kamelele/Velluneo-2.0/README.md

# Velluneo-2.0

[Projekt E27 z wymiennym wkładem LED](hardware/E27/README.md)
