kamelele/Velluneo-2.0/hardware/E27/outputs/Zasilacz_8S_D4/README.md

# Velluneo E27 8S-D4

Open [Zasilacz_8S_D4.kicad_pro](Zasilacz_8S_D4.kicad_pro) in KiCad 10.0.8. This draft adds a hardware inhibit to the 8-LED supply while its 3.3 V logic rail is low. The [70 × 34 mm board](Zasilacz_8S_D4.kicad_pcb) is an unrouted placement study.

- [Schematic](Zasilacz_8S_D4.kicad_sch)
- [3D top](8S-D4-top.png) · [3D bottom](8S-D4-bottom.png)
- [Design decision and evidence](../../workflow/8s/driver-8s-d4-inhibit.md)

Retained fault state after full rail loss, independent insulation checks and routing remain open. The earlier [D3 study](../Zasilacz_8S_Draft/README.md) is available as a baseline.
