kamelele/Velluneo-2.0/hardware/E27/outputs/Raport_E27_RevB.md

# Żarówka E27 z wymiennym wkładem LED

**Rewizja B zasilacza · prototyp laboratoryjny · 9 listopada 2026**

Płytka zasilacza ma **66 × 34 mm**, o 25,2% mniejszą powierzchnię niż Rev A. C2 (maks. 18 mm), PCB (1,6 mm) i F1 (5,35 mm) dają razem około 25 mm. Po weryfikacji rysunku RV1 dla prostych wyprowadzeń przyjęto konserwatywnie do 22 mm od góry. Daje to **około 29 mm budżetu wysokości** przed doliczeniem montażu i obudowy. Rzeczywistą wysokość RV1 ustali próbka z określonym formowaniem wyprowadzeń. Cel **38 × 17 × 15 mm** pozostaje otwarty. Płytka służy do walidacji elektrycznej poza korpusem A60. [Rysunek wymiarowy Littelfuse TMOV](https://www.littelfuse.com/assetdocs/varistors-tmov-datasheet?assetguid=bd475732-1071-4352-b8aa-f78b0007eb05)

Wkład Ø30 mm nadal ma 16 diod Cree JE2835B i dwa szeregi po osiem LED, każdy z własnym regulatorem 127 mA. Interfejs wkładu pozostaje trzystykowy (A+, K1, K2). S1 i czujnik TH1 trafiają do J2. Przewody J2/J3 lutuje się do PCB z osobnym odciążeniem mechanicznym. Dobór blokowanego złącza poza płytką, bariery korpusu i systemu prowadzenia przewodów wymaga sprawdzenia z mechaniką. Katalogowy model optyczny Rev A daje 764, 844 i 833 lm odpowiednio dla 2700, 4000 i 6500 K. Wynik zależy od binu, temperatury i dyfuzora.

W pakiecie należy otworzyć `Zasilacz_RevB/Zasilacz_RevB.kicad_pro` oraz `Wklad_LED/Wklad_LED.kicad_pro`. Dla zasilacza obowiązuje BOM Rev B. Raport Rev A zawiera dane wkładu, mechaniki i specyfikację zamówienia transformatora.

**Aktualizacja przed próbami.** W obwodzie S1 trzeba skorygować napięcie sterujące SHDN. Szczegóły są w [planie prób](Plan_prob_RevB.md).

## Ochrona wejścia i kondensatory

- **F1** to ceramiczny Schurter 3403.0271.23, T500 mA / 277 VAC. Karta podaje 1,5 kA dla 277 VAC w warunkach UL albo 250 VAC w warunkach IEC. Producent podaje typową całkę przedłukową 0,62 A²s przy 10 × In. Koordynacja wejścia w gotowym zespole oraz spodziewany prąd zwarciowy wymagają oddzielnej próby. [Schurter UMT-H](https://www.schurter.com/en/datasheet/UMT-H)
- **R1** to bezpiecznikowy Vishay AC01000902209JBMCS (22 Ω ±5%, 1 W przy 70°C). F1 i R1 są kolejno w linii L, a termicznie chroniony RV1 znajduje się za R1, równolegle do wejścia mostka. Zweryfikować energię impulsu i awarie R1/RV1, także przy rozgrzanym zespole. [Vishay AC-CS](https://www.vishay.com/docs/28909/acxxcs.pdf)
- **BR1** to onsemi MB10S, 1 kV / 0,5 A, o udarze katalogowym 35 A dla pojedynczej półfali 8,3 ms. Piny 1/2 to +/−, a 3/4 to AC. Przed obsadzeniem porównać oznaczenia części z rysunkiem onsemi i wykonać test diod. **L1** to Würth 768772102, 1 mH / 0,5 A. Typowy prąd 10% spadku indukcyjności wynosi 0,55 A, więc model rozruchu przyjmuje granicę bez wpływu L1. [onsemi MB10S](https://www.onsemi.com/download/data-sheet/pdf/mb10s-d.pdf) · [Würth 768772102](https://www.we-online.com/components/products/datasheet/768772102.pdf)
- **C2** zmniejszono z 15 do 10 µF / 450 V. Rubycon 450BXW10MEFR10X16 ma katalogową trwałość 10 000 h przy 105°C w warunkach serii. **C6** to Nichicon UCM1H471MNJ1MS 470 µF / 50 V w obudowie SMD nominalnie 12,5 × 13,5 mm, katalogowo 5000 h przy 105°C. Zmierzyć tętnienia i temperaturę obudów po stabilizacji termicznej, przy niskim i wysokim napięciu wejścia. [Rubycon, karta pozycji](https://www.digikey.com/es/products/detail/rubycon/450BXW10MEFR10X16/6049847) · [Nichicon UCM](https://www.nichicon.co.jp/english/products/pdf_x/Chip_Type_Aluminum_Electrolytic_Capacitors_E.pdf)

**Obliczenia rozruchu.** Model idealnego skoku w szczycie 253 VAC (357,8 V) dla pustego C2 przy 12 µF i R1 = 20,9 Ω daje 17,1 A na początku, 0,77 J energii zgromadzonej w C2 i 0,0368 A²s prądu ładowania. Obliczenie pomija L1, spadek mostka i impedancję sieci. Ocenę F1, mostka i R1 oprzeć na zarejestrowanych przebiegach zimnego i gorącego rozruchu oraz na danych o impulsach powtarzalnych. Przy 207 VAC, 8 µF i przyjętym poborze 8,4 W z szyny, po 10 ms bez doładowania model daje około 252 V na C2. Dla 12 µF i sumy R2 + R3 około 1,03 MΩ model daje ok. 22 s od 358 V do 60 V. Czas ten dotyczy szyny wewnętrznej. Zmierzyć go oraz czas rozładowania styków dostępnych użytkownikowi.

## Zapas napięcia i odcięcie wyjścia

Dzielnik R14/R15 to 226 kΩ i 10,0 kΩ, oba ±0,1% i ±25 ppm/K. TPS26600 nominalnie odcina przy 28,08 V. Dla progu komparatora 1,170–1,225 V i prądu wejściowego ±100 nA obliczony próg wynosi **27,54–28,99 V** przy początkowej tolerancji rezystorów. Przy osobnym skrajnym dryfcie każdego rezystora o 0,2% dla zmiany temperatury o 80 K przedział poszerza się do **27,43–29,10 V**. Analogicznie policzona górna granica Rev A wynosiła 30,24 V przy początkowej tolerancji. Te przedziały dotyczą powolnej zmiany napięcia. Zmierzyć także maksymalne chwilowe napięcie na A+ przy uszkodzeniu regulacji, rozłączeniu wkładu, krótkich impulsach i ponownych załączeniach. Celem projektu jest **≤30 V na dostępnym wyjściu** w zdefiniowanych próbach. [TI TPS26600](https://www.ti.com/lit/ds/symlink/tps2660.pdf)

Dzielnik CV R10/R11 to 110 kΩ i 5,62 kΩ, oba ±0,1%. Z zakresem odniesienia LYT6073C 1,25–1,28 V przy 25°C daje **25,67–26,38 V** przed doliczeniem przesunięcia masy czujnika prądu, tętnień i dynamiki. Górną granicę tego przedziału od obliczonego minimum OVP po dryfcie rezystorów dzieli około 1 V. W próbach sprawdzić zarówno samoczynne wyłączenia na gorąco, jak i zapas dla LED o najwyższym zimnym Vf. [Power Integrations LYTSwitch-6](https://www.power.com/sites/default/files/documents/lytswitch-6_family_datasheet.pdf?language=en)

Limit sumarycznego prądu flybacka z R9 = 0,11 Ω wynosi **326 mA typ.** przy tabelarycznym 35,90 mV. Skraje 35,17–36,62 mV i R9 ±1% dają **317–336 mA** przy 25°C. Wartość 318 mA w starszej dokumentacji korzystała z przybliżenia 35 mV. W próbie uwzględnić temperaturę i zmierzyć spadek bezpośrednio przy padach R9. [Power Integrations LYTSwitch-6, tabela parametrów wtórnych](https://www.power.com/sites/default/files/documents/lytswitch-6_family_datasheet.pdf?language=en)

## Wykonanie i kolejność prób

- Rozpocząć od prób części wtórnej z odłączoną stroną pierwotną i izolowanym zasilaczem laboratoryjnym z ograniczeniem prądu. Zmierzyć oba prądy, reakcję S1/S2 i TH1 oraz próg i dynamikę OVP. Przydatny jest sztuczny wkład z kontrolowanym Vf oraz wszystkie trzy rzeczywiste warianty LED.
- Przed próbą sieciową potwierdzić rysunek i wykonanie transformatora T1, izolację elementów przekraczających barierę, odległości całego zespołu oraz wytrzymałość przyrządu i warunki stanowiska. Puste pasmo miedzi z raportu KiCad dotyczy pliku PCB. Obudowy elementów, przewody, połączenia lutowane i montaż zmieniają geometrię zmontowanego zespołu. T1 nadal wymaga kwalifikacji dostawcy według specyfikacji Rev A.
- Zweryfikować własne pola lutownicze F1, R1 i C6 z rysunkami producentów oraz fizyczną próbką. Modele 3D części własnych przybliżają obrysy, a BR1 ma widoczne pola lutownicze bez modelu korpusu. Uzgodnić montaż dwustronny, termicznie ciężkie elementy i montaż przewodów. Gerbery oraz pliki położeń mają status do przeglądu przed zamówieniem.
- Po sprawdzeniu wejścia i zabezpieczeń zmierzyć sprawność, PF, tętnienia prądu LED, temperatury elementów, emisję i odporność EMC. Dla każdej barwy zmierzyć strumień po ustaleniu temperatury. Próby sieciowe i pojedynczych uszkodzeń prowadzić na osłoniętym stanowisku przez osobę uprawnioną do pracy z napięciem sieciowym.

Wycena części w BOM jest orientacyjna i podana na progi dystrybutorów. W obserwowanych ofertach F1 kosztował 1,9518 USD/szt., a R1 0,6691 USD/szt. przy 100 szt. Brakuje pełnej wyceny transformatora, montażu dwustronnego i wiązek. W katalogu JLCPCB dla L1 widniał zerowy stan przy sprawdzeniu. [DigiKey F1](https://www.digikey.com/en/products/detail/schurter-inc/3403-0271-23/9094779) · [DigiKey R1](https://www.digikey.com/en/products/detail/vishay-beyschlag-draloric-bc-components/AC01000902209JBMCS/28721869) · [JLCPCB L1](https://jlcpcb.com/partdetail/WurthElektronik-768772102/C7194056)
