kamelele/Velluneo-2.0/hardware/E27/workflow/8s/driver-pin-review.md

# 8S driver pin intent and protection review

Task E27-8S-PINS covers the driver only. Codex owns this document and the workflow index entry. Inputs are Velluneo commit `f24547256b1a895d7f68d739b982ea7abf709427`, approved requirements digest `3cdd9d3acd8b98e729ecd689bb8b76b2e1260cf768094b1bc6902acbba21121f`, the [circuit proposal](driver-circuit-proposal.md) and the manufacturer documents cited below. This document records the candidate physical pin assignments and the design decisions that still affect net membership. It is evidence for REQ-8S, REQ-CC and OPEN-CC. The whole-board connectivity contract and schematic-stage approval are pending.

## Pin assignments for the changed circuit

- **U1 LYT6073C-TL, InSOP-24D.** Pin 1 IS → LED_RTN; 2 GND and 5 SR → SEC_GND; 3 FB → FB divider and C8; 4 BPS → C9 and existing BPS fault-injection branch; 6 VOUT → separate VO supply; 7 FWD → R8/C7; 13 V → primary line-sense divider; 14 BPP → primary bias and bypass; 16–19 S → P_0; 24 D → T1 drain end and RCD clamp. Leave pins 8–12 open as specified, and choose to leave optional pin 15 open. Positions 20–23 have no lead in the package drawing. Grounding SR is the documented diode-rectification option. Keep SEC_GND and LED_RTN joined through the sense path only, including the intentional clamp across R9. The InSOP footprint description says 17 leads, while the manufacturer drawing shows 20 physical leads. Verify the actual geometry and pads against the drawing before using that footprint. [Power Integrations, Figure 5 and pin functions](https://www.power.com/sites/default/files/documents/lytswitch-6_family_datasheet.pdf#page=3)
- **U2 TPS26600PWPR, PWP0016A.** Pins 1/2 IN → RAW; 3 UVLO and 8 RTN → EF_RTN; 5 OVP → midpoint of the 226 kΩ/10 kΩ divider, both ±0.1%; 6 MODE → 402 kΩ to EF_RTN; 7 SHDN → S1/TH1 enable circuit; 9 GND → LED_RTN; 11 ILIM → 30.1 kΩ to EF_RTN; 12 dVdT → 47 nF to EF_RTN; 15/16 OUT → FUSED, upstream of S2. The exposed pad, library number 17, joins EF_RTN alongside pin 8. Pins 4 and 13 are NC. IMON 10 and FLT 14 are unused in the functional candidate. For a verification fixture, provide access to FLT with its own pull-up to observe OVP timing. Any production test point must be included in the final pin graph. Connect at least 0.1 µF effective local bypass on both IN and OUT to system GND (LED_RTN), with OUT bypass upstream of S2. EF_RTN remains separate from LED_RTN in the preferred candidate. TI also documents a local RTN/GND tie for applications that omit reverse-input protection. Decide whether internal RAW reversal is credible before simplifying to that option. Assess output backfeed separately. [TI TPS2660x, pin functions, §9.3.5.5, Fig. 70 and §12.1](https://www.ti.com/lit/ds/symlink/tps2660.pdf)
- **U101 TPS7A1633DGNR, DGN.** Pins 5 EN and 8 IN → RAW; 1 OUT → 3V3_PERMIT; 4 GND and pad 9 → LED_RTN in the preferred candidate. This changes the previous proposal to avoid placing the regulator and capacitor return currents on the eFuse internal RTN reference. Pin 2 is DNC on the fixed-voltage device. Leave 3 PG, 6 NC and 7 DELAY open because this candidate uses the eFuse ramp and no regulator power-good reset. Return both local regulator capacitors to LED_RTN and size the output capacitor for at least 2.2 µF effective. The 1 kΩ series resistor and 10 kΩ pull-down set a nominal ~3.0 V SHDN high when the loop is closed. Return the SHDN pull-down to LED_RTN. Closed-loop DC load is about 0.30 mA before SHDN pin current. As a part-count alternative, screen a RAW-fed 91 kΩ/10 kΩ permit divider. Ideal SHDN is 1.41 V at 14.25 V RAW and 3.37 V at 34 V RAW. A passive implementation still needs leakage, transient, contact and short-latch checks. Check SHDN at both references through start-up and input transients, including regulator pass short. Use an output capacitor rated for the credible fault voltage after derating, or bound that voltage independently. Keep eFuse mode, ramp, OVP and ILIM networks on EF_RTN. Confirm dry-contact operation of S1 and TH1 at that current and the lowest voltage. [TI TPS7A16, section 5](https://www.ti.com/lit/ds/symlink/tps7a16.pdf#page=4) · [TI reference with DGN exposed pad 9](https://www.ti.com/lit/ug/tiduep8/tiduep8.pdf)
- **External ports.** J_LED-1 → LED+ after S2. J_LED-2 → LED_RTN. Put the discharge resistor across those two driver terminals. J2-1 → 3V3_PERMIT side of the S1/TH1 loop; J2-2 → return to the SHDN bias network; J2-3 → FUSED; J2-4 → LED+. The proposed functional order is contacts mate, S2 closes, then S1 permits output. Confirm physical contact numbering, keying, minimum contact load and contact sequence before approving the whole-board pin graph.
- **Power stage interface.** T1 winding-end assignments are provisional: primary dot 2 at P_BULK, pin 1 to drain; auxiliary dot 4 at P_0, pin 3 to P_AUX; secondary dot 6 at S_SW, pin 5 to RAW. Winding polarity and the end-to-pad mapping need a controlled drawing from the transformer supplier. Use the Rev G RFQ as the starting drawing with the new operating point. The independent high-voltage and high-current corners give 27.07 V × 285 mA ≈ 7.7 W as an upper sizing screen, versus 6.60 W in the Rev G quote basis. Recheck hot saturation, leakage, diode and FWD ringing, AUX bias and RCD stress. [Rev G transformer RFQ](../../outputs/Zasilacz_RevG_Moc/RFQ_T1_EE16.md)

## Voltage window and protection behavior

The following are calculated screening conditions. They use the 25°C flyback CV limits 26.33–27.07 V and the previously calculated eFuse limits. Use `delta = V(EF_RTN) − V(LED_RTN)` as a signed input. Characterize it with the actual control network connected.

- **Nuisance trip:** ignoring the small sense drop for conservative no-load screening, the lowest estimated eFuse rising threshold minus maximum CV is 27.54 − 27.07 = **0.47 V**, before reference offset and ripple. The design condition is `V(RAW relative to LED_RTN, normal peak) < 27.54 V + delta_min`, with margin for tolerances.
- **Contact voltage:** high static trip is 28.99 V relative to EF_RTN. Reserve **1.01 V minus delta_max** for dynamic effects, uncertainty and any required margin to 30 V, before crediting series drops. The TI +0.3 V RTN-to-GND absolute-maximum limit is a stress rating. An open top resistor or shorted bottom resistor can select the factory 31–34 V OVP, so these divider faults require the independent flyback bound to hold. As a sensitivity point only, +0.30 V leaves about **0.71 V**. The datasheet’s typical OVP timing is to FLT. Verify actual peak and FET turn-off independently on RAW, FUSED and both contacts.
- **Recovery:** the falling threshold can be 25.53–26.62 V relative to EF_RTN. At delta = 0, a 27.07 V no-load bus can remain above the highest rearm threshold by 0.45 V and above the lowest by 1.54 V. Cycling SHDN clears an overload latch, while recovery from OVP still requires RAW to fall below the falling threshold. Treat mains removal and restoration after a genuine trip as a candidate recovery method. Verify that normal insertion and all input ramps avoid nuisance trips. If automatic recovery is required, the present CV/OVP pairing needs a controlled reset of RAW or another protection topology.
- **Discharge:** with 4.7 kΩ +1%, 10 µF and no leakage, the 30-to-5 V decay takes **85.1 ms** after isolation, leaving **14.9 ms** for switch and circuit delays. At 30 V the resistor dissipates up to **0.194 W** at −1%. A 10 kΩ ±1% alternative with ≤4.7 µF gives **85.1 ms** and ≤0.091 W. Prefer the lower-loss option only after total accessible-side capacitance, leakage and measured timing justify it. In a stuck-S2 test include the eFuse OUT bypass, and capture whether opening S1 still removes energy. The reservoir upstream stores about **0.168 J** at 470 µF and 26.70 V. Test the pulse under normal hot insertion and separately assess the shorted-eFuse case with S2 operating. [TI TPS2660x, electrical and timing characteristics](https://www.ti.com/lit/ds/symlink/tps2660.pdf) · [Prior protection study](output-protection-study.md)

## Corrections from the baseline review

- **D8 polarity.** The previous proposal reversed the archived Rev K clamp. For the positive short transient, the candidate preserves Rev K polarity: D8 anode to LED_RTN and cathode to SEC_GND. The Power Integrations diode example uses the same positive-transient clamp function. The forward drop of a diode alone cannot establish compliance with all IS limits. Capture both polarities, including the energy from C6. The 27 V absolute maximum at VO also requires checking the pass regulator, including its shorted condition. The internal VO bleed acts through that regulator and cannot be credited as a guaranteed RAW bleed. [Power Integrations, Fig. 10 and absolute maximum ratings](https://www.power.com/sites/default/files/documents/lytswitch-6_family_datasheet.pdf#page=10)
- **Short-circuit latch.** The 402 kΩ mode selects active current limiting with latch-off on eFuse thermal shutdown. The 30.1 kΩ ILIM sets roughly 0.40 A nominal, above the flyback's ~0.285 A high corner. A sustained current-limited fault may never thermally latch U2, so eFuse alone does not carry forward the old comparator/latch behavior. Keep an explicit short-circuit detection and reset function in the design budget. Evaluate a single output voltage monitor with start-up blanking and a latch driving SHDN. It must cover a hard short present at enable, avoid a false trip during the ramp, and retain safe state during a RAW collapse. Set the monitor threshold only after separating the short-fault and minimum healthy output envelopes. Verify partial shorts and open string separately. Healthy 8S and faulted 7S string voltage distributions can overlap, so a partial-short voltage threshold needs evidence before it can be credited. [TI TPS2660x operating modes](https://www.ti.com/lit/ds/symlink/tps2660.pdf) · [Rev H controller baseline](../../outputs/Zasilacz_RevH_Sterowanie/README.md)

## JLCPCB candidate parts and sample acceptance

- R10, 113 kΩ ±0.1%, 0603: Yageo RT0603BRD07113KL, JLCPCB C705718. The listed 25 ppm/°C TCR enters the CV temperature budget together with the lower divider resistor. [JLCPCB part](https://jlcpcb.com/partdetail/YAGEO-RT0603BRD07113KL/C705718)
- R9, 130 mΩ ±1%: first review the TA-I RLH12FTCR130, 1206, 100 ppm/°C, JLCPCB C2683382. At a 75°C rise its TCR contribution is at most 0.75%, versus 4.5% for the compact Yageo RL0805FR-070R13L, 0805, 600 ppm/°C, C728482. Nominal R9 power at 285 mA is only 10.6 mW. Choose the larger candidate for tighter current drift and compare its pulse rating and Kelvin placement. The IC comparator’s 25°C current limits remain separate from resistor drift. [JLCPCB 1206 part](https://jlcpcb.com/partdetail/TA_ITech-RLH12FTCR130/C2683382) · [JLCPCB 0805 part](https://jlcpcb.com/partdetail/YAGEO-RL0805FR070R13L/C728482)
- MODE resistor: Yageo RC0603FR-07402KL, 402 kΩ ±1%, 0603, JLCPCB C874662. Bleeder: ROHM ESR18EZPF4701, 4.7 kΩ ±1%, 0.5 W, 1206, JLCPCB C3994590. Confirm the parts, thermal derating and supply at quote time. [JLCPCB MODE resistor](https://jlcpcb.com/partdetail/YAGEO-RC0603FR07402KL/C874662) · [JLCPCB bleeder](https://jlcpcb.com/partdetail/ROHMSemicon-ESR18EZPF4701/C3994590)
- Before releasing a KiCad capture packet, complete the physical connector and transformer definitions, resolve the OVP reset/offset and current-clamp and short-latch issues, and perform independent review of the complete pin graph. The cold string screen is still 25.6 V plus the path and ripple budget. Obtain forward-voltage evidence at the selected lowest operating temperature and upper current corner before freezing the regulator values.

## Independent reviews of the starting proposal

All four reviewers were read-only and reviewed commit `f24547256b1a895d7f68d739b982ea7abf709427`. Their findings informed this follow-up. The revised whole-board pin graph remains due for independent review.

- Reality Checker `/root/reality`: TPS26600 pin groups, local bypass return, external loading of RTN, OVP reset and contact-voltage budget.
- Completeness Reviewer `/root/completeness`: LYTSwitch-6 physical leads, archived D8 polarity, VO supply limits, transformer and primary-side dependencies.
- Change Reviewer `/root/change`: removed Rev H channel fault handling, eFuse behavior at the new current, positive sense pulses and regulator pass-short effects.
- Overengineering Reviewer `/root/scope`: minimal fail-off S1/TH1 path, independent S2, single monitor for output fault detection and conditional RTN/GND simplification.

The standalone toolkit schematic requirements check was rerun. It reports OPEN-CC, REQ-8S and REQ-CC as open. Its fresh JSON content matches the tracked [schematic requirements check](schematic-prep-check.json). The active design remains at pin-intent preparation.
