kamelele/Velluneo-2.0/hardware/E27/workflow/8s/task-contract.md

# Task contract — E27-8S-SPEC

- Stage is specification. Parent is the project owner's 2026-11-11 decision to change to eight LEDs in one series string.
- Codex owns the specification work and integration. The project owner is the authorized stage reviewer.
- Base is Velluneo commit `a8b2ee8fc110c338037cb6391b1e41e378b3445e`. Historical CAD baseline is `239eeee4522100944dae18d29fecb506b6db07f1`. Toolkit is 0.7.1 at `86614c3b9b43713031e0ea481edbe26b71cd1b8f`.
- Scope is the 8S feasibility calculation, product and interface requirements, fabrication and assembly proposals, bench evidence plan, and review packet. Codex holds the write assignment for the files under `workflow/8s` and `workflow/project-index.md`. The next stage requires its own CAD and library assignment.
- Acceptance for this task requires traceable inputs, independently checkable calculations, explicit owners and gates for unknowns, and an actual requirements-check result. The stage decision must identify the frozen packet revision.
- Handoff is the [specification](specification.md), [requirements](requirements.json) and [stage packet](stage-packet.md).
