kamelele/Velluneo-2.0/hardware/E27/outputs/Zasilacz_RevH_Moc/Studium_valley_fill.md

# Studium korekcji prądu wejściowego · valley-fill

Pasywny układ valley-fill ładuje dwa kondensatory szeregowo i dołącza je równolegle do szyny w okolicy zera sieci. Dłuższy pobór prądu w półokresie zmniejsza harmoniczne. Wariant badawczy zachowuje izolowany stopień flyback i wymaga przeprojektowania jego wejścia. [Opis topologii TI](https://www.ti.com/lit/ds/symlink/lm3444.pdf)

## Wynik modelu

- Dwa kondensatory **3,3 µF ±20%** i rezystor ładowania **180 Ω ±5%** zbadano przy 207, 230 i 253 VAC. Model uwzględnia osobne napięcia kondensatorów, nierówną pojemność oraz założone rezystancje szeregowe 8, 30 i 75 Ω na kondensator. W 144 kombinacjach przy obciążeniu 7,8–8,4 W najniższy PF wynosi ok. **0,885**, a najwyższe THDi ok. **51%**. Przy 230 VAC największe modelowe I3/I1, I5/I1 i I7/I1 wynoszą odpowiednio ok. **24%, 23% i 27%**. Przy 253 VAC I7/I1 dochodzi do **30%**. To wyniki uproszczenia z symetryczną siecią. Pomiar harmonicznych obejmuje kompletne urządzenie i wszystkie mające zastosowanie warunki normy. [Przypadki tolerancji](Model_valley_fill_tolerancje.csv) · [IEC 61000-3-2](https://webstore.iec.ch/en/publication/92799)
- Przykład z dwiema pojemnościami 10 µF i 68 Ω daje przy 230 VAC PF **0,87** i minimum szyny **150 V**. Zwiększenie pojemności zwiększa jednak siódmą harmoniczną do ok. **38%** składowej podstawowej w tym przykładzie. Sam PF nie wystarcza do oceny emisji. [Przemiatanie pojemności i rezystancji](Model_valley_fill.csv)
- Przy 207 VAC minimum szyny dla wariantu 3,3 µF wynosi **103 V** w najbardziej wymagającej kombinacji z modelu. Przy 253 VAC maksymalne napięcie każdego kondensatora w stanie ustalonym wynosi ok. **181 V**. Model nie obejmuje załączeń, zwarcia lub przerwy elementu, niezależnego ESR każdego kondensatora, składowej przełączania ani udarów. Stan ustalony dla dwóch równych pojemności z małym ESR porównano z prostszym modelem.
- Dla Lp = 1,104 mH, Ipk = 0,511 A i 8,4 W idealny DCM wymaga ok. **58 kHz**. Przy szynie 103 V i napięciu odbitym 97 V oszacowane czasy magnesowania i rozmagnesowania to **5,5 i 5,8 µs**, w porównaniu z okresem **17,2 µs**. Zapas maleje przez opóźnienia i zależność limitu od częstotliwości oraz nachylenia prądu. R6/R7 w okolicy 2 × 1,8 MΩ obniża katalogowe oszacowanie brown-in do około 103 V. Trzeba zmierzyć start, częstotliwość, Ipk i tętnienia 26 V przy najniższej sieci. [Karta LYTSwitch-6](https://www.power.com/sites/default/files/documents/lytswitch-6_family_datasheet.pdf)

## Wpływ kondensatora HF

Drugi model obejmuje L1 1,2 mH oraz pojemność HF od 0,12 do 1,0 µF bezpośrednio przy przetwornicy. Kondensator zmienia prąd także przy częstotliwości sieci, więc wyniki modelu bez niego pokazują górny potencjał układu. Przy 230 VAC, 0,12 µF efektywnie i rozrzucie kondensatorów valley-fill dolny PF wyniósł **0,861**, maksymalne THDi **51%**, a I3/I1 ok. **32%**. Z 0,30 µF dolny PF spadł do **0,800**, a I3/I1 wzrosło do **43%**. Przy 253 VAC i 0,12 µF I9/I1 dochodzi do ok. **20%**, więc zapas w tej kombinacji jest mały. [Model z kondensatorem HF](Model_valley_fill_HF.csv)

Dla 0,12 µF efektywnie i poboru 8,4 W przy 65 kHz i 103 V uproszczone tętnienie na impuls wynosi ok. **10 V**, gdy kondensator dostarcza cały ładunek cyklu. Pierwszy punkt do strojenia to nominalne 150 nF / 630 V X7T oraz pole pod dodatkową pojemność. Oba warunki trzeba mierzyć razem. Mniejsza pojemność pomaga ograniczyć harmoniczne, większa zmniejsza zapad szyny przy przełączeniu. [Przykładowy C18 TDK](https://product.tdk.com/en/search/capacitor/ceramic/mlcc/info?part_no=C3225X7T2J154K200AC)

## Części i gabaryt

- Pierwszy kandydat na kondensatory to dwa Rubycon 400LEX3R3MEFC8X11.5, **400 V, Ø8 × 11,5 mm**. Każdy ma znamionowo 47 mA przy 120 Hz i 94 mA przy 100 kHz w warunkach serii. Modelowa składowa sieciowa dochodzi do ok. 30 mA. Napięcie 400 V daje rezerwę przy nierównym podziale i wymaga weryfikacji przy awarii oraz udarze. [Karta Rubycon LEX](https://www.rubycon.co.jp/wp-content/uploads/catalog-aluminum/LEX.pdf) · [Kod C1594629](https://www.lcsc.com/product-detail/C1594629.html)
- Krótsza średnica jest osiągalna z AISHI EGW2GM3R3E12OTG 400 V, Ø6,3 × 12 mm. Tę obudowę wybrano do studium położenia. [AISHI w LCSC](https://www.lcsc.com/product-detail/C2990968.html)
- W pierwotnym miejscu C2 jest miejsce na jeden element Ø8 mm. Przeszukanie obrysu Rev H w kroku 0,2 mm znalazło parę położeń dla dwóch korpusów Ø8,5 mm po odsunięciu L1. Do sprawdzenia pozostają pady, dodatkowe diody, rezystory rozładowujące, szeregowy ogranicznik ładowania i miedź. Kandydat na niższy L1 to Würth 768775312, 1,2 mH, 0,28 A, 400 V DC i wysokość do 5,4 mm. Po zmianie trzeba powtórzyć ocenę udaru i EMI. [Karta Würth](https://www.we-online.com/components/products/datasheet/768775312.pdf)
- Przy bezpośrednim zasilaniu szyny z prostownika lokalny kondensator HF musi przejmować impulsy flyback. Przy 8,4 W, 65 kHz i 103 V oszacowana porcja ładunku wynosi ok. 1,25 µC na cykl. Z efektywnych 0,30 µF daje to ok. 4,2 V tętnień od samego ładunku. Ustalić zapas pojemności przy polaryzacji DC, pracę przy niskiej szynie, napięcie znamionowe oraz małą pętlę T1/U1/kondensator.

Rev H pozostaje wersją z udokumentowanym PCB do wyceny. Rozmieszczenie zapisano w [studium Rev J](../Studium_RevJ_ValleyFill/README.md). Wariant valley-fill po trasowaniu wymaga prób 26 V, rozruchu, PF i harmonicznych oraz ponownego pomiaru RCD.
