kamelele/Velluneo-2.0/hardware/E27/outputs/Zasilacz_RevH_Moc/Tlumienie_D7.md

# D7 i wejście FWD · próba tłumienia

D7 to prostownik SK3200B-LTP o napięciu wstecznym 200 V. Wejście FWD LYT6073C połączone z węzłem S_SW przez 47 Ω ma limit −1,5 do +150 V. W okresie włączenia klucza S_SW jest w przybliżeniu równe S_RAW + Vszyny × Ns/Np. Przy 253 VAC, 26 V i 23:84 daje to ok. **124 V** przed dzwonieniem. Do celu rozwojowego **135 V** na FWD pozostaje ok. **11 V**. Przełączenia oraz indukcyjności transformatora, ścieżek i sondy mogą zmienić amplitudę oraz czas trwania. [MCC SK3200B-L](https://www.mccsemi.com/pdf/Products/SK3200B-L%28SMB%29.pdf) · [Power Integrations LYTSwitch-6](https://www.power.com/sites/default/files/documents/lytswitch-6_family_datasheet.pdf)

C16 łączy S_SW z S_DAMP. R23 łączy S_DAMP z S_GND. Gałąź szeregowa leży równolegle do D7, a istniejący R8/C7 pozostaje w torze FWD. R23 ma obudowę 0805. C16 ma obudowę 1206, aby zapewnić wybór kondensatorów C0G o odpowiednim napięciu. Pierwsze uruchomienie przewidziano z obiema pozycjami pustymi.

1. Na zabezpieczonym stanowisku zmierzyć równolegle S_SW względem S_GND i FWD przy pinie układu. Ograniczyć indukcyjność połączenia sondy. Porównać 207, 230 i 253 VAC, 0–254 mA, rozruch, odłączanie obciążenia, zapad i pracę w stanie nagrzanym. Sondy i stanowisko muszą uwzględniać izolację obu stron.
2. Gdy występuje nadmierne dzwonienie, wyznaczyć częstotliwość f0 i powtórzyć pomiar z kondensatorem próbnym równolegle do D7. Z częstotliwości f1 obliczyć Cpar = Ctest/((f0/f1)² − 1) i Lpar = 1/((2π f0)² Cpar). Pierwszą wartość R można oszacować z √(Lpar/Cpar). Następnie stroić oba elementy w układzie z możliwie krótkim połączeniem. [Metoda pomiarowa TI](https://www.ti.com/lit/ta/ssztbc7/ssztbc7.pdf)
3. Dla orientacji pełny cykl ładowania i rozładowania daje P ≈ C × ΔV² × f. Przy 124 V i 80 kHz to **0,123 W dla 100 pF**, **0,185 W dla 150 pF** i **0,271 W dla 220 pF**. To pokazuje koszt cieplny, który rośnie przy większej amplitudzie i częstotliwości. R23 wymaga rezystora impulsowego z potwierdzoną mocą w temperaturze PCB. Jeżeli strojenie wymaga większej pojemności i obciążenia, zweryfikować obudowę, pętlę i rozpraszanie przed obsadzeniem seryjnym.
4. Zestawić przebiegi przed i po zmianie. Do przyjęcia wymagana jest amplituda FWD mieszcząca się w założonych limitach, prawidłowy start i regulacja przy niskim obciążeniu oraz akceptowalna temperatura R23, D7 i C6. Zmiana dzwonienia może wpłynąć na wykrywanie doliny przez sterownik, więc potwierdzić pobór mocy, tętnienia i zachowanie EMC.

Przy tym samym układzie R9 0,11 Ω ±1% i katalogowym progu 35,17–36,62 mV w 25°C statyczny zakres wynosi ok. 317–336 mA po pominięciu rezystancji wspólnej, dryftu i zakłóceń. Na próbie porównać napięcie bezpośrednio na R9 z napięciem IS–GND przy U1. D7, D8, R9 oraz kondensator C6 wymagają sprawdzenia także przy ograniczonym energetycznie zwarciu próbki. [Power Integrations, parametry i prowadzenie IS](https://www.power.com/sites/default/files/documents/lytswitch-6_family_datasheet.pdf)
