kamelele/Velluneo-2.0/hardware/E27/outputs/Studium_RevE/Kontrola_RevE.md

# Kontrola rozmieszczenia Rev E

- E_Jedna, 74 × 32 mm i 93 obrysów obudów. Pas między padami stron P/S w osi X wynosi 8.20 mm. KiCad zgłasza 0 naruszeń reguł oraz 192 niepołączonych padów.
- E_Moc, 57 × 32 mm i 40 obrysów obudów. Pas między padami stron P/S w osi X wynosi 8.20 mm. KiCad zgłasza 0 naruszeń reguł oraz 73 niepołączonych padów.
- E_Sterowanie, 30 × 26 mm i 55 obrysów obudów. Wyłącznie sieci wtórne. KiCad zgłasza 0 naruszeń reguł oraz 121 niepołączonych padów.

Porównano wszystkie oryginalne przypisania pinów, położenia obrysów na obu stronach i kolizje z padami otworów po stronie przeciwnej. Dwa nowe punkty wiązki mają identyczną polaryzację. Zapisane płytki nie zawierają ścieżek ani wypełnień. Wymagane są ponowne trasowanie, kontrola pętli mocy, pełny DRC oraz projekt pól cieplnych.
