kamelele/Velluneo-2.0/hardware/E27/outputs/Raport_E27_RevA.md

# Żarówka E27 z wymiennym modułem LED

**Rewizja A · Projekt laboratoryjny · 9 listopada 2026**

## Decyzje konstrukcyjne

Wkład ma 16 diod Cree JE2835B 3 V N Class na jednostronnej aluminiowej MCPCB nominalnie Ø30 mm, ze ścięciem pozycjonującym. Dwa szeregi po osiem LED dzielą anodę. Każdy ma własny powrót do niezależnego regulatora prądu w korpusie. Trzy wersje mają ten sam układ, styki i mocowanie. Zmienia się MPN i zamówiony bin strumienia diod.

Zasilacz laboratoryjny to izolowany flyback **LYT6073C-TL** z nominalną szyną **26,0 V**, ograniczeniem sumarycznym około 318 mA, dwiema pętlami **AL5812MP-13 po 127 mA** i niezależnym wyłącznikiem nadnapięciowym **TPS26600PWPR**. Użytkownik zdejmuje klosz, ale od strony wkładu nadal oddziela go stała przegroda od całej sekcji sieciowej. Wyjście jest projektowane jako pływający obwód SELV. Klasyfikację i skuteczność ochrony potwierdza badanie kompletnej konstrukcji.

Płytka zasilacza ma **75 × 40 mm**, a najwyższy dobrany kondensator ma do 22 mm. Jest to wersja do testów na stanowisku. Nie mieści się w pierwotnym obrysie 38 × 17 × 15 mm ani w docelowym korpusie A60. Wymiary radiatora i mechanizmu niżej dotyczą geometrii produktu po miniaturyzacji. Elementy mechanizmu, transformator oraz wzmacniana izolacja gotowego zespołu wymagają kwalifikacji przed wykonaniem prototypu sieciowego.

## 1. Diody, prąd i strumień

Dane dla Cree JE2835BWT-N-H27EA0000-N0000001, JE2835BWT-N-H40EA0000-N0000001 i JE2835BWT-N-H65EA0000-N0000001 przy 150 mA. Minimum CRI wynosi 80. Typowy Vf wynosi 2,86 V przy 25°C, maks. 3,00 V w warunkach tego testu. Prąd katalogowy do 240 mA podlega ograniczeniom termicznym, a maks. Tj wynosi 125°C. Typowa rezystancja termiczna złącze–punkt lutowniczy wynosi 11 K/W. [Cree CLJ-DS40, s. 14–18 i 57](https://downloads.cree-led.com/files/ds/j/JSeries-2835-3V-Consolidated.pdf)

| CCT | Min. / typ. przy 25°C [lm/LED] | Typ. przy 85°C [lm/LED] | Typ. skuteczność przy 25°C, 150 mA [lm/W] | Model przy 127 mA, 85°C i transmisji 0,87 [lm po kloszu] |
|---|---:|---:|---:|---:|
| 2700 K | 69 / 70,7 | 63,8 | 165 | 764 |
| 4000 K | 75 / 78,1 | 70,5 | 182 | 844 |
| 6500 K | 75 / 77,1 | 69,6 | 180 | 833 |

Model ma postać Φ = 16 × Φ₁₅₀,₈₅ × f(I) × τ. Przy 127 mA przyjęto f ≈ 0,86 z wykresu i τ = 0,87 dla całego toru optycznego. To przybliżenie typowe. Przy 130 mA, f ≈ 0,88, prognoza wynosi **782 / 864 / 852 lm**. Przy 120 mA, f ≈ 0,82, wynosi **728 / 805 / 794 lm**. Ustawienie 127 mA przez 5,90 kΩ (750 / RSET) daje najlepszy punkt startowy spośród tych trzech. Temperatura i dyfuzor mają wpływ porównywalny z regulacją prądu o kilka miliamperów. Przy transmisji 0,83 i Tj = 100°C ciepły wariant typowy może zejść do około 709 lm. [Charakterystyki Cree](https://downloads.cree-led.com/files/ds/j/JSeries-2835-3V-Consolidated.pdf) · [RSET AL5812](https://www.diodes.com/datasheet/download/AL5812.pdf)

**Dobór produkcyjny.** Zamówić próbki w przedziałach 72–75 lm dla 2700 K i 75–78 lm dla 4000/6500 K, o ile producent udostępni odpowiednie biny razem z wymaganym binem Vf. Przedziały są wymaganiem RFQ, a MPN sam w sobie definiuje dolną granicę, zatem dostawca może wysłać wyższy bin. Przy nominalnych warunkach modelu daje to około 778–810 i 810–842 lm. Potwierdzić Vf kompletnych szeregów przy zimnym starcie, tolerancję obu AL5812, transmisję gotowego klosza i gorący strumień co najmniej na trzech wkładach każdej barwy. Do rozpoczęcia serii potrzebne są próbki z kilku partii. Jeśli jedna wartość prądu i kontrola binów okażą się niewystarczające, każda barwa potrzebuje odrębnej kwalifikacji optycznej, a decyzję o zmianie interfejsu należy podjąć po pomiarach. [Biny Cree](https://downloads.cree-led.com/files/ds/j/JSeries-2835-3V-Consolidated.pdf)

Dla przyjętego minimum chwilowego 25,3 V przed eFuse i rezerwy 0,9 V na regulator, eFuse i tor styków celem kwalifikacji jest maks. **24,4 V na całym zimnym szeregu** przy nastawionym prądzie. Wartości są założeniem do pomiaru w pełnym zakresie temperatury, tętnień i tolerancji. Przy zaniku zapasu regulator wyjdzie z zakresu CC, co może obniżyć strumień i pogorszyć migotanie.

**Alternatywy.** LUXEON 2835 Architectural 3 V L128-2780CA3500001, L128-4080CA3500001 i L128-6580CA35000T1 mają typowo 58,2 / 63,8 / 62,5 lm przy 120 mA i ok. 162–177 lm/W w warunkach producenta. To dobry drugi dostawca do prób po sprawdzeniu padów, polaryzacji, Vf, dostępności i termiki. Lumileds Commercial 3 V jest binowana przy 65 mA, więc do porównania na 127 mA potrzeba wykresu oraz badania obciążenia. Nichia NFSW757GT-V3 to kandydat na projekt o większej liczbie diod i mniejszym prądzie jednostkowym. Wymaga dopasowania land pattern i pomiaru strumienia dla wszystkich CCT. Pozostawiono Cree ze względu na dane przy 85°C i potwierdzone oferty katalogowe. Żadnej alternatywy nie zakwalifikowano jako zamiennika 1:1. [Lumileds Architectural](https://lumileds.com/products/mid-power-leds/luxeon-2835-architectural/) · [Lumileds Commercial](https://lumileds.com/products/mid-power-leds/luxeon-2835-commercial/) · [Nichia](https://led-ld.nichia.co.jp/api/data/spec/led/NFSW757GT-V3%285281B%29R70%20R8000%20R9050.pdf)

## 2. Architektura i konstrukcje referencyjne

- **A, wybrany** — 2 × 8 LED, 3 styki, około 22–24 V na szeregu i 26,0 V przed regulatorami. Dwa niezależne prądy nie rozjeżdżają się przy różnym Vf. Otwarty szereg pozostawia drugi zasilony własnym prądem. Stratę na obu liniowych regulatorach szacuję na 0,6–1,0 W, zależnie od Vf.
- **B** — 16S, 2 styki i pojedyncza pętla CC. Przy typowych 2,80 V to 44,8 V, a przy 3,00 V to 48 V przed poprawką na temperaturę. Wyjście bez wkładu wymaga OVP z zapasem do zimnego Vf, osobnego limitu w awarii oraz kontroli energii i czasu rozładowania. Otwarta LED gasi całość. Wariant może odzyskać około 0,7–0,9 W strat regulatorów, ale wymaga innego transformatora i większej ochrony dostępnych styków. Napięcie określone dla SELV zależy od normy, warunków dostępu i charakteru przebiegu.
- **C** — wyjście CV i dwa przetwornikowe kanały CC. Można zejść poniżej typowych strat liniowych, zwłaszcza gdy szyna ma wyższe napięcie, lecz dochodzą dwa dławiki i węzły przełączające. Wariant 4 × 4 przy 13 V zwiększa prąd sumaryczny do około 0,51 A i wymaga większej liczby styków lub regulatorów na wkładzie. Połączenie dwóch szeregów równolegle do jednego źródła CC może przeciążyć sprawny szereg po przerwie w drugim i zostało odrzucone.
- **Moduł gotowy** — IRM-10-24 (45,7 × 25,4 × 21,5 mm) daje dostępny punkt odniesienia dla zasilacza izolowanego i do testów niskonapięciowych z kwalifikowanymi binami. Jego 24 V z tolerancją ±2,5% i tętnieniami nie zapewnia dostatecznego zapasu AL5812 dla dowolnego zimnego szeregu 8S. Bezpośrednie próby optyczne prowadzić z laboratoryjnego izolowanego źródła o nastawianym prądzie. [Mean Well IRM-10](https://www.meanwell.com/Upload/PDF/IRM-10/IRM-10-SPEC.PDF)

| Referencja | Dane i porównanie | Wniosek dla E27 |
|---|---|---|
| TI SNAA290 | Nieizolowany buck-boost DCM UCC28722 + BJT, element magnetyczny EE13 ok. 735 µH. Przy 230 V i nastawie ok. 8 W TI podaje sprawność 85,95% i PF 0,493. | Użyteczny punkt kosztowy i odniesienie dla rozruchu oraz EMI. Brak odpowiedniej izolacji wyklucza użycie jako zasilacza wkładu. |
| PI RDR-251 | LNK457DG, nieizolowany, ok. 5 W, 350 mA przy 12–18 V, PF >0,9, raport deklaruje >73% ze ściemniaczem i >78% bez niego. Dodatkowy damper i bleeder dla TRIAC. | Układ pokazuje kompaktowe filtry i ochronę open/short. Ściemnianie nie jest częścią Rev A. |
| TI PMP30281 | Izolowany PSR z UCC28722 i BJT FJP2160D. 24 V/300 mA i 5 V/400 mA, rodzina dokumentów 85–480 VAC. BOM Rev B obejmuje T1 Würth 750317104, 1,5 mH, obudowę 25 × 22,2 mm, dwa elektrolity 33 µF/400 V oraz duży element X2. | Rzeczywisty przykład izolowanego PSR, lecz przewymiarowany dla obudowy E27. Przejście na jedno wyjście wymaga nowych uzwojeń, sprawdzenia PSR i ograniczenia napięcia bez obciążenia. Pełny PDF schematu TI nie był dostępny do odczytu w tym środowisku. |
| PI DER-617 | LYT6063C, izolowany CV/CC 24 V/350 mA, 8,4 W, sprawność >84% i PF >0,9 w referencji. EE1621 1,55 mH, uzwojenia 67:18:10. Osobny dławik EE10 1,2 mH i dwie szybkie diody w gałęzi boost-PFC, ok. 38 obsadzonych pozycji BOM przed punktami testowymi. OVP, auto-restart, regulacja termiczna. | Najbliższy punkt wyjścia do projektu. Układ Rev A używa wersji 725 V i pomija gałąź boost-PFC, więc wyniki PF, EMI i sprawności DER nie przenoszą się na Rev A. |
| PI DER-646 | Izolowany 9 W, 30 V/300 mA, LYT6063C, przełączany valley-fill i bardziej rozbudowana regulacja. | Dowód możliwości pracy rodziny z wyższym napięciem wyjścia przy osobnym zasileniu pinu VO. Złożony PFC nie jest pierwszym wyborem do miniaturyzacji. |
| ST EVLHVLED815W8CV | Izolowany PSR, EP13, 200–265 V AC, 25 V ±5%, do 310 mA, sprawność >87% i PF >0,90 w danych referencji. | Najbliższa alternatywa kosztowo-gabarytowa. Wymaga dostosowania transformatora, sprawdzenia OVP i osobnych kanałów CC. |
| onsemi NCL30085FLYGEVB | Izolowany flyback PSR z zewnętrznym MOSFET-em i płytką referencyjną. | Alternatywa o większym nakładzie na strojenie uzwojenia pomocniczego i osobną ochronę wyjścia. |
| Infineon ICL8810 | Rodzina sterowników flyback z zewnętrznym MOSFET-em, referencja 42 W PSR. | Większa elastyczność i inne zastosowanie mocy. Referencja 42 W nie jest porównywalna gabarytowo z E27 8 W. |

Gabaryty fizyczne, koszty i bieżące stany referencyjnych płytek ewaluacyjnych są nieporównywalne bez kompletnego rysunku mechanicznego i ofert. UCC28722 i HVLED815PF pozostają opcjami kosztowymi. LYT6073C-TL wybrano ze względu na zintegrowany klucz 725 V, regulację po wtórnej, rozwiązania zabezpieczeń i dostępność katalogową lepszą od LYT6063C-TL w sprawdzonych ofertach. [TI SNAA290](https://www.ti.com/lit/an/snaa290/snaa290.pdf) · [PI RDR-251](https://www.mouser.com/datasheet/2/328/rdr251-13861.pdf) · [TI PMP30281](https://www.ti.com/tool/PMP30281) · [TI BOM](https://www.ti.com/lit/pdf/tidry18) · [PI DER-617](https://www.power.com/design-support/design-examples/der-617-8pt4-w-high-power-factor-isolated-flyback-led-driver) · [PI DER-646](https://www.power.com/sites/default/files/documents/der-646_9w_wide-range_isolated_flyback_with_switched_valley-fill_bluetooth_track_light_using_lytswitch-6.pdf) · [ST](https://www.st.com/resource/en/data_brief/evlhvled815w8cv.pdf) · [onsemi](https://www.onsemi.com/pub/Collateral/EVBUM2287-D.PDF) · [Infineon](https://www.infineon.com/evaluation-board/REF-ICL8810-LED-42W-PSR) · [DigiKey LYT6073C](https://www.digikey.ca/en/products/detail/power-integrations/LYT6073C-TL/8346132)

## 3. Schemat zasilacza i zadanie dla dostawcy transformatora

Zakres projektowy wejścia to 207–253 V AC, 50 Hz. Bezpiecznik, termicznie odłączany MOV, rezystor impulsowy, mostek 1 kV, filtr różnicowy i zbiornik 450 V tworzą wejście. Kształt prądu wejściowego będzie impulsowy. Zmierzyć oddzielnie PF, DF, poszczególne harmoniczne oraz emisję przewodzoną. W razie negatywnego wyniku przejść na stopień z kształtowaniem prądu wejściowego, korzystając z DER-617 albo ST. Zwiększenie pojemności zbiornika dla poprawy tętnień wyjścia może pogorszyć harmoniczne i rozruch.

W modelu nominalnym U1 ustawia 1,265 × (1 + 110/5,62) ≈ **26,02 V**. R9 = 0,11 Ω daje limit ok. **318 mA** z nominalnego progu 35 mV. D7 prostuje po stronie powrotu. Q1 ze stabilizacją ZD1 obniża zasilanie VO do około 17 V, ponieważ absolutne maksimum pinu to 27 V. ZD2/D9 wstrzykują prąd do BPS przy awarii regulacji. Oddzielny TPS26600PWPR odcina zasilanie wkładu przy ok. **28,8 V** z tolerancją progów i rezystorów. Nominalny próg wyłącznika nadprądowego to ok. **0,369 A**. Przy otwartym MODE eFuse sam ponawia próbę po przeciążeniu. Podczas zwarcia należy sprawdzić współdziałanie z niższym limitem flybacka i zachowanie w trakcie powtórzeń. C12 = 47 nF daje rampę około 11 ms. R19 = 10 kΩ i pojemność przy stykach około 0,2 µF dają τ ≈ 2 ms bez uwzględnienia kabli i tolerancji. Zweryfikować napięcie po otwarciu oraz szczyt w stanach zakłóconych. [LYTSwitch-6](https://www.power.com/sites/default/files/documents/lytswitch-6_family_datasheet.pdf?language=en) · [TPS2660x](https://www.ti.com/lit/ds/symlink/tps2660.pdf)

Bezpiecznik F1 z rysunku ma znamionową zdolność wyłączania 50 A i nadaje się do oceny na stanowisku z ograniczeniem prądu zwarciowego. Wariant do instalacji domowej wymaga sprawdzenia spodziewanego prądu zwarciowego, dopasowania wyłączalności, impedancji przed gałęzią MOV i koordynacji I²t. R1 pozostaje pozycją RFQ. Przykładowa seria Vishay AC01-CS jest większa od aktualnego obrysu R1 i wymaga aktualizacji rozmieszczenia przed zastosowaniem. [F1](https://www.digikey.com/en/products/detail/littelfuse-inc/36911000000/1986930) · [Vishay AC01-CS](https://www.vishay.com/docs/28909/acxxcs.pdf)

**Karta RFQ T1.** EE16/EE1621, docelowe Ae ≥33,8 mm². Początkowo Lp = 1,2 mH ±8%, uzwojenia 84:23:13 z pierwotnym 42 + 42 z wewnętrznym połączeniem. To przeliczenie dla 26 V, bez dodatkowego dławika PFC. Uzwojenie wtórne TIW odpowiednie do zatwierdzonego systemu izolacji, marginesy i taśmy wg systemu dostawcy. Uzwojenie pierwotne i pomocnicze kończą się wyłącznie na stronie pierwotnej. Wzór obrysu PCB przewiduje rzędy 13 mm, współrzędne y −4,8/−1,6/+1,6/+4,8 mm, sześć pinów i brak metalowych końcówek 7/8. Pin 2 to początek pierwotnego, pin 1 koniec. Pin 4 to początek pomocniczego, pin 3 koniec. Pin 6 to początek wtórnego, pin 5 koniec. Kropki 2/4/6 są w fazie. Rysunek karkasu, wymagania wyprowadzeń TIW, zapas do rdzenia i potwierdzenie zgodności mechanicznej są warunkiem złożenia zamówienia. [Specyfikacja T1 w DER-617, rozdz. 7](https://www.power.com/sites/default/files/documents/der-617_8point4watt_high-pf_isolated_flyback_led_driver_using_lytswitch-6.pdf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)

Przy 253 V AC, maks. szczyt sinusoidy wynosi 358 V. Napięcie odbite ≈ (84/23) × (26,0 + 0,6) = 97 V. Szczyt drenu bez impulsu rozproszenia to około 455 V, a D7 widzi ok. 124 V przed dzwonieniem. Cele laboratoryjne to VDS <580 V, FWD <135 V i zachowanie zapasu D7 200 V. Dla 7,9 W przenoszonych w idealizowanym DCM przy 40 kHz, Ipk ≈ √(2P/Lpf) = 0,57 A, a Bpk ≈ LpIpk/(NₚAe) = 0,24 T. Przy 30 kHz rośnie do ok. 0,28 T. Przy fizycznym ograniczeniu prądu sterownika i najwyższej temperaturze możliwe są większe wartości. Dostawca musi potwierdzić Bsat, straty, Llk, Isat i zapas przy rzeczywistym przebiegu, a projektant ponownie policzyć szynę i zacisk RCD dla uzgodnionego transformatora. Zmierzyć krzywą L(I), odchyłkę biegunowości, przebicia i odległości przez materiał oraz w powietrzu.

Na PCB występują wyraźne strefy pierwotna i wtórna oraz reguły odległości między ich sieciami. **8,0 mm** to cel reguły projektowej dla miedzi między stronami, a 1,5 mm i 1,1 mm są wewnętrznymi założeniami dla wybranych sieci pierwotnych. Należy niezależnie zweryfikować odstępy przy padach i na powierzchni obudów, przy rdzeniu T1, przewodach, lutowiu i elementach mocujących. Topologia fizyczna wymaga przeglądu pętli D–T1–C2, D7–T1–C6, prowadzenia Kelvin IS/GND oraz rozdziału masy sygnału FB i powrotu dużych impulsów. Zmiany obudowy i ciasne rozmieszczenie po miniaturyzacji wymagają powtórzenia badań. [Zalecenia układowe Power Integrations](https://www.power.com/sites/default/files/documents/lytswitch-6_family_datasheet.pdf?language=en)

## 4. Wkład, styki i korpus

1. **MCPCB.** Rdzeń Al nominalnie 1,6 mm, pojedyncza warstwa Cu 35 µm od strony LED, biała maska, brak otworów i miedzi z tyłu. Zlecić dielektryk o deklarowanym przewodzeniu i wytrzymałości zgodnej z pomiarem, bez odsłoniętych zadziorów na krawędzi. Korpus opiera moduł na płaskiej powierzchni. Wymiar od środka do płaskiej krawędzi klucza to 13,4 mm. Otwory pozostają w uchwycie. Pady Cree mają asymetrię i nominalne okna pasty 80% w obu osiach, zgodnie z rysunkiem producenta.
2. **Styki.** Środki padów J1, J2, J3 względem środka płytki w układzie KiCad x w prawo i y w dół to (−11,70, 0), (−7,25, 0), (−7,25, +10,55) mm. Wszystkie mają 2,4 × 1,6 mm i brak pasty. Sprężynujące styki w stałej izolacyjnej głowicy, skok roboczy dobrany do tolerancji, końcówka około 0,8 mm i siła 0,5–0,9 N na styk jako założenie do prób. Przy 50 mΩ styku wspólnego strata ≈ 3,2 mW. Wymaga pomiaru rezystancji i cykli termicznych.
3. **Montaż.** Wkład z izolacyjnym obrzeżem i dwoma uchwytami do chwytania. Jedna płaska krawędź i niesymetryczny prowadnik uniemożliwiają odwrócenie wkładu. Docisk bagnetem w trzech punktach na obwodzie, niezależny od trzech styków. Krótki obrót jest blokowany przed pełnym dociśnięciem. Tolerancje początkowe do walidacji to 0,15–0,25 mm luzu promieniowego, max 0,2 mm błędu środka pola względem głowicy oraz równoległość powierzchni docisku do radiatora ≤0,10 mm. Nie dopuścić do przyłożenia nacisku na obudowy LED.
4. **Interlock.** Dwa osobne mikroprzełączniki NO z osobnymi krzywkami. S1 zamyka pętlę SHDN przez termostat NC dopiero przy końcu ruchu klosza. S2 fizycznie otwiera tor dodatni do styku. Klosz w ruchu otwierającym wyłącza najpierw S1, potem S2, a osłona styków znika na końcu. Przy zamykaniu kolejność odwrotna. Styki dociskają się przed włączeniem S1. S1 powinien mieć rating sygnałowy przy małym prądzie i pozłacane styki. S2 powinien mieć znamionowe ≥30 V DC przy prądzie i udarze zweryfikowanym w układzie. Czujniki nie pełnią funkcji izolacji od sieci.
5. **Przegroda i dotyk.** Osłona pierwotnej strony zamocowana niezależnie od klosza. Głowica ze sprężynami zagłębionymi i osłoniętymi przesłoną uruchamianą kluczem. Ścieżka palca lub narzędzia od wkładu do części pierwotnej powinna być przerwana w normalnej pracy i przy pojedynczym błędzie mechanicznym. Część metalowa gorąca pozostaje za osłoną, a uchwyty wkładu są z izolacyjnego tworzywa. Zweryfikować temperaturę uchwytu i ryzyko dotknięcia odsłoniętej MCPCB przy wymianie na gorąco. Jeżeli wynik nie pozwoli na wymianę w tej temperaturze, przewidzieć zwłokę mechaniczną blokady lub trwałą osłonę obrzeża i spodu wkładu.
6. **JLCPCB.** Jednostronna aluminiowa PCB jest oferowana, a producent podaje HASL dla aluminium. HASL jest odpowiedni do prób niskiej liczby cykli po weryfikacji wysokości i równości. Do sprzedaży uzyskać powtarzalne powierzchnie kontaktowe od zakładu oferującego selektywne twarde złoto na IMS lub przenieść powierzchnie ścierne na oddzielny element z kwalifikowaną powłoką. Dopytać JLC o panelizację okręgu, białą maskę i montaż jednego czoła na MCPCB. LED z taśm można zamówić zewnętrznie i przekazać w usłudze consignment po zatwierdzeniu. Transformator, wiązki, radiator i cały mechanizm wymagają osobnego montażu albo kwalifikacji u montażysty. [JLCPCB MCPCB](https://jlcpcb.com/pcb-fabrication/metal-core-pcb) · [Możliwości PCBA](https://jlcpcb.com/capabilities/pcb-assembly-capabilities) · [Warunki consignment](https://jlcpcb.com/help/article/consignment-part-terms-conditions)

## 5. Bilans cieplny i trwałość

Przy 127 mA i gorącym Vf ≈2,80 V moc LED wynosi **5,69 W**. Na szynie 26,0 V potrzeba 6,61 W plus odbiorniki pomocnicze, a przy założonej sprawności flyback 80–85% wejście to około **7,8–8,4 W**. Typowe straty w dwóch źródłach prądu to 2 × 0,127 × (26 − 8 × 2,8) ≈ 0,91 W. Przy Vf=2,65 V to ok. 0,61 W na kanał. Zmierzyć temperaturę obudów AL5812 w tym przypadku oraz przy zwarciu pojedynczej LED i całego szeregu. Kondensatory i flyback są po stronie przegrody, której temperatura i wentylacja różnią się od temperatury radiatora. Zewnętrzna osłona ma utrudnić dostęp do gorącego metalu przy zachowaniu przepływu powietrza.

Przyjmuję ok. 900 lm przed kloszem i 300 lm/W promieniowania białego światła jako model. Oznacza to ok. 3 W mocy optycznej i **2,7 W ciepła w module**. Po uwzględnieniu absorpcji klosza i strat zasilania około **5,0–5,7 W** ciepła pozostaje w lampie. W uproszczonym, konserwatywnym węźle wspólnym RθSA = 7 K/W i Ta = 40°C dają T radiatora ≈ 75–80°C. Dodając 1,2 K/W × 2,7 W dla ścieżki wspólnej od MCPCB do radiatora oraz około 4–8°C na lokalną ścieżkę złącza i dielektryka, przewidywane Tj to około **82–91°C**. W oprawie o RθSA = 11 K/W górny scenariusz daje około 114°C przy Ta 40°C. W takim zastosowaniu musi zadziałać ograniczenie termiczne lub trzeba zawęzić dopuszczone warunki pracy po badaniu. Model rozdziela wynik typowy od bezpieczeństwa.

Punkt wyjścia radiatora to odlew lub tłoczone aluminium z powierzchnią odbioru Ø32–34 mm, zewnętrzna średnica 48–54 mm, wysokość strefy żeber ok. 30 mm, orientacyjnie 24 żebra o głębokości do 8 mm oraz odsłonięta powierzchnia między nimi. Przy efektywnych 0,015–0,017 m² i heff ≈9 W/(m²K) daje 6,5–7,4 K/W przed korektą na shroud, ustawienie i sprawność żeber. Płaszczyznę styku wykończyć, a w uchwycie zastosować fabrycznie zamocowany, suchy, miękki pad 0,20–0,30 mm o k ≥3 W/(mK), np. kwalifikowany silikon z warstwą wzmacniającą. Dla 500 mm², 0,25 mm i k=3 samo tworzywo ma Rθ ≈0,17 K/W. Do limitu 1,2 K/W dla całości trzeba doliczyć granice kontaktu i rozpraszanie. Ustalić docisk do krzywej producenta padu, z ogranicznikiem mechanicznym i bez pasty nakładanej przez użytkownika.

Cel Tj ≤95°C w warunkach znamionowych oraz temperatura obudowy elektrolitów ≤85°C przy 40°C otoczenia. Wstępny termostat NC na radiatorze dobrać w przedziale ok. 85–90°C po pomiarze temperatury uchwytu i marginesów. Założenie temperatury termostatu nie oznacza dopuszczalnej temperatury dotyku. Dla kondensatora 105°C, 5 000 h przy 105°C, uproszczone 2× na każde 10°C daje 20 000 h przy 85°C i 40 000 h przy 75°C. Użyć danych faktycznej serii, prądu tętnień i temperatury rdzenia kondensatora. Trwałość LED oprzeć na danych producenta LM-80, odtworzonych warunkach w oprawie i badaniu utrzymania strumienia.

## 6. UE i bezpieczeństwo elektryczne

**Klasyfikacja robocza.** Wkład jest wymiennym przez użytkownika modułem LED bez zintegrowanego sterownika. Całość jest zasilanym z sieci urządzeniem o interfejsie E27. Definicja klasycznej lampy samostatecznikowej użyta w IEC 62560 zakłada jednostkę nierozbieralną bez trwałego uszkodzenia, dlatego możliwość wyjęcia wkładu wymaga formalnej oceny zakresu. Przyjąć do oceny IEC/EN 62560 dla styku E27, kompatybilności i zagrożeń lampy. Rozważyć IEC/EN 60598-1 i odpowiednie wymagania wyrobu z wymiennym modułem po uzgodnieniu klasyfikacji z laboratorium. IEC 62031:2026 jest aktualnym wydaniem IEC dla modułów, a decyzja LVD wymienia EN IEC 62031:2020 z A11:2021. IEC 61347-1 i IEC 61347-2-13:2024 to punkt odniesienia dla oddzielnej oceny zasilacza LED, z rozróżnieniem edycji IEC i edycji EN przywołanej w wykazie. Sprawdzić aktualny wykaz zharmonizowany i daty wycofania przed deklaracją. [IEC 62560](https://webstore.iec.ch/en/publication/22155) · [IEC 62031:2026](https://webstore.iec.ch/en/publication/92035) · [IEC 60598-1](https://webstore.iec.ch/en/publication/66620) · [IEC 61347-2-13](https://webstore.iec.ch/en/publication/64713) · [Wykaz LVD UE](https://eur-lex.europa.eu/eli/dec_impl/2023/2723/oj/eng)

**Ekoprojekt i etykieta.** Dla (UE) 2019/2020 i 2019/2015 rozważyć klasyfikację korpusu jako produktu zawierającego źródło, jeżeli moduł i osprzęt można oddzielnie zweryfikować zgodnie z procedurą. Zasilacz pozostaje stały dla konsumenta, a dostęp do niego dla serwisu lub weryfikacji powinien być możliwy przy użyciu narzędzi. Udokumentować wyjęcie bez trwałego uszkodzenia elementów podlegających weryfikacji i określić, kto je wymienia. Jeśli wyrób nie spełni warunku rozdzielnej weryfikacji, sklasyfikować i badać całość jako źródło. Przyporządkować każdej wprowadzanej wersji model i obowiązki EPREL oraz etykiety, po ustaleniu granic wyrobu. Dla kwalifikowanego sieciowego źródła LED przy 5–10 W obowiązuje DF ≥0,5, a pełne wymagania obejmują m.in. CRI ≥80, PstLM ≤1,0, SVM ≤0,4, spójność barwy, utrzymanie strumienia i przeżywalność. Klasę energetyczną określić z pomiarów i współczynników kategorii. [Ekoprojekt 2019/2020](https://eur-lex.europa.eu/eli/reg/2019/2020) · [Etykiety 2019/2015](https://eur-lex.europa.eu/eli/reg/2019/2015) · [Zmiana 2021/341](https://eur-lex.europa.eu/eli/reg/2021/341/oj/eng)

**Plan oceny CE.** Dyrektywa LVD 2014/35/UE dla wyrobu sieciowego, EMC 2014/30/UE, RoHS 2011/65/UE i obowiązki ekoprojektu. Zweryfikować EMC z EN IEC 55015, EN IEC 61547, EN IEC 61000-3-2 i EN 61000-3-3 według aktualnych powołań. Ocenić zagrożenie fotobiologiczne wg EN/IEC 62471 i odpowiedniego podejścia z IEC 62471-7 dla źródeł widzialnych, z kloszem i w przewidywalnych stanach otwarcia. IEC 62493 rozważyć dla oceny pól elektromagnetycznych. Geometria E27 wg właściwych arkuszy IEC/EN 60061. Dokumentacja techniczna, instrukcja po polsku, ocena ryzyka, deklaracja zgodności, oznaczenia i identyfikowalność partii oraz obowiązki WEEE. [Dyrektywa LVD](https://eur-lex.europa.eu/eli/dir/2014/35/oj/eng) · [Dyrektywa EMC](https://eur-lex.europa.eu/eli/dir/2014/30/oj/eng) · [RoHS](https://eur-lex.europa.eu/eli/dir/2011/65/oj/eng) · [IEC 62471](https://webstore.iec.ch/en/publication/7076)

**Warunki projektu.** Wzmocniona bariera P/S i do każdej dostępnej części, także rdzenia Al oraz mocowania. Początkowe założenia do wyliczenia odstępów to kategoria przepięciowa II, stopień zanieczyszczenia 2 w chronionej komorze, wysokość ≤2 000 m oraz CTI FR-4 według dokumentu laminatu. Pomiarowe minimum 8 mm jest celem układu PCB. Wymagania normatywne wyliczyć z rzeczywistego napięcia roboczego, impulsowego, materiału, powłok i środowiska, z uwzględnieniem tolerancji. Docelowy limit projektowy napięcia styków w pojedynczej awarii to **≤30 V DC z uwzględnieniem tętnień i szczytów** oraz **<5 V w 100 ms od otwarcia w normalnym stanie**. Każdy limit musi przejść pomiar w gotowym zespole. Hipot np. 4 kV AC jako cel inżynierski do uzgodnienia, dokładną wartość, czas i wstępne kondycjonowanie ustala się po klasyfikacji i dobraniu systemu izolacji. Przegroda i obudowa z kwalifikowanym tworzywem z dokumentacją cieplną, palności i odkształcenia, plus odciążenie wszystkich przewodów.

| Stan lub usterka | Reakcja przewidziana w Rev A | Próba |
|---|---|---|
| Otwarcie pod zasilaniem, drganie styków | S1 rozłącza SHDN, S2 rozłącza anodę, R19 rozładowuje pojemność. | Pomiar wszystkich par styków i względem radiatora, szybkie i wolne otwieranie, zużyte prowadnice, łuk i błysk. |
| Sklejony S1 albo S2 | Drugi tor i pasywna osłona pozostają czynne. | Osobno zewrzeć każdy przełącznik, zablokować przesłonę i sprawdzić sondą w kontrolowanych kombinacjach. |
| Zanik sprzężenia flyback | U1 ma własne funkcje OVP/auto-restart i zewnętrzną gałąź BPS. U2 odcina przy OV niezależnie od FB. | Przerwy i zwarcia w dzielniku, zwarcie ZD2/D9, oszacowanie przepięcia i energii. |
| Zwarty eFuse | Działa mechaniczny S2. Regulację nadal prowadzi U1. | Wymusić zwarcie tranzystorów wejście–wyjście i zmierzyć napięcie otwartego wkładu. |
| Zwarty regulator kanału lub zwarty łańcuch LED | Limit U1, eFuse, termika kanału i termostat. | Zmierzyć prąd drugiego kanału, maksymalne temperatury, czas wyłączenia, zachowanie po ostygnięciu. |
| Brak wkładu lub przerwany jeden szereg | Sterownik pozostaje w CV. Drugi szereg nie przejmuje prądu przerwanego. | Pomiar bez obciążenia i przebiegów ponownego podłączania przy jednym/dwóch szeregach. |
| Wada T1, CY1, wilgoć lub upadek | Ochrona zależy od udokumentowanego systemu izolacji i obudowy. | Badania elektryczne, mechaniczne, wilgotność, prąd dotykowy, temperatura i palność po kondycjonowaniu. |

## 7. Prototyp i zwolnienie do produkcji

1. **Wkład na stanowisku niskonapięciowym.** Oba szeregi zasilić niezależnymi źródłami CC. Wykonać pomiary 120, 127, 130 i 135 mA z kloszem i bez klosza. Zmierzyć Vf na zimno i w stanie ustalonym, CCT/CRI oraz strumień w kuli. Cel 750–850 lm przy CRI ≥80 dla wszystkich trzech CCT. Powtórzyć po zakładanej liczbie przełączeń.
2. **Osobne uruchomienie wtórnej strony.** Zasilić szynę VRAW z ograniczeniem prądowym i kontrolą napięcia bez obecności sieci. Zbadać 24–27 V, dropout, zwarcie, przerwę, miękki start, OV, blokady i rezystancje styków. Ustalić impulsy w stanach pośrednich, opóźnienia mechaniczne i poprawność polaryzacji.
3. **Zasilacz sieciowy dopiero po przeglądzie.** Przegląd schematu i PCB przez projektanta zasilaczy sieciowych, zatwierdzony T1, rzeczywiste footprinty i uzgodnione badania izolacji. W kontrolowanej osłonie, z ograniczeniem energii, izolowanym stanowiskiem i odpowiednimi sondami zmierzyć VDS, Ipk, napięcie zbiornika, FWD, IS i temperatury. Najpierw użyć obciążenia zastępczego. Charakterystyki mierzyć przy 207/230/253 V, bez obciążenia, pełnym obciążeniu, zwarciu, włączeniu i zapadzie. Pomiary oscyloskopem z sondą różnicową odpowiedniej kategorii są konieczne po stronie pierwotnej.
4. **Termika i mechanika.** Badania w pionie w obu kierunkach i poziomo, przy 25/40°C i w najgorszej przewidzianej oprawie. Termopary na punkcie lutowniczym LED, obu regulatorach, T1, U1, kondensatorach, rdzeniu MCPCB, uchwytach i radiatorze. Co najmniej 200 cykli wymiany jako próba rozwojowa, potem ponowny pomiar rezystancji styku, docisku, ΔT, pyłu i uszkodzenia TIM.
5. **Przedseria.** Emisja przewodzona i promieniowana, ESD przy kloszu i stykach, EFT, surge, zapady, harmoniczne/DF, PstLM i SVM. Próby izolacji i prądu dotykowego, dostępności palcem probierczym, odporności na błędny montaż, nieprawidłową pracę, uszkodzenia pojedyncze, rozgrzanie i fotobiologia. Rozpocząć od małej partii z uzgodnionymi badaniami końcowymi izolacji i funkcji. Pliki produkcyjne w pakiecie mają status do przeglądu. 

## 8. Koszt i montaż

Kwoty w CSV są budżetem w USD netto za sztukę, bez oprzyrządowania, badań zgodności, logistyki, VAT i marży. Widełki dla transformatora, części mechanicznych i montażu są szacunkiem do RFQ. Rzeczywiste ceny z ofert dystrybutorów są wyszczególnione oddzielnie w BOM i dotyczą podanego progu liczby części. Przy 100 kompletnych lampach potrzeba 1600 LED na daną barwę tylko przy serii jednobarwnej. Podział na barwy i wymagane biny mogą podnieść cenę jednostkową. Projekt ma 2× AL5812 i układ eFuse o istotnym udziale kosztowym. Dalsze obniżanie kosztu wymaga zachowania niezależnego limitu napięcia i przeanalizowania skutków zamiany ochrony.

| Wielkość serii | Kompletna lampa [USD/szt.] | Pojedynczy wkład [USD/szt.] |
|---:|---:|---:|
| 100 | 27,71–59,33 | 3,61–9,03 |
| 1 000 | 14,79–29,64 | 2,00–3,99 |
| 10 000 | 9,72–19,59 | 1,32–2,74 |

## 9. Pliki i metodologia KiCad

Artykuł JLCPCB opisuje połączenie przez MCP z KiCad 10, ocenę serwera i nadawanie mu dostępu tylko do obszaru projektu. Zwraca szczególną uwagę na tworzenie schematu z wcześniej spisanych połączeń, porównanie listy sieci pin po pinie, odrębną kontrolę ERC/DRC, prowadzenie węzłów pomiarowych z dala od przełączania i sprawdzenie numerów części bezpośrednio w katalogu. W tej pracy zastosowano zainstalowany KiCad 10.0.8, jego bibliotekę PCB i polecenia sprawdzania oraz eksportu. Schemat i PCB są edytowalne, a symbole i niestandardowe footprinty lokalne dla każdego projektu. [Artykuł JLCPCB o KiCad MCP](https://jlcpcb.com/blog/kicad-mcp-how-to-design-a-pcb-with-claude-code)

KiCad pokazuje standardowy stos z dwiema warstwami miedzi także w pliku LED. Projekt wkładu wykorzystuje wyłącznie F.Cu, bez przelotek i otworów. Dla MCPCB przekazać tylko przednią miedź, przednią maskę/pastę/opis i kontur oraz osobno specyfikację stosu IMS. Pliki pozycji z KiCad wymagają mapowania orientacji elementów i podglądu PCBA. W szczególności sprawdzić oba zwroty Cree oraz stronę B i orientację U1. Raporty ERC/DRC zawierają kontrolę zgodności schematu z PCB. Odczyt miedzi z obu warstw potwierdził pas 8,2 mm między stronami P i S. Rendering przedstawia ogólny układ, z przybliżonymi bryłami niestandardowych części i bez bryły L1. Przed zwolnieniem do produkcji trzeba sprawdzić wymiary, pinouty i polaryzacje także z dokumentacją dostawców, z naciskiem na T1, U1, CY1, F1 i elementy bezpieczeństwa.
