kamelele/Velluneo-2.0/hardware/E27/outputs/Zasilacz_RevG_Moc/Weryfikacja_RevG.md

# Kontrola płytki mocy Rev G

- KiCad wykazał 0 naruszeń ERC i DRC, 0 brakujących połączeń oraz 0 rozbieżności PCB ze schematem. Niezależny odczyt porównał 101 przypisań pin–sieć.
- Względem Rev F usunięto 17 segmentów, dodano 8. Zmiany tras obejmują wyłącznie tylną stronę przy RCD. Prowadzenie strony wtórnej i J101 są identyczne z Rev F.
- PCB ma 55,5 × 34 mm i dwie warstwy. Pas w osi X między skrajną miedzią pierwotną i wtórną wraz z wypełnieniami wynosi 8.200 mm. Wypełnienia P_0 mają 84.6 mm² na F.Cu i 50.2 mm² na B.Cu.
- Tę rewizję zweryfikowano cyfrowo. Kryteria pomiarowe określa [analiza RCD](Analiza_RCD.md).
