kamelele/Velluneo-2.0/hardware/E27/outputs/Zasilacz_RevF_Moc/Weryfikacja_RevF.md

# Kontrola płytki mocy Rev F

- ERC, DRC i porównanie ze schematem przeszły bez naruszeń. Odczyt porównał 99 przypisań pin–sieć ze schematem.
- Zachowano wszystkie 452 segmenty i przelotki sieci pierwotnych Rev D oraz pozycje, wielkości i sieci odziedziczonych padów. Nowe wyprowadzenie J101 ma S_RAW na 1 i S_RTN na 2.
- Laminat 55,5 × 34 mm, dwie warstwy. Najwęższy pas w osi X między skrajną miedzią pierwotną i wtórną, razem z wypełnieniami, wynosi 8.200 mm. Wypełnienia P_0 odprowadzające ciepło mają 84.6 mm² na F.Cu i 41.6 mm² na B.Cu.
- Wartości wynikają z geometrii PCB. Izolacja transformatora i gotowego zespołu oraz temperatura wymagają pomiarów.
