kamelele/Velluneo-2.0/hardware/E27/outputs/Studium_RevC/RFQ_T1_EFD20.md

# T1 EFD20 · specyfikacja do wykonania próbek

**Zastosowanie.** Flyback 207–253 VAC, szyna wyjściowa ok. 26 V, 254 mA nominalnie, 6,60 W przed stopniem prądowym LED. Sterownik LYT6073C z 470 nF na BPP. Zachować odseparowanie obwodu wkładu od sieci. Rezerwa mechaniczna transformatora wynosi **24,3 × 22 × 10,5 mm**, z odrębnym miejscem na wyprowadzenia od spodu PCB.

## Dane magnetyczne do zweryfikowania z dostawcą

- Rdzeń **TDK EFD20/10/7 N87**, połówka ze szczeliną **B66417U0100K187** i połówka bez szczeliny **B66417G0000X187**, karkas kandydacki **B66418W1008D001**. Wartość Aₗ pary 100 nH ±10%, katalogowa szczelina ok. 0,49 mm i Aₑ = Aₘᵢₙ = 31 mm². Dostawca ma potwierdzić obrys karkasu, dobór mocowania rdzenia oraz brak dostępnych przewodzących części w pasie izolacji. [TDK EFD20](https://www.tdk-electronics.tdk.com/inf/80/db/fer/efd_20_10_7.pdf)
- Początkowa przekładnia **110:30:17** (pierwotne:wtórne:pomocnicze). Rozważyć dzielone pierwotne 55+55 oraz wtórne TIW. Ostateczne średnice, warstwy, przejścia, marginesy i położenie początku uzwojeń ustala dostawca na podstawie wymagań izolacyjnych. Przed zamówieniem potwierdzić ułożenie TIW i pojemność między uzwojeniami. Na PCB potrzebne są cztery zaciski po stronie pierwotnej i dwa po wtórnej. Wymagany jest uzgodniony rysunek z numerami, fazą i informacją o usunięciu nieużytych metalowych pinów.
- Docelowe Lp **1,21 mH ±10%** z 110 zwojów. Przekładnia daje ok. 97 V napięcia odbitego przy 26 V i 0,55 V na diodzie. Przy 253 VAC idealny poziom drenu wynosi ok. **455 V przed przepięciem**. Aux wynosi ok. 14,4 V w uproszczonym modelu. Sprawdzić tę wartość od rozruchu do odłączenia wkładu.
- Przy górnym Lp i prądzie 0,589 A obliczone B = Lp × Ipk / (Np × Aₑ) wynosi **0,230 T**. Przypadek 0,650 A daje **0,254 T**. 0,589 A to katalogowy maksymalny standardowy limit przy nachyleniu 163 mA/µs i 25°C. 0,650 A jest przypadkiem porównawczym dla szybszego narastania, z zapasem do weryfikacji oscyloskopowej. W tym samym porównaniu rdzeń EP13 przy Aₑ = 19,5 mm² daje 0,403 T dla 110 zwojów, a EFD15 przy Aₘᵢₙ = 12,2 mm² daje 0,645 T. Mniejsze rdzenie wymagałyby osobnego projektu uzwojenia i innego punktu pracy. [Parametry prądowe LYTSwitch-6](https://www.power.com/sites/default/files/documents/lytswitch-6_family_datasheet.pdf?language=en) · [EP13 TDK](https://www.tdk-electronics.tdk.com/inf/80/db/fer/ep_13.pdf) · [EFD15 Ferroxcube](https://www.ferroxcube.com/en-global/download/download/11)
- Model DCM z Lp = 1,21 mH i sprawnością 84% daje ok. 0,510 A przy 50 kHz i 0,431 A przy 70 kHz dla 6,604 W. Przy dolnym Lp i dolnym katalogowym limicie 0,511 A w tym uproszczeniu potrzeba co najmniej 55 kHz. Sterownik zmienia limit wraz z częstotliwością i obciążeniem. Moc, pracę przy dolnej sieci i nasycenie w krótkich stanach rozruchu trzeba zmierzyć w układzie.

## Dane i pomiary wymagane dla próbek

1. Rysunek z tolerancjami, położeniem wszystkich końcówek, sposobem mocowania rdzenia, maksymalną wysokością i kartą użytego systemu izolacji. Podawać izolację między uzwojeniami oraz względem rdzenia i obejmy. Kryteria badań izolacji ustalić z laboratorium dla klasyfikacji kompletnej lampy.
2. Pomiary Lp, przekładni, fazy, rezystancji uzwojeń, pojemności między stronami oraz indukcyjności rozproszenia z podanym sposobem zwierania. Cel rozwojowy dla rozproszenia to ≤18 µH przy zwarciu wtórnego i otwartym pomocniczym. Dla 18 µH, 0,65 A i 70 kHz energia rozproszenia odpowiada ok. 0,27 W przed uwzględnieniem tego, gdzie jest tracona.
3. Przebieg Lp w funkcji prądu i temperatury do co najmniej 0,65 A przy 100°C albo do wcześniej wykrytego nasycenia. Podać pomiar indukcyjności przy małym sygnale i metodę pomiaru impulsowego.
4. Raport pomiarów trzech próbek, zwrotna ocena wykonalności i oddzielne ceny dla 100, 1000 i 10 000 szt. Nie rozpoczynać serii na podstawie tej specyfikacji rozwojowej.
