kamelele/Velluneo-2.0/hardware/E27/outputs/Zasilacz_RevG_Moc/RFQ_T1_EE16.md

# T1 EE16 · dane do wyceny próbek Rev G

Transformator do izolowanego flyback 207–253 VAC, nominalnie 26 V / 254 mA. Wersja próbkowa zachowuje układ wyprowadzeń z rysunku PCB. Dostawca potwierdza wykonanie i odsyła dane z pomiarów przed dopuszczeniem do serii.

- **Punkt wyjścia** · EE16/EE1621, Ae ≥33,8 mm², Lp = 1,20 mH ±8%, uzwojenia 84:23:13. Początki uzwojeń na pinach 2, 6 i 4. Potwierdzić przekrój minimalny rdzenia, materiał i szczelinę. [Parametry bazowe i biegunowość](../Raport_E27_RevA.md#3-schemat-zasilacza-i-zadanie-dla-dostawcy-transformatora) · [Rysunek padów](E27.pretty/EE16_6pins_RFQ.kicad_mod)
- **Rozproszenie** · cel maks. **10 µH** mierzone po stronie pierwotnej, wtórne zwarte, pomocnicze otwarte. Zaproponowany punkt porównawczy to 100 kHz, 100 mVrms i 23°C po kompensacji przewodów. Jeżeli producent używa innego ustawienia, podać oba wyniki i opis połączeń. Oczekiwany raport z min. 3 sztuk, każda z odczytem Lp, Llk, rezystancji uzwojeń i pojemności między stronami. [Model Rev G](Analiza_RCD.md)
- **Nasycenie i straty** · przekazać krzywą L(I) do 0,65 A przy 25°C i 100°C lub do wcześniej wykrytego nasycenia. 0,65 A to punkt prób porównawczy. Ocenić straty oraz wykonalność przy wymaganym rozproszeniu i izolacji. Uzgodnić przekładnię przed zmianą liczby zwojów.
- **Izolacja i gabaryt** · przekazać tolerowany obrys karkasu, sposób zabezpieczenia rdzenia i wyprowadzeń, pozycje pinów, konstrukcję i dokumentację systemu izolacji oraz procedurę kontroli próbek. Parametry badań izolacji ustala laboratorium dla kompletnego zasilacza. Dążyć do niskiego Llk z zachowaniem bariery i kontrolą pojemności między stronami.
- **Niższy rdzeń** · TDK EFD15 z Amin 12,2 mm² dałby około 0,745 T przy 84 zwojach, Lp 1,296 mH i 0,589 A. W tej samej obwiedni cel 0,25 T wymaga co najmniej 251 zwojów pierwotnych oraz ok. 19 nH Aₗ przy nominalnym Lp. To poza zakresem 30–280 nH użytym przez TDK do zależności Aₗ i szczeliny, a karkas THT ma 15,5 mm² okna. Oznacza odrębny projekt magnetyczny. EFD20 pozostaje opcją mniejszej wysokości z wcześniejszego studium. Zmiana karkasu wymaga innego obrysu i ponownego pomiaru rozproszenia. [TDK EFD15](https://www.tdk-electronics.tdk.com/inf/80/db/fer/efd_15_8_5.pdf) · [Studium EFD20](../Studium_RevC/RFQ_T1_EFD20.md)
