kamelele/Velluneo-2.0/hardware/E27/outputs/Studium_RevE/Podglady/RevD_nowe_modele_dol.png

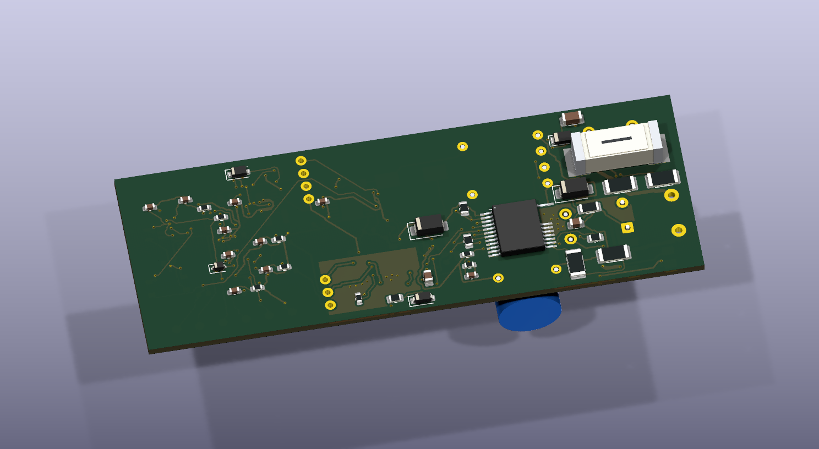
hardware/E27/outputs/Studium_RevE/Podglady/RevD_nowe_modele_dol.png
