kamelele/Velluneo-2.0/hardware/E27/outputs/Studium_RevE/Podglady/RevE_JLC_widok_PCB.png

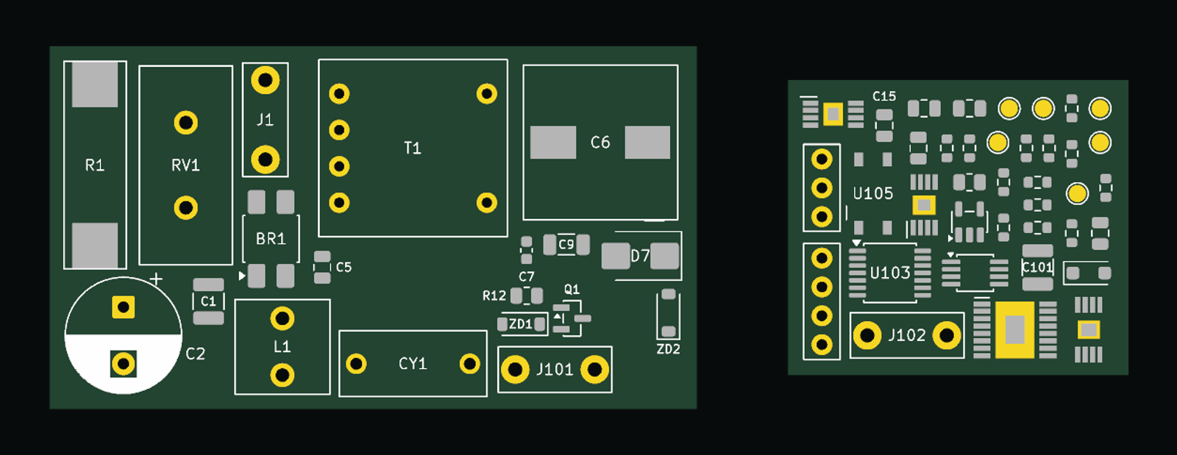
hardware/E27/outputs/Studium_RevE/Podglady/RevE_JLC_widok_PCB.png
