kamelele/Velluneo-2.0/hardware/E27/outputs/Studium_RevE/Podglady/RevE_plytka_mocy.png

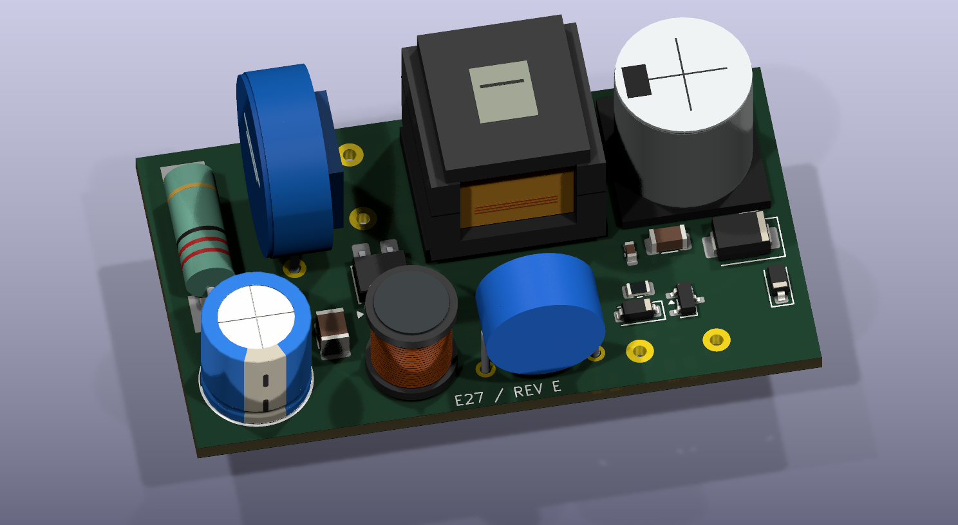
hardware/E27/outputs/Studium_RevE/Podglady/RevE_plytka_mocy.png
