kamelele/Velluneo-2.0/hardware/E27/outputs/Studium_RevJ_ValleyFill/Podglady/RevJ_rozmieszczenie.png

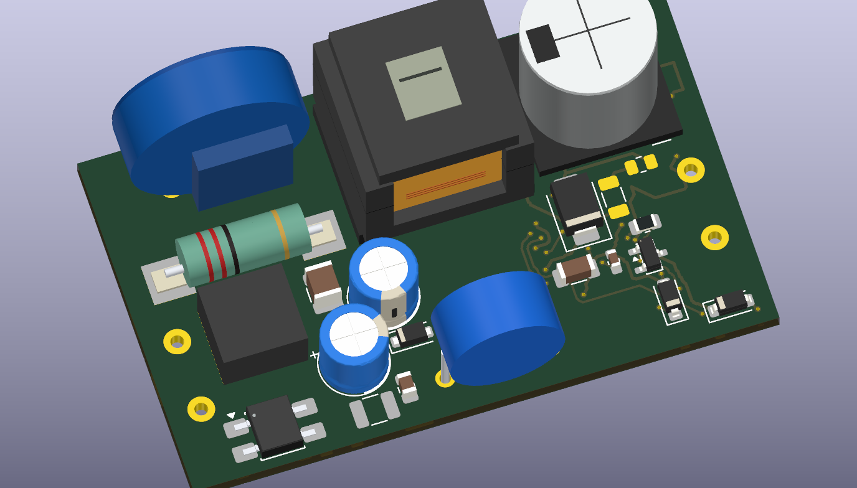
hardware/E27/outputs/Studium_RevJ_ValleyFill/Podglady/RevJ_rozmieszczenie.png
