kamelele/Velluneo-2.0/hardware/E27/outputs/Wklad_LED/Wklad_LED_3D.png

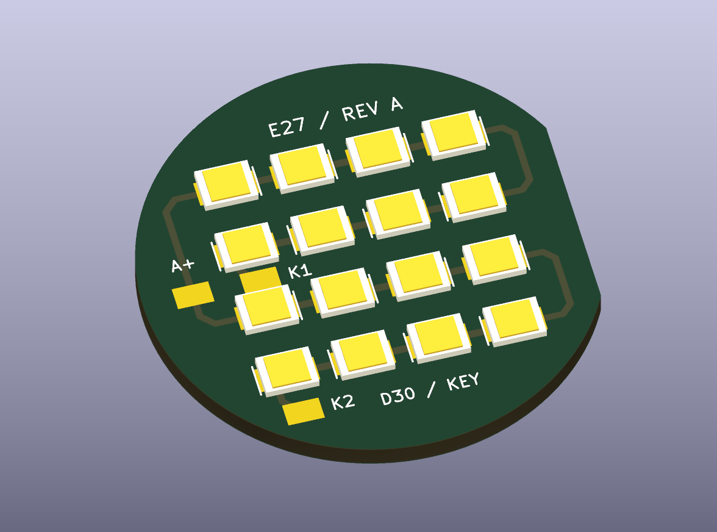
hardware/E27/outputs/Wklad_LED/Wklad_LED_3D.png
