kamelele/Velluneo-2.0/hardware/E27/outputs/Zasilacz_8S_Draft/8S-D3-Kompakt-top.png

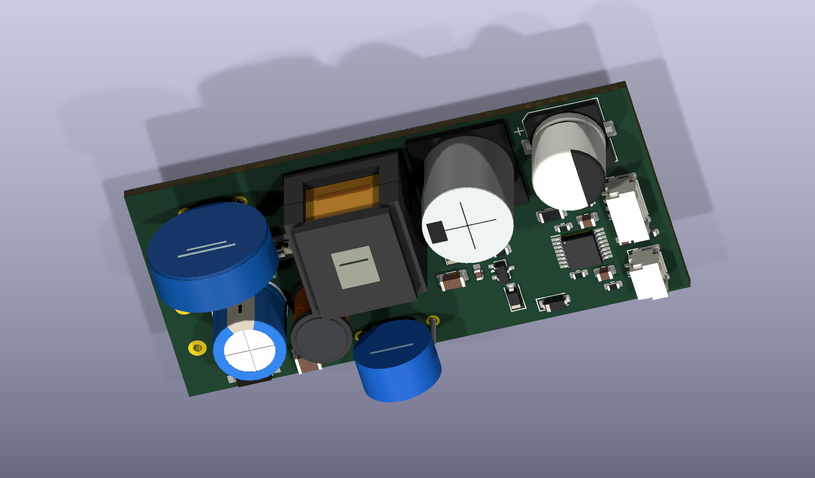
hardware/E27/outputs/Zasilacz_8S_Draft/8S-D3-Kompakt-top.png
