kamelele/Velluneo-2.0/hardware/E27/outputs/Zasilacz_8S_Draft/Sterowanie_8S.png

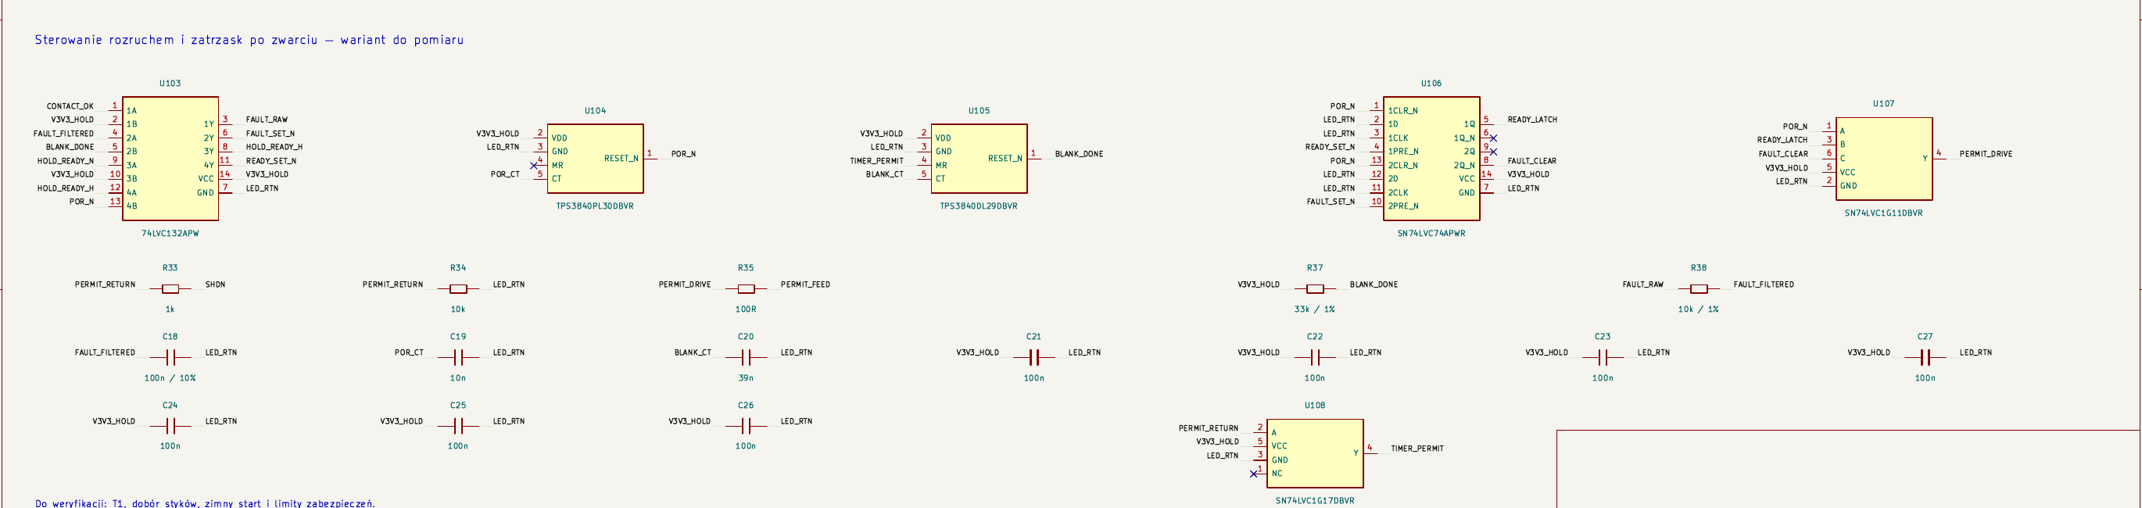
hardware/E27/outputs/Zasilacz_8S_Draft/Sterowanie_8S.png
