kamelele/Velluneo-2.0/hardware/E27/outputs/Zasilacz_RevB1/Podglady/Zasilacz_RevB1_gora_3D.png

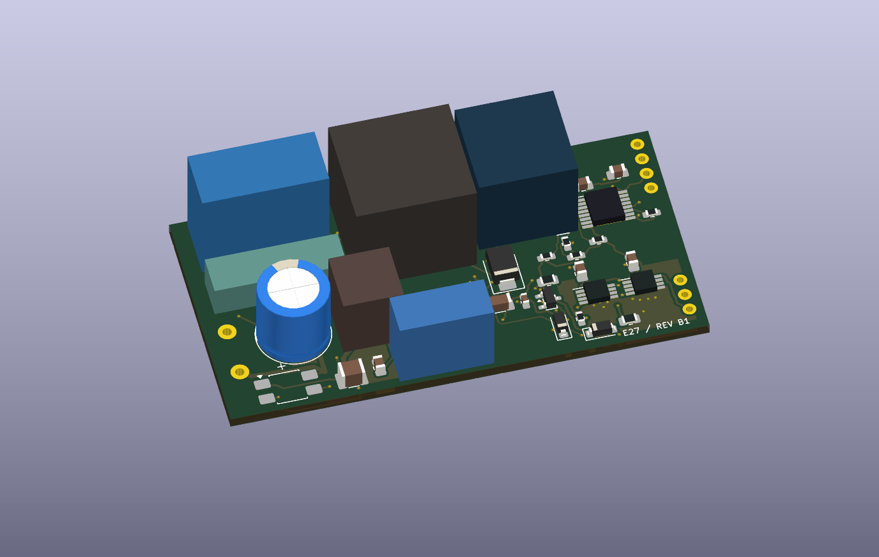
hardware/E27/outputs/Zasilacz_RevB1/Podglady/Zasilacz_RevB1_gora_3D.png
