kamelele/Velluneo-2.0/hardware/E27/outputs/Zasilacz_RevB2_Ochrona/Podglady/RevB2_dol_3D.png

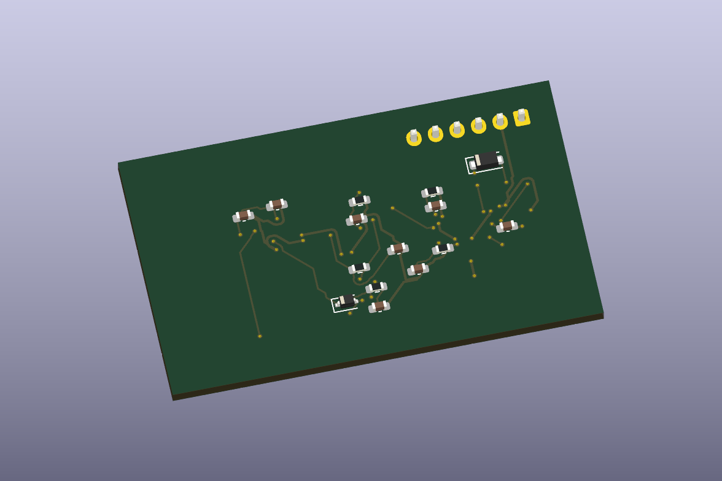
hardware/E27/outputs/Zasilacz_RevB2_Ochrona/Podglady/RevB2_dol_3D.png
