kamelele/Velluneo-2.0/hardware/E27/outputs/Zasilacz_RevH_Moc/Podglady/RevH_3D.png

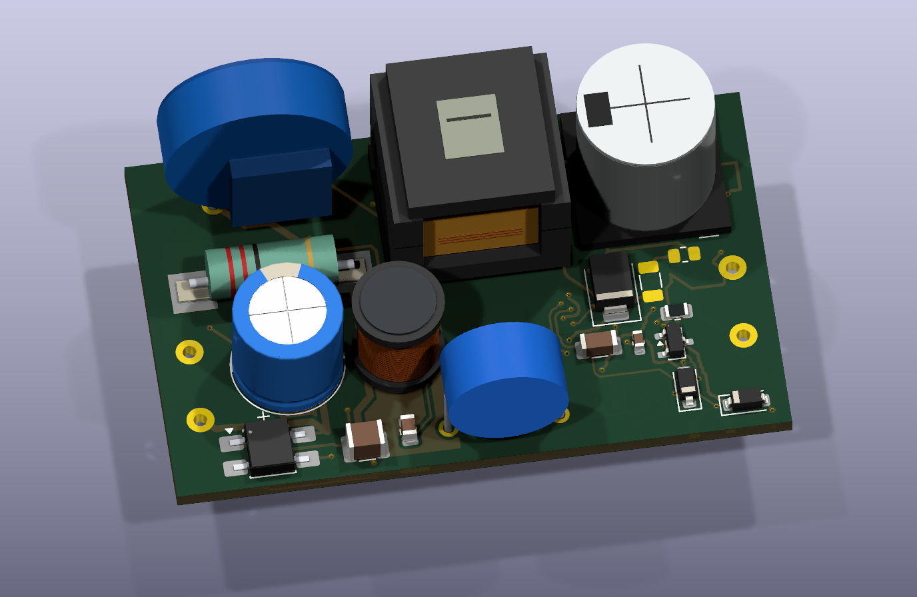
hardware/E27/outputs/Zasilacz_RevH_Moc/Podglady/RevH_3D.png
