kamelele/Velluneo-2.0/hardware/E27/outputs/Zasilacz_RevH_Moc/Podglady/Zasilacz_RevH_RevG_razem.png

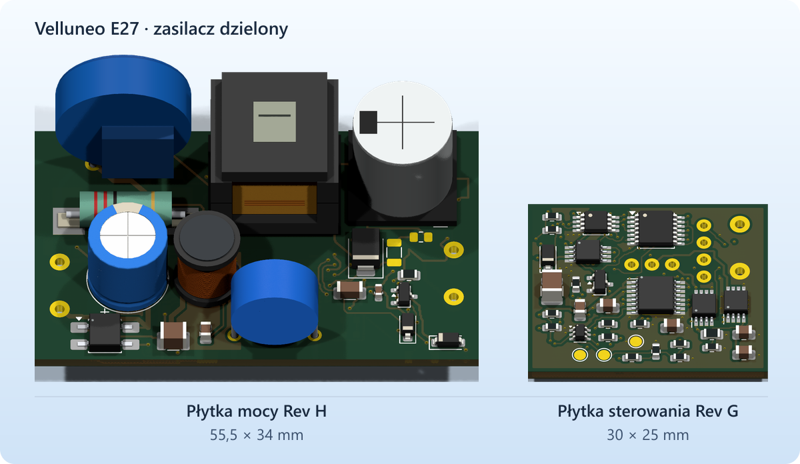
hardware/E27/outputs/Zasilacz_RevH_Moc/Podglady/Zasilacz_RevH_RevG_razem.png
