kamelele/Velluneo-2.0/hardware/E27/outputs/Zasilacz_RevH_Sterowanie/Podglady/RevH_3D.png

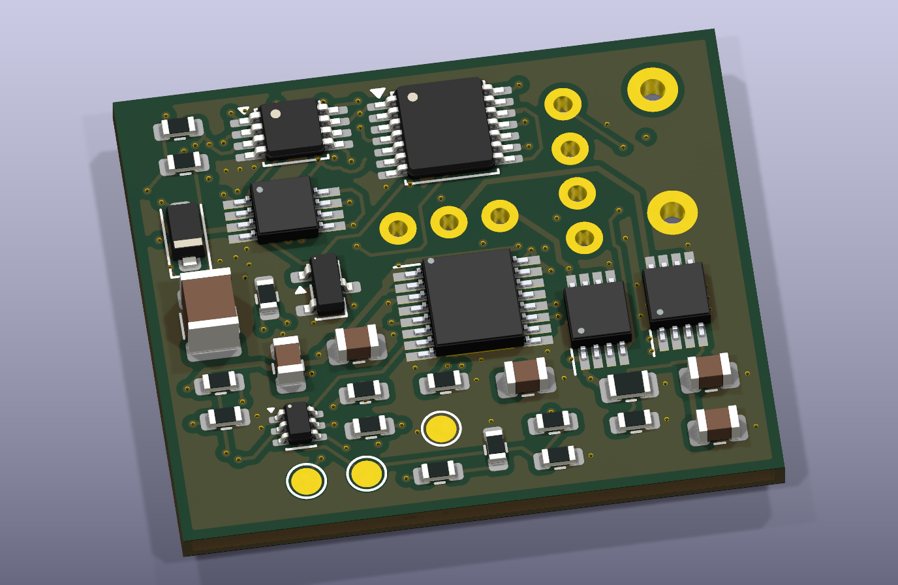
hardware/E27/outputs/Zasilacz_RevH_Sterowanie/Podglady/RevH_3D.png
