kamelele/Velluneo-2.0/hardware/E27/outputs/Zasilacz_RevK_Moc/Podglady/Sciezki_RevH_RevK.png

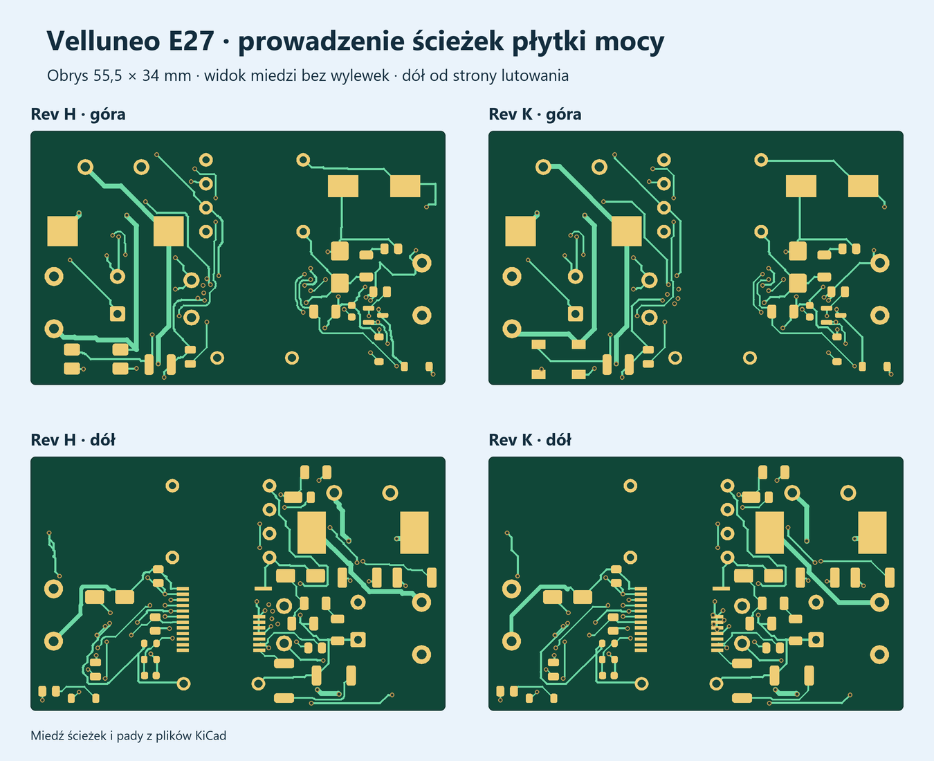
hardware/E27/outputs/Zasilacz_RevK_Moc/Podglady/Sciezki_RevH_RevK.png
