kamelele/Velluneo-2.0/hardware/E27/outputs/Zasilacz_RevK_Moc/Podglady/Zasilacz_RevK_RevH_razem.png

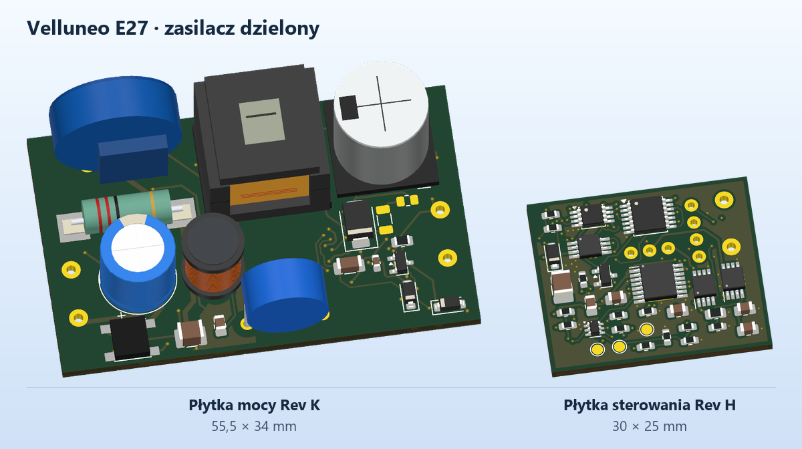
hardware/E27/outputs/Zasilacz_RevK_Moc/Podglady/Zasilacz_RevK_RevH_razem.png
