kamelele/Velluneo-2.0/hardware/E27/outputs/BOM_Zasilacz_RevB.csv

Zespół / wariant | Oznaczenie | Nazwa i funkcja | Parametry | Producent | MPN | Obudowa / footprint | JLCPCB / LCSC | Dystrybutor alternatywny | USD/szt. 1 lub MOQ | Próg mały [części] | USD/szt. większy próg | Próg duży [części] | Ilość na płytce / zespole | Koszt pozycji USD przy progu małym | Koszt pozycji USD przy progu dużym | Dostępność i cykl życia | Zamiennik do weryfikacji | Uwagi montażowe | Źródło
Zasilacz Rev B 66 × 34 mm | J1 | Przewody L i N z E27 | 230 VAC |  |  | E27:Mains_L_N |  | Wycena dostawcy / RFQ |  |  |  |  | 1 |  |  | Do wyboru po zatwierdzeniu wymagań i rysunku. |  | THT / wiązka. Uzgodnić oddzielny montaż. Stałe lutowanie i odciążenie przewodów.
Zasilacz Rev B 66 × 34 mm | F1 | Bezpiecznik zwłoczny | T 500 mA / 277 VAC | Schurter | 3403.0271.23 | E27:Schurter_UMT_H |  | DigiKey 9094779 | 3.33 | 1 | 1.9518 | 100 | 1 | 3.33 | 1.9518 | Aktywny w katalogu. |  | UMT-H. 1,5 kA przy 277 VAC UL albo przy 250 VAC IEC, warunki z karty. Wymaga testu zdolności wyłączania całego zespołu. | https://www.digikey.com/en/products/detail/schurter-inc/3403-0271-23/9094779
Zasilacz Rev B 66 × 34 mm | RV1 | Ogranicznik przepięć z odcięciem termicznym | 275 VAC | Littelfuse | TMOV14RP275E | E27:TMOV14 | Niepotwierdzony | Littelfuse / DigiKey |  |  |  |  | 1 |  |  | MPN producenta, cena i zapas do RFQ. | iTMOV14RP275M z adaptacją footprintu i badaniem | Za R1. Budżet wysokości 22 mm dla prostych wyprowadzeń. Sprawdzić udar, ciągłe przepięcie i rozłączenie termiczne. | https://www.littelfuse.com/assetdocs/tmov-itmov?assetguid=bd475732-1071-4352-b8aa-f78b0007eb05
Zasilacz Rev B 66 × 34 mm | R1 | Ograniczenie prądu udarowego | 22R / 1.1W fusible | Vishay | AC01000902209JBMCS | E27:AC01_CS_WSZ |  | DigiKey 28721869 | 1.47 | 1 | 0.6691 | 100 | 1 | 1.47 | 0.6691 | Potwierdzona pozycja katalogowa. |  | AC01-CS WSZ. Potwierdzić obrys, impuls rozruchowy, temperaturę i koordynację z F1. | https://www.digikey.com/en/products/detail/vishay-beyschlag-draloric-bc-components/AC01000902209JBMCS/28721869
Zasilacz Rev B 66 × 34 mm | C1 | Bocznik HF za mostkiem | 100n / 630V | TDK | C3225X7T2J104KT000N | Capacitor_SMD:C_1210_3225Metric | LCSC C342668 | LCSC / Mouser |  |  |  |  | 1 |  |  | Karta LCSC. Stan, cena i montaż JLCPCB do potwierdzenia. | 1210 100 nF 630 V po sprawdzeniu charakterystyki DC | SMT do potwierdzenia w JLCPCB po importowaniu BOM. X7T, sprawdzić pojemność pod napięciem DC. | https://www.lcsc.com/product-detail/C342668.html
Zasilacz Rev B 66 × 34 mm | L1 | Dławik filtra różnicowego | 1mH | Würth Elektronik | 768772102 | E27:Wurth_TI_HV_8 | C7194056 | DigiKey 2682552 |  |  |  |  | 1 |  |  | JLCPCB bez zapasu przy weryfikacji. |  | 1 mH, 0,5 A, Isat 0,55 A typ. Brak ekranu. Sprawdzić EMI, udar i rozgrzanie w rzeczywistym układzie. | https://www.we-online.com/components/products/datasheet/768772102.pdf
Zasilacz Rev B 66 × 34 mm | C2 | Magazyn energii na szynie HV | 10u / 450V | Rubycon | 450BXW10MEFR10X16 | Capacitor_THT:CP_Radial_D10.0mm_P5.00mm |  | DigiKey 6049847 | 1.95 | 1 | 0.8915 | 100 | 1 | 1.95 | 0.8915 | Potwierdzona pozycja katalogowa. |  | Ø10 mm × 16 mm nominalnie. 18 mm maks. nad PCB, raster 5 mm. 10 000 h przy 105°C. | https://www.digikey.com/es/products/detail/rubycon/450BXW10MEFR10X16/6049847
Zasilacz Rev B 66 × 34 mm | R2 | Rozładowanie szyny HV | 510k HV |  |  | Resistor_SMD:R_2010_5025Metric |  | Wycena dostawcy / RFQ |  |  |  |  | 1 |  |  | Do wyboru po zatwierdzeniu wymagań i rysunku. |  | SMT do potwierdzenia w JLCPCB po importowaniu BOM. Dwa rezystory szeregowe, potwierdzić napięcie pracy, dobrać tolerancję i udar.
Zasilacz Rev B 66 × 34 mm | R3 | Rozładowanie szyny HV | 510k HV |  |  | Resistor_SMD:R_2010_5025Metric |  | Wycena dostawcy / RFQ |  |  |  |  | 1 |  |  | Do wyboru po zatwierdzeniu wymagań i rysunku. |  | SMT do potwierdzenia w JLCPCB po importowaniu BOM.
Zasilacz Rev B 66 × 34 mm | T1 | Transformator flyback 1.2 mH ±8% | EE16 84:23:13 |  |  | E27:EE16_6pins_RFQ |  | Wycena dostawcy / RFQ |  |  |  |  | 1 |  |  | Do wyboru po zatwierdzeniu wymagań i rysunku. |  | THT / wiązka. Uzgodnić oddzielny montaż. RFQ. Potwierdzić karkas, pinout, TIW, odstępy i badania. Zwroty w raporcie.
Zasilacz Rev B 66 × 34 mm | C3 | Kondensator ogranicznika RCD | 1.5n / 200V | KYOCERA AVX | 08052C152KAT2A | Capacitor_SMD:C_0805_2012Metric | Niepotwierdzony | DigiKey / Mouser, wyszukiwanie po MPN |  |  |  |  | 1 |  |  | MPN kandydacki. Dostępność, cena i cykl życia niepotwierdzone. | Element równoważny po sprawdzeniu wartości, obudowy, temperatury i parametrów impulsowych | SMT do potwierdzenia w JLCPCB po importowaniu BOM.
Zasilacz Rev B 66 × 34 mm | R4 | Rezystor ogranicznika RCD | 1M | Panasonic | ERJ-8GEYJ105V | Resistor_SMD:R_1206_3216Metric | Niepotwierdzony | DigiKey / Mouser, wyszukiwanie po MPN |  |  |  |  | 1 |  |  | MPN kandydacki. Dostępność, cena i cykl życia niepotwierdzone. | Element równoważny po sprawdzeniu wartości, obudowy, temperatury i parametrów impulsowych | SMT do potwierdzenia w JLCPCB po importowaniu BOM.
Zasilacz Rev B 66 × 34 mm | D5 | Dioda ogranicznika RCD | US1J | Diodes Inc. | US1J-13-F | Diode_SMD:D_SMA | Niepotwierdzony | DigiKey / Mouser, wyszukiwanie po MPN |  |  |  |  | 1 |  |  | MPN kandydacki. Dostępność, cena i cykl życia niepotwierdzone. | Element równoważny po sprawdzeniu wartości, obudowy, temperatury i parametrów impulsowych | SMT do potwierdzenia w JLCPCB po importowaniu BOM. Potwierdzić impulsy, temperaturę i rzeczywiste VDS.
Zasilacz Rev B 66 × 34 mm | D6 | Prostownik uzwojenia pomocniczego | DFLU1200 | Diodes Inc. | DFLU1200-7 | Diode_SMD:D_PowerDI-123 | Niepotwierdzony | DigiKey / Mouser, wyszukiwanie po MPN |  |  |  |  | 1 |  |  | MPN kandydacki. Dostępność, cena i cykl życia niepotwierdzone. | Element równoważny po sprawdzeniu wartości, obudowy, temperatury i parametrów impulsowych | SMT do potwierdzenia w JLCPCB po importowaniu BOM.
Zasilacz Rev B 66 × 34 mm | C4 | Zasobnik zasilania BPP | 22u / 35V | TDK | C3216X5R1V226M160AC | Capacitor_SMD:C_1206_3216Metric | Niepotwierdzony | DigiKey / Mouser, wyszukiwanie po MPN |  |  |  |  | 1 |  |  | MPN kandydacki. Dostępność, cena i cykl życia niepotwierdzone. | Element równoważny po sprawdzeniu wartości, obudowy, temperatury i parametrów impulsowych | SMT do potwierdzenia w JLCPCB po importowaniu BOM.
Zasilacz Rev B 66 × 34 mm | R5 | Ograniczenie prądu zasilania BPP | 10k | Panasonic | ERJ-6ENF1002V | Resistor_SMD:R_0805_2012Metric | Niepotwierdzony | DigiKey / Mouser, wyszukiwanie po MPN |  |  |  |  | 1 |  |  | MPN kandydacki. Dostępność, cena i cykl życia niepotwierdzone. | Element równoważny po sprawdzeniu wartości, obudowy, temperatury i parametrów impulsowych | SMT do potwierdzenia w JLCPCB po importowaniu BOM.
Zasilacz Rev B 66 × 34 mm | R6 | Pomiar napięcia szyny V | 2.2M HV |  |  | Resistor_SMD:R_2010_5025Metric |  | Wycena dostawcy / RFQ |  |  |  |  | 1 |  |  | Do wyboru po zatwierdzeniu wymagań i rysunku. |  | SMT do potwierdzenia w JLCPCB po importowaniu BOM.
Zasilacz Rev B 66 × 34 mm | R7 | Pomiar napięcia szyny V | 2.2M HV |  |  | Resistor_SMD:R_2010_5025Metric |  | Wycena dostawcy / RFQ |  |  |  |  | 1 |  |  | Do wyboru po zatwierdzeniu wymagań i rysunku. |  | SMT do potwierdzenia w JLCPCB po importowaniu BOM.
Zasilacz Rev B 66 × 34 mm | C5 | Odprzęganie BPP | 470n / 50V | Murata | GRM21BR71H474KA88L | Capacitor_SMD:C_0805_2012Metric | Niepotwierdzony | DigiKey / Mouser, wyszukiwanie po MPN |  |  |  |  | 1 |  |  | MPN kandydacki. Dostępność, cena i cykl życia niepotwierdzone. | Element równoważny po sprawdzeniu wartości, obudowy, temperatury i parametrów impulsowych | SMT do potwierdzenia w JLCPCB po importowaniu BOM.
Zasilacz Rev B 66 × 34 mm | U1 | Flyback CV/CC, FluxLink, MOSFET 725 V | LYT6073C-TL | Power Integrations | LYT6073C-TL | E27:InSOP_24D | Niepotwierdzony | DigiKey / Farnell |  |  |  |  | 1 |  |  | Aktywny według DigiKey, obserwowano dostępność. Ceny USD do aktualnej wyceny. | LYT6063C-TL po przeprojektowaniu zacisku i kwalifikacji dostępności | SMT do potwierdzenia w JLCPCB po importowaniu BOM. | https://www.digikey.ca/en/products/detail/power-integrations/LYT6073C-TL/8346132
Zasilacz Rev B 66 × 34 mm | CY1 | Tłumienie zakłóceń wspólnych | 2.2n Y1 | Vishay | 440LD22-R | E27:CY1_10mm | Niepotwierdzony | Vishay / Mouser |  |  |  |  | 1 |  |  | MPN producenta, cena i zapas do RFQ. | Vishay VY1 2,2 nF Y1 z odpowiednim rozstawem i aprobatami | THT / wiązka. Uzgodnić oddzielny montaż. Y1, rozstaw 10 mm, sprawdzić obudowę, dostępność i prąd dotykowy. Można pominąć podczas pierwszej serii pomiarów. | https://www.vishay.com/docs/23102/440lseries.pdf
Zasilacz Rev B 66 × 34 mm | D7 | Prostownik po stronie niskiej 200 V | SK3200B | MCC | SK3200B-LTP | Diode_SMD:D_SMB | Niepotwierdzony | DigiKey / Mouser, wyszukiwanie po MPN |  |  |  |  | 1 |  |  | MPN kandydacki. Dostępność, cena i cykl życia niepotwierdzone. | Element równoważny po sprawdzeniu wartości, obudowy, temperatury i parametrów impulsowych | SMT do potwierdzenia w JLCPCB po importowaniu BOM.
Zasilacz Rev B 66 × 34 mm | C6 | Kondensator wyjściowy | 470u / 50V | Nichicon | UCM1H471MNJ1MS | E27:UCM_12p5 |  | DigiKey 10719163 |  |  |  |  | 1 |  |  | Potwierdzona pozycja katalogowa. |  | 470 µF/50 V, Ø12,5 × 13,5 mm nominalnie. 5 000 h przy 105°C. Zweryfikować lutowanie reflow i nagrzewanie. | https://www.digikey.sg/en/products/detail/nichicon/UCM1H471MNJ1MS/10719163
Zasilacz Rev B 66 × 34 mm | R8 | Pomiar sygnału FWD | 47R | Panasonic | ERJ-6GEYJ470V | Resistor_SMD:R_0805_2012Metric | Niepotwierdzony | DigiKey / Mouser, wyszukiwanie po MPN |  |  |  |  | 1 |  |  | MPN kandydacki. Dostępność, cena i cykl życia niepotwierdzone. | Element równoważny po sprawdzeniu wartości, obudowy, temperatury i parametrów impulsowych | SMT do potwierdzenia w JLCPCB po importowaniu BOM.
Zasilacz Rev B 66 × 34 mm | C7 | Filtr FWD | 68p / 200V | KEMET | C0603C680J2GACTU | Capacitor_SMD:C_0603_1608Metric | Niepotwierdzony | DigiKey / Mouser, wyszukiwanie po MPN |  |  |  |  | 1 |  |  | MPN kandydacki. Dostępność, cena i cykl życia niepotwierdzone. | Element równoważny po sprawdzeniu wartości, obudowy, temperatury i parametrów impulsowych | SMT do potwierdzenia w JLCPCB po importowaniu BOM.
Zasilacz Rev B 66 × 34 mm | R9 | Limit sumy prądów 326 mA typ. | 0.11R | Yageo | RL0805FR-070R11L | Resistor_SMD:R_0805_2012Metric | Niepotwierdzony | DigiKey / Mouser, wyszukiwanie po MPN |  |  |  |  | 1 |  |  | MPN kandydacki. Dostępność, cena i cykl życia niepotwierdzone. | Element równoważny po sprawdzeniu wartości, obudowy, temperatury i parametrów impulsowych | 317–336 mA przy 25°C z tolerancją R9 ±1%. Sprawdzić przebieg i temperaturę.
Zasilacz Rev B 66 × 34 mm | D8 | Ochrona wejścia IS | US1B | Diodes Inc. | US1B-13-F | Diode_SMD:D_SMA | Niepotwierdzony | DigiKey / Mouser, wyszukiwanie po MPN |  |  |  |  | 1 |  |  | MPN kandydacki. Dostępność, cena i cykl życia niepotwierdzone. | Element równoważny po sprawdzeniu wartości, obudowy, temperatury i parametrów impulsowych | SMT do potwierdzenia w JLCPCB po importowaniu BOM. Potwierdzić polaryzację z referencją oraz amplitudę impulsów na IS.
Zasilacz Rev B 66 × 34 mm | R10 | Górna gałąź CV | 110k 0.1% | Panasonic | ERA-3AEB114V | Resistor_SMD:R_0603_1608Metric |  | RFQ |  |  |  |  | 1 |  |  | Potwierdzić zakup dokładnego MPN i tolerancję przed zamówieniem. |  | Dzielnik CV, ±25 ppm/K.
Zasilacz Rev B 66 × 34 mm | R11 | Dolna gałąź CV | 5.62k 0.1% | Panasonic | ERA-3AEB5621V | Resistor_SMD:R_0603_1608Metric |  | RFQ |  |  |  |  | 1 |  |  | Potwierdzić zakup dokładnego MPN i tolerancję przed zamówieniem. |  | Dzielnik CV, ±25 ppm/K.
Zasilacz Rev B 66 × 34 mm | C8 | Odprzęganie FB | 330p | Yageo | CC0603KRX7R9BB331 | Capacitor_SMD:C_0603_1608Metric | Niepotwierdzony | DigiKey / Mouser, wyszukiwanie po MPN |  |  |  |  | 1 |  |  | MPN kandydacki. Dostępność, cena i cykl życia niepotwierdzone. | Element równoważny po sprawdzeniu wartości, obudowy, temperatury i parametrów impulsowych | SMT do potwierdzenia w JLCPCB po importowaniu BOM.
Zasilacz Rev B 66 × 34 mm | C9 | Odprzęganie BPS | 2.2u / 25V | Taiyo Yuden | TMK316B7225KL-T | Capacitor_SMD:C_1206_3216Metric | Niepotwierdzony | DigiKey / Mouser, wyszukiwanie po MPN |  |  |  |  | 1 |  |  | MPN kandydacki. Dostępność, cena i cykl życia niepotwierdzone. | Element równoważny po sprawdzeniu wartości, obudowy, temperatury i parametrów impulsowych | SMT do potwierdzenia w JLCPCB po importowaniu BOM.
Zasilacz Rev B 66 × 34 mm | R12 | Prąd polaryzacji zenera VO | 2.2k | Panasonic | ERJ-6ENF2201V | Resistor_SMD:R_0805_2012Metric | Niepotwierdzony | DigiKey / Mouser, wyszukiwanie po MPN |  |  |  |  | 1 |  |  | MPN kandydacki. Dostępność, cena i cykl życia niepotwierdzone. | Element równoważny po sprawdzeniu wartości, obudowy, temperatury i parametrów impulsowych | SMT do potwierdzenia w JLCPCB po importowaniu BOM.
Zasilacz Rev B 66 × 34 mm | ZD1 | Ograniczenie zasilania pinu VO | 18V | Diodes Inc. | BZT52C18-7-F | Diode_SMD:D_SOD-123 | Niepotwierdzony | DigiKey / Mouser, wyszukiwanie po MPN |  |  |  |  | 1 |  |  | MPN kandydacki. Dostępność, cena i cykl życia niepotwierdzone. | Element równoważny po sprawdzeniu wartości, obudowy, temperatury i parametrów impulsowych | SMT do potwierdzenia w JLCPCB po importowaniu BOM.
Zasilacz Rev B 66 × 34 mm | Q1 | Wtórnik zasilający pin VO | MMBT5551 | onsemi | MMBT5551LT1G | Package_TO_SOT_SMD:SOT-23 | LCSC C41095 | LCSC / Mouser | 0.0258 | 20 | 0.0108 | 9000 | 1 | 0.0258 | 0.0108 | Ofertę LCSC i stan zweryfikowano. Stan montażowy JLCPCB do potwierdzenia. | MMBT5551-7-F po weryfikacji pinów i SOA | SMT do potwierdzenia w JLCPCB po importowaniu BOM. | https://www.lcsc.com/product-detail/Bipolar-BJT_onsemi-MMBT5551LT1G_C41095.html
Zasilacz Rev B 66 × 34 mm | C10 | Odprzęganie VO | 100n / 50V | Murata | GRM21BR71H104KA01L | Capacitor_SMD:C_0805_2012Metric | JLCPCB i LCSC C77082 | LCSC / DigiKey |  |  |  |  | 1 |  |  | Karta JLCPCB Extended, montaż SMT Economy/Standard. Zapas i ceny JLC po wycenie. | Samsung CL21B104KBCNNNC, LCSC C1711, potwierdzić DC bias | SMT do potwierdzenia w JLCPCB po importowaniu BOM. | https://jlcpcb.com/partdetail/MurataElectronics-GRM21BR71H104KA01L/C77082
Zasilacz Rev B 66 × 34 mm | ZD2 | Wtórne wykrywanie przepięcia | 27V | Diodes Inc. | BZT52C27-7-F | Diode_SMD:D_SOD-123 | Niepotwierdzony | DigiKey / Mouser, wyszukiwanie po MPN |  |  |  |  | 1 |  |  | MPN kandydacki. Dostępność, cena i cykl życia niepotwierdzone. | Element równoważny po sprawdzeniu wartości, obudowy, temperatury i parametrów impulsowych | SMT do potwierdzenia w JLCPCB po importowaniu BOM.
Zasilacz Rev B 66 × 34 mm | R13 | Ograniczenie prądu wstrzykiwanego do BPS | 100R | Panasonic | ERJ-6ENF1000V | Resistor_SMD:R_0805_2012Metric | Niepotwierdzony | DigiKey / Mouser, wyszukiwanie po MPN |  |  |  |  | 1 |  |  | MPN kandydacki. Dostępność, cena i cykl życia niepotwierdzone. | Element równoważny po sprawdzeniu wartości, obudowy, temperatury i parametrów impulsowych | SMT do potwierdzenia w JLCPCB po importowaniu BOM.
Zasilacz Rev B 66 × 34 mm | D9 | Odcięcie BPS przy zaniku VRAW | BAV21W | Diodes Inc. | BAV21W-7-F | Diode_SMD:D_SOD-123 | Niepotwierdzony | DigiKey / Mouser, wyszukiwanie po MPN |  |  |  |  | 1 |  |  | MPN kandydacki. Dostępność, cena i cykl życia niepotwierdzone. | Element równoważny po sprawdzeniu wartości, obudowy, temperatury i parametrów impulsowych | SMT do potwierdzenia w JLCPCB po importowaniu BOM.
Zasilacz Rev B 66 × 34 mm | U2 | Niezależne OVP, soft-start, odcięcie zwarcia | TPS26600PWPR | Texas Instruments | TPS26600PWPR | E27:PWP0016A | Niepotwierdzony | TI / DigiKey / Mouser | 4.02 | 1 | 2.06184 | 2000 | 1 | 4.02 | 2.06184 | Aktywny u producenta. W USA mały zapas w sprawdzonej ofercie, w UE wymagana aktualizacja dostępności. | TPS26600PWPT, ta sama obudowa i mniejsza taśma | SMT do potwierdzenia w JLCPCB po importowaniu BOM. MODE otwarty, wyłącznik nadprądowy z auto-retry. | https://www.digikey.com/en/products/detail/texas-instruments/TPS26600PWPR/6199305
Zasilacz Rev B 66 × 34 mm | C11 | Kondensator wejścia eFuse | 100n / 50V | Murata | GRM21BR71H104KA01L | Capacitor_SMD:C_0805_2012Metric | JLCPCB i LCSC C77082 | LCSC / DigiKey |  |  |  |  | 1 |  |  | Karta JLCPCB Extended, montaż SMT Economy/Standard. Zapas i ceny JLC po wycenie. | Samsung CL21B104KBCNNNC, LCSC C1711, potwierdzić DC bias | SMT do potwierdzenia w JLCPCB po importowaniu BOM. | https://jlcpcb.com/partdetail/MurataElectronics-GRM21BR71H104KA01L/C77082
Zasilacz Rev B 66 × 34 mm | R14 | Górna gałąź OVP | 226k 0.1% | Panasonic | ERA-3AEB2263V | Resistor_SMD:R_0603_1608Metric |  | RFQ |  |  |  |  | 1 |  |  | Potwierdzić zakup dokładnego MPN i tolerancję przed zamówieniem. |  | OVP typ. 28,08 V, uwzględnić skrajne progi komparatora.
Zasilacz Rev B 66 × 34 mm | R15 | Dolna gałąź OVP | 10k 0.1% | Panasonic | ERA-3AEB103V | Resistor_SMD:R_0603_1608Metric |  | RFQ |  |  |  |  | 1 |  |  | Potwierdzić zakup dokładnego MPN i tolerancję przed zamówieniem. |  | Dzielnik OVP, ±25 ppm/K.
Zasilacz Rev B 66 × 34 mm | R16 | Wyłącznik nadprądowy ok. 0.37 A typ. | 30.1k 1% | Panasonic | ERJ-3EKF3012V | Resistor_SMD:R_0603_1608Metric | Niepotwierdzony | DigiKey / Mouser, wyszukiwanie po MPN |  |  |  |  | 1 |  |  | MPN kandydacki. Dostępność, cena i cykl życia niepotwierdzone. | Element równoważny po sprawdzeniu wartości, obudowy, temperatury i parametrów impulsowych | SMT do potwierdzenia w JLCPCB po importowaniu BOM.
Zasilacz Rev B 66 × 34 mm | C12 | Rampa wyjścia ~10 ms | 47n | Yageo | CC0603KRX7R9BB473 | Capacitor_SMD:C_0603_1608Metric | Niepotwierdzony | DigiKey / Mouser, wyszukiwanie po MPN |  |  |  |  | 1 |  |  | MPN kandydacki. Dostępność, cena i cykl życia niepotwierdzone. | Element równoważny po sprawdzeniu wartości, obudowy, temperatury i parametrów impulsowych | SMT do potwierdzenia w JLCPCB po importowaniu BOM.
Zasilacz Rev B 66 × 34 mm | R17 | Zasilanie pętli S1 i termostatu | 10k | Panasonic | ERJ-3EKF1002V | Resistor_SMD:R_0603_1608Metric | Niepotwierdzony | DigiKey / Mouser, wyszukiwanie po MPN |  |  |  |  | 1 |  |  | MPN kandydacki. Dostępność, cena i cykl życia niepotwierdzone. | Element równoważny po sprawdzeniu wartości, obudowy, temperatury i parametrów impulsowych | SMT do potwierdzenia w JLCPCB po importowaniu BOM.
Zasilacz Rev B 66 × 34 mm | R18 | Domyślne wyłączenie SHDN | 10k | Panasonic | ERJ-3EKF1002V | Resistor_SMD:R_0603_1608Metric | Niepotwierdzony | DigiKey / Mouser, wyszukiwanie po MPN |  |  |  |  | 1 |  |  | MPN kandydacki. Dostępność, cena i cykl życia niepotwierdzone. | Element równoważny po sprawdzeniu wartości, obudowy, temperatury i parametrów impulsowych | SMT do potwierdzenia w JLCPCB po importowaniu BOM.
Zasilacz Rev B 66 × 34 mm | R19 | Rozładowanie dostępnej anody | 10k | Panasonic | ERJ-6ENF1002V | Resistor_SMD:R_0805_2012Metric | Niepotwierdzony | DigiKey / Mouser, wyszukiwanie po MPN |  |  |  |  | 1 |  |  | MPN kandydacki. Dostępność, cena i cykl życia niepotwierdzone. | Element równoważny po sprawdzeniu wartości, obudowy, temperatury i parametrów impulsowych | SMT do potwierdzenia w JLCPCB po importowaniu BOM.
Zasilacz Rev B 66 × 34 mm | C13 | Odprzęganie wyjścia eFuse | 100n / 50V | Murata | GRM21BR71H104KA01L | Capacitor_SMD:C_0805_2012Metric | JLCPCB i LCSC C77082 | LCSC / DigiKey |  |  |  |  | 1 |  |  | Karta JLCPCB Extended, montaż SMT Economy/Standard. Zapas i ceny JLC po wycenie. | Samsung CL21B104KBCNNNC, LCSC C1711, potwierdzić DC bias | SMT do potwierdzenia w JLCPCB po importowaniu BOM. | https://jlcpcb.com/partdetail/MurataElectronics-GRM21BR71H104KA01L/C77082
Zasilacz Rev B 66 × 34 mm | J2 | Wiązka dwóch blokad i termostatu | S1+TH / S2 |  |  | E27:Harness_4pos |  | RFQ wiązki |  |  |  |  | 1 |  |  | Złącze blokowane poza płytką. Dobór po próbach mechanicznych. |  | Przewody do S1/TH1 i S2 lutowane, odciążone w korpusie. Złącze serwisowe poza PCB.
Zasilacz Rev B 66 × 34 mm | J3 | Wiązka do trzech sprężynujących styków | A+ / KA / KB |  |  | E27:Harness_3pos |  | RFQ wiązki |  |  |  |  | 1 |  |  | Złącze blokowane poza płytką. Dobór po próbach mechanicznych. |  | Przewody A+/K1/K2 lutowane, odciążone w korpusie. Złącze serwisowe poza PCB.
Zasilacz Rev B 66 × 34 mm | U3 | Niezależny prąd szeregu LED | AL5812MP-13 | Diodes Inc. | AL5812MP-13 | E27:E27_Al5812_MSOP | Niepotwierdzony | DigiKey | 0.76 | 1 | 0.34656 | 2500 | 1 | 0.76 | 0.34656 | Karta dystrybutora. Zapas w dniu zakupu do potwierdzenia. | AL5812FF-7, wymaga innego footprintu | SMT do potwierdzenia w JLCPCB po importowaniu BOM. | https://www.digikey.com/en/products/detail/diodes-incorporated/AL5812MP-13/3678196
Zasilacz Rev B 66 × 34 mm | R20 | Prąd typ. 127 mA | 5.90k 1% | Panasonic | ERJ-3EKF5901V | Resistor_SMD:R_0603_1608Metric | Niepotwierdzony | DigiKey / Mouser, wyszukiwanie po MPN |  |  |  |  | 1 |  |  | MPN kandydacki. Dostępność, cena i cykl życia niepotwierdzone. | Element równoważny po sprawdzeniu wartości, obudowy, temperatury i parametrów impulsowych | SMT do potwierdzenia w JLCPCB po importowaniu BOM.
Zasilacz Rev B 66 × 34 mm | C14 | Odprzęganie lokalnego źródła prądu | 100n / 50V | Murata | GRM21BR71H104KA01L | Capacitor_SMD:C_0805_2012Metric | JLCPCB i LCSC C77082 | LCSC / DigiKey |  |  |  |  | 1 |  |  | Karta JLCPCB Extended, montaż SMT Economy/Standard. Zapas i ceny JLC po wycenie. | Samsung CL21B104KBCNNNC, LCSC C1711, potwierdzić DC bias | SMT do potwierdzenia w JLCPCB po importowaniu BOM. | https://jlcpcb.com/partdetail/MurataElectronics-GRM21BR71H104KA01L/C77082
Zasilacz Rev B 66 × 34 mm | U4 | Niezależny prąd szeregu LED | AL5812MP-13 | Diodes Inc. | AL5812MP-13 | E27:E27_Al5812_MSOP | Niepotwierdzony | DigiKey | 0.76 | 1 | 0.34656 | 2500 | 1 | 0.76 | 0.34656 | Karta dystrybutora. Zapas w dniu zakupu do potwierdzenia. | AL5812FF-7, wymaga innego footprintu | SMT do potwierdzenia w JLCPCB po importowaniu BOM. | https://www.digikey.com/en/products/detail/diodes-incorporated/AL5812MP-13/3678196
Zasilacz Rev B 66 × 34 mm | R21 | Prąd typ. 127 mA | 5.90k 1% | Panasonic | ERJ-3EKF5901V | Resistor_SMD:R_0603_1608Metric | Niepotwierdzony | DigiKey / Mouser, wyszukiwanie po MPN |  |  |  |  | 1 |  |  | MPN kandydacki. Dostępność, cena i cykl życia niepotwierdzone. | Element równoważny po sprawdzeniu wartości, obudowy, temperatury i parametrów impulsowych | SMT do potwierdzenia w JLCPCB po importowaniu BOM.
Zasilacz Rev B 66 × 34 mm | C15 | Odprzęganie lokalnego źródła prądu | 100n / 50V | Murata | GRM21BR71H104KA01L | Capacitor_SMD:C_0805_2012Metric | JLCPCB i LCSC C77082 | LCSC / DigiKey |  |  |  |  | 1 |  |  | Karta JLCPCB Extended, montaż SMT Economy/Standard. Zapas i ceny JLC po wycenie. | Samsung CL21B104KBCNNNC, LCSC C1711, potwierdzić DC bias | SMT do potwierdzenia w JLCPCB po importowaniu BOM. | https://jlcpcb.com/partdetail/MurataElectronics-GRM21BR71H104KA01L/C77082
Zasilacz Rev B 66 × 34 mm | BR1 | Mostek 0,5 A / 1 kV | MB10S | onsemi | MB10S | Package_SO:OnSemi_751EP_SOIC-4_3.9x4.725mm_P2.54mm |  | DigiKey MB10SCT-ND |  |  |  |  | 1 |  |  | Potwierdzona pozycja katalogowa. |  | Porównać znaki na obudowie i wynik testu diod przed montażem. | https://www.onsemi.com/download/data-sheet/pdf/mb10s-d.pdf
