kamelele/Velluneo-2.0/hardware/E27/outputs/BOM_E27_RevA.csv

Zespół / wariant | Oznaczenie | Nazwa i funkcja | Parametry | Producent | MPN | Obudowa / footprint | JLCPCB / LCSC | Dystrybutor alternatywny | USD/szt. 1 lub MOQ | Próg mały [części] | USD/szt. większy próg | Próg duży [części] | Ilość na płytce / zespole | Koszt pozycji USD przy progu małym | Koszt pozycji USD przy progu dużym | Dostępność i cykl życia | Zamiennik do weryfikacji | Uwagi montażowe | Źródło
Zasilacz 75 × 40 mm | J1 | Przewody L i N z E27 | 230 VAC |  |  | E27:Mains_L_N |  | Wycena dostawcy / RFQ |  |  |  |  | 1 |  |  | Do wyboru po zatwierdzeniu wymagań i rysunku. |  | THT / wiązka. Uzgodnić oddzielny montaż. Stałe lutowanie i odciążenie przewodów.
Zasilacz 75 × 40 mm | F1 | Bezpiecznik zwłoczny | T 1 A / 300 VAC | Littelfuse | 36911000000 | E27:Fuse_TE5 | Niepotwierdzony | DigiKey | 0.93 | 1 | 0.36159 | 1400 | 1 | 0.93 | 0.36159 | Aktywny według DigiKey. 50 A zdolności wyłączania, do stanowiska o ograniczonej energii. | Wersja docelowa zależnie od spodziewanego prądu zwarciowego | THT / wiązka. Uzgodnić oddzielny montaż. Sprawdź zdolność wyłączania, I²t, charakterystykę przeciążenia i koordynację z MOV. | https://www.digikey.com/en/products/detail/littelfuse-inc/36911000000/1986930
Zasilacz 75 × 40 mm | RV1 | Ogranicznik przepięć z odcięciem termicznym | 275 VAC | Littelfuse | TMOV14RP275E | E27:TMOV14 | Niepotwierdzony | Littelfuse / DigiKey |  |  |  |  | 1 |  |  | MPN producenta, cena i zapas do RFQ. | iTMOV14RP275M z adaptacją footprintu i badaniem | THT / wiązka. Uzgodnić oddzielny montaż. | https://www.littelfuse.com/assetdocs/tmov-itmov?assetguid=bd475732-1071-4352-b8aa-f78b0007eb05
Zasilacz 75 × 40 mm | R1 | Ograniczenie prądu udarowego | 22R pulse |  |  | Resistor_THT:R_Axial_DIN0207_L6.3mm_D2.5mm_P10.16mm_Horizontal |  | Wycena dostawcy / RFQ |  |  |  |  | 1 |  |  | Do wyboru po zatwierdzeniu wymagań i rysunku. |  | THT / wiązka. Uzgodnić oddzielny montaż. RFQ 22 Ω 1 W, odporny na impuls, flameproof. Dopasować do obudowy, potwierdzić I²t.
Zasilacz 75 × 40 mm | D1 | Prostownik mostkowy 1 kV | US1M | Diodes Inc. | US1M-13-F | Diode_SMD:D_SMA | LCSC C99333 | LCSC / DigiKey | 0.062 | 10 | 0.0324 | 10000 | 1 | 0.062 | 0.0324 | Ofertę LCSC i stan zweryfikowano. Stan montażowy JLCPCB do potwierdzenia. | ES1M-13-F po IFSM i EMC | SMT do potwierdzenia w JLCPCB po importowaniu BOM. Sprawdzić IFSM i orientację. | https://www.lcsc.com/product-image/C99333.html
Zasilacz 75 × 40 mm | D2 | Prostownik mostkowy 1 kV | US1M | Diodes Inc. | US1M-13-F | Diode_SMD:D_SMA | LCSC C99333 | LCSC / DigiKey | 0.062 | 10 | 0.0324 | 10000 | 1 | 0.062 | 0.0324 | Ofertę LCSC i stan zweryfikowano. Stan montażowy JLCPCB do potwierdzenia. | ES1M-13-F po IFSM i EMC | SMT do potwierdzenia w JLCPCB po importowaniu BOM. Sprawdzić IFSM i orientację. | https://www.lcsc.com/product-image/C99333.html
Zasilacz 75 × 40 mm | D3 | Prostownik mostkowy 1 kV | US1M | Diodes Inc. | US1M-13-F | Diode_SMD:D_SMA | LCSC C99333 | LCSC / DigiKey | 0.062 | 10 | 0.0324 | 10000 | 1 | 0.062 | 0.0324 | Ofertę LCSC i stan zweryfikowano. Stan montażowy JLCPCB do potwierdzenia. | ES1M-13-F po IFSM i EMC | SMT do potwierdzenia w JLCPCB po importowaniu BOM. Sprawdzić IFSM i orientację. | https://www.lcsc.com/product-image/C99333.html
Zasilacz 75 × 40 mm | D4 | Prostownik mostkowy 1 kV | US1M | Diodes Inc. | US1M-13-F | Diode_SMD:D_SMA | LCSC C99333 | LCSC / DigiKey | 0.062 | 10 | 0.0324 | 10000 | 1 | 0.062 | 0.0324 | Ofertę LCSC i stan zweryfikowano. Stan montażowy JLCPCB do potwierdzenia. | ES1M-13-F po IFSM i EMC | SMT do potwierdzenia w JLCPCB po importowaniu BOM. Sprawdzić IFSM i orientację. | https://www.lcsc.com/product-image/C99333.html
Zasilacz 75 × 40 mm | C1 | Bocznik HF za mostkiem | 100n / 630V | TDK | C3225X7T2J104KT000N | Capacitor_SMD:C_1210_3225Metric | LCSC C342668 | LCSC / Mouser |  |  |  |  | 1 |  |  | Karta LCSC. Stan, cena i montaż JLCPCB do potwierdzenia. | 1210 100 nF 630 V po sprawdzeniu charakterystyki DC | SMT do potwierdzenia w JLCPCB po importowaniu BOM. X7T, sprawdzić pojemność pod napięciem DC. | https://www.lcsc.com/product-detail/C342668.html
Zasilacz 75 × 40 mm | L1 | Dławik filtra różnicowego | 1mH | Bourns | SRR1005-102K | Inductor_SMD:L_Bourns-SRR1005 | Niepotwierdzony | Bourns / Mouser |  |  |  |  | 1 |  |  | Katalog producenta, cena i zapas do RFQ. | Inny 1 mH o wyższym Isat i zweryfikowanej izolacji | SMT do potwierdzenia w JLCPCB po importowaniu BOM. Sprawdzić Isat, temperaturę oraz izolację węzła DC. | https://bourns.com/docs/Product-Datasheets/SRR1005.pdf
Zasilacz 75 × 40 mm | C2 | Magazyn energii na szynie HV | 15u / 450V | Rubycon | 450BXF15M10X20 | Capacitor_THT:CP_Radial_D10.0mm_P5.00mm | Niepotwierdzony | DigiKey / Mouser, wyszukiwanie po MPN |  |  |  |  | 1 |  |  | MPN kandydacki. Dostępność, cena i cykl życia niepotwierdzone. | Element równoważny po sprawdzeniu wartości, obudowy, temperatury i parametrów impulsowych | THT / wiązka. Uzgodnić oddzielny montaż.
Zasilacz 75 × 40 mm | R2 | Rozładowanie szyny HV | 510k HV |  |  | Resistor_SMD:R_2010_5025Metric |  | Wycena dostawcy / RFQ |  |  |  |  | 1 |  |  | Do wyboru po zatwierdzeniu wymagań i rysunku. |  | SMT do potwierdzenia w JLCPCB po importowaniu BOM. Dwa rezystory szeregowe, potwierdzić napięcie pracy, dobrać tolerancję i udar.
Zasilacz 75 × 40 mm | R3 | Rozładowanie szyny HV | 510k HV |  |  | Resistor_SMD:R_2010_5025Metric |  | Wycena dostawcy / RFQ |  |  |  |  | 1 |  |  | Do wyboru po zatwierdzeniu wymagań i rysunku. |  | SMT do potwierdzenia w JLCPCB po importowaniu BOM.
Zasilacz 75 × 40 mm | T1 | Transformator flyback 1.2 mH ±8% | EE16 84:23:13 |  |  | E27:EE16_6pins_RFQ |  | Wycena dostawcy / RFQ |  |  |  |  | 1 |  |  | Do wyboru po zatwierdzeniu wymagań i rysunku. |  | THT / wiązka. Uzgodnić oddzielny montaż. RFQ. Potwierdzić karkas, pinout, TIW, odstępy i badania. Zwroty w raporcie.
Zasilacz 75 × 40 mm | C3 | Kondensator ogranicznika RCD | 1.5n / 200V | KYOCERA AVX | 08052C152KAT2A | Capacitor_SMD:C_0805_2012Metric | Niepotwierdzony | DigiKey / Mouser, wyszukiwanie po MPN |  |  |  |  | 1 |  |  | MPN kandydacki. Dostępność, cena i cykl życia niepotwierdzone. | Element równoważny po sprawdzeniu wartości, obudowy, temperatury i parametrów impulsowych | SMT do potwierdzenia w JLCPCB po importowaniu BOM.
Zasilacz 75 × 40 mm | R4 | Rezystor ogranicznika RCD | 1M | Panasonic | ERJ-8GEYJ105V | Resistor_SMD:R_1206_3216Metric | Niepotwierdzony | DigiKey / Mouser, wyszukiwanie po MPN |  |  |  |  | 1 |  |  | MPN kandydacki. Dostępność, cena i cykl życia niepotwierdzone. | Element równoważny po sprawdzeniu wartości, obudowy, temperatury i parametrów impulsowych | SMT do potwierdzenia w JLCPCB po importowaniu BOM.
Zasilacz 75 × 40 mm | D5 | Dioda ogranicznika RCD | US1J | Diodes Inc. | US1J-13-F | Diode_SMD:D_SMA | Niepotwierdzony | DigiKey / Mouser, wyszukiwanie po MPN |  |  |  |  | 1 |  |  | MPN kandydacki. Dostępność, cena i cykl życia niepotwierdzone. | Element równoważny po sprawdzeniu wartości, obudowy, temperatury i parametrów impulsowych | SMT do potwierdzenia w JLCPCB po importowaniu BOM. Potwierdzić impulsy, temperaturę i rzeczywiste VDS.
Zasilacz 75 × 40 mm | D6 | Prostownik uzwojenia pomocniczego | DFLU1200 | Diodes Inc. | DFLU1200-7 | Diode_SMD:D_PowerDI-123 | Niepotwierdzony | DigiKey / Mouser, wyszukiwanie po MPN |  |  |  |  | 1 |  |  | MPN kandydacki. Dostępność, cena i cykl życia niepotwierdzone. | Element równoważny po sprawdzeniu wartości, obudowy, temperatury i parametrów impulsowych | SMT do potwierdzenia w JLCPCB po importowaniu BOM.
Zasilacz 75 × 40 mm | C4 | Zasobnik zasilania BPP | 22u / 35V | TDK | C3216X5R1V226M160AC | Capacitor_SMD:C_1206_3216Metric | Niepotwierdzony | DigiKey / Mouser, wyszukiwanie po MPN |  |  |  |  | 1 |  |  | MPN kandydacki. Dostępność, cena i cykl życia niepotwierdzone. | Element równoważny po sprawdzeniu wartości, obudowy, temperatury i parametrów impulsowych | SMT do potwierdzenia w JLCPCB po importowaniu BOM.
Zasilacz 75 × 40 mm | R5 | Ograniczenie prądu zasilania BPP | 10k | Panasonic | ERJ-6ENF1002V | Resistor_SMD:R_0805_2012Metric | Niepotwierdzony | DigiKey / Mouser, wyszukiwanie po MPN |  |  |  |  | 1 |  |  | MPN kandydacki. Dostępność, cena i cykl życia niepotwierdzone. | Element równoważny po sprawdzeniu wartości, obudowy, temperatury i parametrów impulsowych | SMT do potwierdzenia w JLCPCB po importowaniu BOM.
Zasilacz 75 × 40 mm | R6 | Pomiar napięcia szyny V | 2.2M HV |  |  | Resistor_SMD:R_2010_5025Metric |  | Wycena dostawcy / RFQ |  |  |  |  | 1 |  |  | Do wyboru po zatwierdzeniu wymagań i rysunku. |  | SMT do potwierdzenia w JLCPCB po importowaniu BOM.
Zasilacz 75 × 40 mm | R7 | Pomiar napięcia szyny V | 2.2M HV |  |  | Resistor_SMD:R_2010_5025Metric |  | Wycena dostawcy / RFQ |  |  |  |  | 1 |  |  | Do wyboru po zatwierdzeniu wymagań i rysunku. |  | SMT do potwierdzenia w JLCPCB po importowaniu BOM.
Zasilacz 75 × 40 mm | C5 | Odprzęganie BPP | 470n / 50V | Murata | GRM21BR71H474KA88L | Capacitor_SMD:C_0805_2012Metric | Niepotwierdzony | DigiKey / Mouser, wyszukiwanie po MPN |  |  |  |  | 1 |  |  | MPN kandydacki. Dostępność, cena i cykl życia niepotwierdzone. | Element równoważny po sprawdzeniu wartości, obudowy, temperatury i parametrów impulsowych | SMT do potwierdzenia w JLCPCB po importowaniu BOM.
Zasilacz 75 × 40 mm | U1 | Flyback CV/CC, FluxLink, MOSFET 725 V | LYT6073C-TL | Power Integrations | LYT6073C-TL | E27:InSOP_24D | Niepotwierdzony | DigiKey / Farnell |  |  |  |  | 1 |  |  | Aktywny według DigiKey, obserwowano dostępność. Ceny USD do aktualnej wyceny. | LYT6063C-TL po przeprojektowaniu zacisku i kwalifikacji dostępności | SMT do potwierdzenia w JLCPCB po importowaniu BOM. | https://www.digikey.ca/en/products/detail/power-integrations/LYT6073C-TL/8346132
Zasilacz 75 × 40 mm | CY1 | Tłumienie zakłóceń wspólnych | 2.2n Y1 | Vishay | 440LD22-R | E27:CY1_10mm | Niepotwierdzony | Vishay / Mouser |  |  |  |  | 1 |  |  | MPN producenta, cena i zapas do RFQ. | Vishay VY1 2,2 nF Y1 z odpowiednim rozstawem i aprobatami | THT / wiązka. Uzgodnić oddzielny montaż. Y1, rozstaw 10 mm, sprawdzić obudowę, dostępność i prąd dotykowy. Można pominąć podczas pierwszej serii pomiarów. | https://www.vishay.com/docs/23102/440lseries.pdf
Zasilacz 75 × 40 mm | D7 | Prostownik po stronie niskiej 200 V | SK3200B | MCC | SK3200B-LTP | Diode_SMD:D_SMB | Niepotwierdzony | DigiKey / Mouser, wyszukiwanie po MPN |  |  |  |  | 1 |  |  | MPN kandydacki. Dostępność, cena i cykl życia niepotwierdzone. | Element równoważny po sprawdzeniu wartości, obudowy, temperatury i parametrów impulsowych | SMT do potwierdzenia w JLCPCB po importowaniu BOM.
Zasilacz 75 × 40 mm | C6 | Kondensator wyjściowy | 470u / 50V | Panasonic | EEU-FR1H471 | Capacitor_THT:CP_Radial_D12.5mm_P5.00mm | Niepotwierdzony | DigiKey |  |  |  |  | 1 |  |  | Aktywny w katalogu. Sprawdzić ceny i bieżący zapas. | EEU-FR1H331 tylko po sprawdzeniu tętnień i opóźnień | THT / wiązka. Uzgodnić oddzielny montaż. | https://www.digikey.com/en/products/detail/panasonic-industry/EEU-FR1H471/2433595
Zasilacz 75 × 40 mm | R8 | Pomiar sygnału FWD | 47R | Panasonic | ERJ-6GEYJ470V | Resistor_SMD:R_0805_2012Metric | Niepotwierdzony | DigiKey / Mouser, wyszukiwanie po MPN |  |  |  |  | 1 |  |  | MPN kandydacki. Dostępność, cena i cykl życia niepotwierdzone. | Element równoważny po sprawdzeniu wartości, obudowy, temperatury i parametrów impulsowych | SMT do potwierdzenia w JLCPCB po importowaniu BOM.
Zasilacz 75 × 40 mm | C7 | Filtr FWD | 68p / 200V | KEMET | C0603C680J2GACTU | Capacitor_SMD:C_0603_1608Metric | Niepotwierdzony | DigiKey / Mouser, wyszukiwanie po MPN |  |  |  |  | 1 |  |  | MPN kandydacki. Dostępność, cena i cykl życia niepotwierdzone. | Element równoważny po sprawdzeniu wartości, obudowy, temperatury i parametrów impulsowych | SMT do potwierdzenia w JLCPCB po importowaniu BOM.
Zasilacz 75 × 40 mm | R9 | Limit sumy prądów ~318 mA | 0.11R | Yageo | RL0805FR-070R11L | Resistor_SMD:R_0805_2012Metric | Niepotwierdzony | DigiKey / Mouser, wyszukiwanie po MPN |  |  |  |  | 1 |  |  | MPN kandydacki. Dostępność, cena i cykl życia niepotwierdzone. | Element równoważny po sprawdzeniu wartości, obudowy, temperatury i parametrów impulsowych | SMT do potwierdzenia w JLCPCB po importowaniu BOM.
Zasilacz 75 × 40 mm | D8 | Ochrona wejścia IS | US1B | Diodes Inc. | US1B-13-F | Diode_SMD:D_SMA | Niepotwierdzony | DigiKey / Mouser, wyszukiwanie po MPN |  |  |  |  | 1 |  |  | MPN kandydacki. Dostępność, cena i cykl życia niepotwierdzone. | Element równoważny po sprawdzeniu wartości, obudowy, temperatury i parametrów impulsowych | SMT do potwierdzenia w JLCPCB po importowaniu BOM. Potwierdzić polaryzację z referencją oraz amplitudę impulsów na IS.
Zasilacz 75 × 40 mm | R10 | Górna gałąź CV | 110k 1% | Panasonic | ERJ-3EKF1103V | Resistor_SMD:R_0603_1608Metric | Niepotwierdzony | DigiKey / Mouser, wyszukiwanie po MPN |  |  |  |  | 1 |  |  | MPN kandydacki. Dostępność, cena i cykl życia niepotwierdzone. | Element równoważny po sprawdzeniu wartości, obudowy, temperatury i parametrów impulsowych | SMT do potwierdzenia w JLCPCB po importowaniu BOM.
Zasilacz 75 × 40 mm | R11 | Dolna gałąź CV | 5.62k 1% | Panasonic | ERJ-3EKF5621V | Resistor_SMD:R_0603_1608Metric | Niepotwierdzony | DigiKey / Mouser, wyszukiwanie po MPN |  |  |  |  | 1 |  |  | MPN kandydacki. Dostępność, cena i cykl życia niepotwierdzone. | Element równoważny po sprawdzeniu wartości, obudowy, temperatury i parametrów impulsowych | SMT do potwierdzenia w JLCPCB po importowaniu BOM.
Zasilacz 75 × 40 mm | C8 | Odprzęganie FB | 330p | Yageo | CC0603KRX7R9BB331 | Capacitor_SMD:C_0603_1608Metric | Niepotwierdzony | DigiKey / Mouser, wyszukiwanie po MPN |  |  |  |  | 1 |  |  | MPN kandydacki. Dostępność, cena i cykl życia niepotwierdzone. | Element równoważny po sprawdzeniu wartości, obudowy, temperatury i parametrów impulsowych | SMT do potwierdzenia w JLCPCB po importowaniu BOM.
Zasilacz 75 × 40 mm | C9 | Odprzęganie BPS | 2.2u / 25V | Taiyo Yuden | TMK316B7225KL-T | Capacitor_SMD:C_1206_3216Metric | Niepotwierdzony | DigiKey / Mouser, wyszukiwanie po MPN |  |  |  |  | 1 |  |  | MPN kandydacki. Dostępność, cena i cykl życia niepotwierdzone. | Element równoważny po sprawdzeniu wartości, obudowy, temperatury i parametrów impulsowych | SMT do potwierdzenia w JLCPCB po importowaniu BOM.
Zasilacz 75 × 40 mm | R12 | Prąd polaryzacji zenera VO | 2.2k | Panasonic | ERJ-6ENF2201V | Resistor_SMD:R_0805_2012Metric | Niepotwierdzony | DigiKey / Mouser, wyszukiwanie po MPN |  |  |  |  | 1 |  |  | MPN kandydacki. Dostępność, cena i cykl życia niepotwierdzone. | Element równoważny po sprawdzeniu wartości, obudowy, temperatury i parametrów impulsowych | SMT do potwierdzenia w JLCPCB po importowaniu BOM.
Zasilacz 75 × 40 mm | ZD1 | Ograniczenie zasilania pinu VO | 18V | Diodes Inc. | BZT52C18-7-F | Diode_SMD:D_SOD-123 | Niepotwierdzony | DigiKey / Mouser, wyszukiwanie po MPN |  |  |  |  | 1 |  |  | MPN kandydacki. Dostępność, cena i cykl życia niepotwierdzone. | Element równoważny po sprawdzeniu wartości, obudowy, temperatury i parametrów impulsowych | SMT do potwierdzenia w JLCPCB po importowaniu BOM.
Zasilacz 75 × 40 mm | Q1 | Wtórnik zasilający pin VO | MMBT5551 | onsemi | MMBT5551LT1G | Package_TO_SOT_SMD:SOT-23 | LCSC C41095 | LCSC / Mouser | 0.0258 | 20 | 0.0108 | 9000 | 1 | 0.0258 | 0.0108 | Ofertę LCSC i stan zweryfikowano. Stan montażowy JLCPCB do potwierdzenia. | MMBT5551-7-F po weryfikacji pinów i SOA | SMT do potwierdzenia w JLCPCB po importowaniu BOM. | https://www.lcsc.com/product-detail/Bipolar-BJT_onsemi-MMBT5551LT1G_C41095.html
Zasilacz 75 × 40 mm | C10 | Odprzęganie VO | 100n / 50V | Murata | GRM21BR71H104KA01L | Capacitor_SMD:C_0805_2012Metric | JLCPCB i LCSC C77082 | LCSC / DigiKey |  |  |  |  | 1 |  |  | Karta JLCPCB Extended, montaż SMT Economy/Standard. Zapas i ceny JLC po wycenie. | Samsung CL21B104KBCNNNC, LCSC C1711, potwierdzić DC bias | SMT do potwierdzenia w JLCPCB po importowaniu BOM. | https://jlcpcb.com/partdetail/MurataElectronics-GRM21BR71H104KA01L/C77082
Zasilacz 75 × 40 mm | ZD2 | Wtórne wykrywanie przepięcia | 27V | Diodes Inc. | BZT52C27-7-F | Diode_SMD:D_SOD-123 | Niepotwierdzony | DigiKey / Mouser, wyszukiwanie po MPN |  |  |  |  | 1 |  |  | MPN kandydacki. Dostępność, cena i cykl życia niepotwierdzone. | Element równoważny po sprawdzeniu wartości, obudowy, temperatury i parametrów impulsowych | SMT do potwierdzenia w JLCPCB po importowaniu BOM.
Zasilacz 75 × 40 mm | R13 | Ograniczenie prądu wstrzykiwanego do BPS | 100R | Panasonic | ERJ-6ENF1000V | Resistor_SMD:R_0805_2012Metric | Niepotwierdzony | DigiKey / Mouser, wyszukiwanie po MPN |  |  |  |  | 1 |  |  | MPN kandydacki. Dostępność, cena i cykl życia niepotwierdzone. | Element równoważny po sprawdzeniu wartości, obudowy, temperatury i parametrów impulsowych | SMT do potwierdzenia w JLCPCB po importowaniu BOM.
Zasilacz 75 × 40 mm | D9 | Odcięcie BPS przy zaniku VRAW | BAV21W | Diodes Inc. | BAV21W-7-F | Diode_SMD:D_SOD-123 | Niepotwierdzony | DigiKey / Mouser, wyszukiwanie po MPN |  |  |  |  | 1 |  |  | MPN kandydacki. Dostępność, cena i cykl życia niepotwierdzone. | Element równoważny po sprawdzeniu wartości, obudowy, temperatury i parametrów impulsowych | SMT do potwierdzenia w JLCPCB po importowaniu BOM.
Zasilacz 75 × 40 mm | U2 | Niezależne OVP, soft-start, odcięcie zwarcia | TPS26600PWPR | Texas Instruments | TPS26600PWPR | E27:PWP0016A | Niepotwierdzony | TI / DigiKey / Mouser | 4.02 | 1 | 2.06184 | 2000 | 1 | 4.02 | 2.06184 | Aktywny u producenta. W USA mały zapas w sprawdzonej ofercie, w UE wymagana aktualizacja dostępności. | TPS26600PWPT, ta sama obudowa i mniejsza taśma | SMT do potwierdzenia w JLCPCB po importowaniu BOM. MODE otwarty, wyłącznik nadprądowy z auto-retry. | https://www.digikey.com/en/products/detail/texas-instruments/TPS26600PWPR/6199305
Zasilacz 75 × 40 mm | C11 | Kondensator wejścia eFuse | 100n / 50V | Murata | GRM21BR71H104KA01L | Capacitor_SMD:C_0805_2012Metric | JLCPCB i LCSC C77082 | LCSC / DigiKey |  |  |  |  | 1 |  |  | Karta JLCPCB Extended, montaż SMT Economy/Standard. Zapas i ceny JLC po wycenie. | Samsung CL21B104KBCNNNC, LCSC C1711, potwierdzić DC bias | SMT do potwierdzenia w JLCPCB po importowaniu BOM. | https://jlcpcb.com/partdetail/MurataElectronics-GRM21BR71H104KA01L/C77082
Zasilacz 75 × 40 mm | R14 | Górna gałąź OVP | 232k 1% | Panasonic | ERJ-3EKF2323V | Resistor_SMD:R_0603_1608Metric | Niepotwierdzony | DigiKey / Mouser, wyszukiwanie po MPN |  |  |  |  | 1 |  |  | MPN kandydacki. Dostępność, cena i cykl życia niepotwierdzone. | Element równoważny po sprawdzeniu wartości, obudowy, temperatury i parametrów impulsowych | SMT do potwierdzenia w JLCPCB po importowaniu BOM.
Zasilacz 75 × 40 mm | R15 | Dolna gałąź OVP, ~28.8 V typ. | 10k 1% | Panasonic | ERJ-3EKF1002V | Resistor_SMD:R_0603_1608Metric | Niepotwierdzony | DigiKey / Mouser, wyszukiwanie po MPN |  |  |  |  | 1 |  |  | MPN kandydacki. Dostępność, cena i cykl życia niepotwierdzone. | Element równoważny po sprawdzeniu wartości, obudowy, temperatury i parametrów impulsowych | SMT do potwierdzenia w JLCPCB po importowaniu BOM.
Zasilacz 75 × 40 mm | R16 | Wyłącznik nadprądowy ok. 0.37 A typ. | 30.1k 1% | Panasonic | ERJ-3EKF3012V | Resistor_SMD:R_0603_1608Metric | Niepotwierdzony | DigiKey / Mouser, wyszukiwanie po MPN |  |  |  |  | 1 |  |  | MPN kandydacki. Dostępność, cena i cykl życia niepotwierdzone. | Element równoważny po sprawdzeniu wartości, obudowy, temperatury i parametrów impulsowych | SMT do potwierdzenia w JLCPCB po importowaniu BOM.
Zasilacz 75 × 40 mm | C12 | Rampa wyjścia ~10 ms | 47n | Yageo | CC0603KRX7R9BB473 | Capacitor_SMD:C_0603_1608Metric | Niepotwierdzony | DigiKey / Mouser, wyszukiwanie po MPN |  |  |  |  | 1 |  |  | MPN kandydacki. Dostępność, cena i cykl życia niepotwierdzone. | Element równoważny po sprawdzeniu wartości, obudowy, temperatury i parametrów impulsowych | SMT do potwierdzenia w JLCPCB po importowaniu BOM.
Zasilacz 75 × 40 mm | R17 | Zasilanie pętli S1 i termostatu | 10k | Panasonic | ERJ-3EKF1002V | Resistor_SMD:R_0603_1608Metric | Niepotwierdzony | DigiKey / Mouser, wyszukiwanie po MPN |  |  |  |  | 1 |  |  | MPN kandydacki. Dostępność, cena i cykl życia niepotwierdzone. | Element równoważny po sprawdzeniu wartości, obudowy, temperatury i parametrów impulsowych | SMT do potwierdzenia w JLCPCB po importowaniu BOM.
Zasilacz 75 × 40 mm | R18 | Domyślne wyłączenie SHDN | 10k | Panasonic | ERJ-3EKF1002V | Resistor_SMD:R_0603_1608Metric | Niepotwierdzony | DigiKey / Mouser, wyszukiwanie po MPN |  |  |  |  | 1 |  |  | MPN kandydacki. Dostępność, cena i cykl życia niepotwierdzone. | Element równoważny po sprawdzeniu wartości, obudowy, temperatury i parametrów impulsowych | SMT do potwierdzenia w JLCPCB po importowaniu BOM.
Zasilacz 75 × 40 mm | R19 | Rozładowanie dostępnej anody | 10k | Panasonic | ERJ-6ENF1002V | Resistor_SMD:R_0805_2012Metric | Niepotwierdzony | DigiKey / Mouser, wyszukiwanie po MPN |  |  |  |  | 1 |  |  | MPN kandydacki. Dostępność, cena i cykl życia niepotwierdzone. | Element równoważny po sprawdzeniu wartości, obudowy, temperatury i parametrów impulsowych | SMT do potwierdzenia w JLCPCB po importowaniu BOM.
Zasilacz 75 × 40 mm | C13 | Odprzęganie wyjścia eFuse | 100n / 50V | Murata | GRM21BR71H104KA01L | Capacitor_SMD:C_0805_2012Metric | JLCPCB i LCSC C77082 | LCSC / DigiKey |  |  |  |  | 1 |  |  | Karta JLCPCB Extended, montaż SMT Economy/Standard. Zapas i ceny JLC po wycenie. | Samsung CL21B104KBCNNNC, LCSC C1711, potwierdzić DC bias | SMT do potwierdzenia w JLCPCB po importowaniu BOM. | https://jlcpcb.com/partdetail/MurataElectronics-GRM21BR71H104KA01L/C77082
Zasilacz 75 × 40 mm | J2 | Wiązka dwóch blokad i termostatu | S1+TH / S2 | JST | B4B-XH-A(LF)(SN) | Connector_JST:JST_XH_B4B-XH-A_1x04_P2.50mm_Vertical | Niepotwierdzony | DigiKey / Mouser, wyszukiwanie po MPN |  |  |  |  | 1 |  |  | MPN kandydacki. Dostępność, cena i cykl życia niepotwierdzone. | Element równoważny po sprawdzeniu wartości, obudowy, temperatury i parametrów impulsowych | THT / wiązka. Uzgodnić oddzielny montaż.
Zasilacz 75 × 40 mm | J3 | Wiązka do trzech sprężynujących styków | A+ / KA / KB | JST | B3B-XH-A(LF)(SN) | Connector_JST:JST_XH_B3B-XH-A_1x03_P2.50mm_Vertical | Niepotwierdzony | DigiKey / Mouser, wyszukiwanie po MPN |  |  |  |  | 1 |  |  | MPN kandydacki. Dostępność, cena i cykl życia niepotwierdzone. | Element równoważny po sprawdzeniu wartości, obudowy, temperatury i parametrów impulsowych | THT / wiązka. Uzgodnić oddzielny montaż.
Zasilacz 75 × 40 mm | U3 | Niezależny prąd szeregu LED | AL5812MP-13 | Diodes Inc. | AL5812MP-13 | E27:E27_Al5812_MSOP | Niepotwierdzony | DigiKey | 0.76 | 1 | 0.34656 | 2500 | 1 | 0.76 | 0.34656 | Karta dystrybutora. Zapas w dniu zakupu do potwierdzenia. | AL5812FF-7, wymaga innego footprintu | SMT do potwierdzenia w JLCPCB po importowaniu BOM. | https://www.digikey.com/en/products/detail/diodes-incorporated/AL5812MP-13/3678196
Zasilacz 75 × 40 mm | R20 | Prąd typ. 127 mA | 5.90k 1% | Panasonic | ERJ-3EKF5901V | Resistor_SMD:R_0603_1608Metric | Niepotwierdzony | DigiKey / Mouser, wyszukiwanie po MPN |  |  |  |  | 1 |  |  | MPN kandydacki. Dostępność, cena i cykl życia niepotwierdzone. | Element równoważny po sprawdzeniu wartości, obudowy, temperatury i parametrów impulsowych | SMT do potwierdzenia w JLCPCB po importowaniu BOM.
Zasilacz 75 × 40 mm | C14 | Odprzęganie lokalnego źródła prądu | 100n / 50V | Murata | GRM21BR71H104KA01L | Capacitor_SMD:C_0805_2012Metric | JLCPCB i LCSC C77082 | LCSC / DigiKey |  |  |  |  | 1 |  |  | Karta JLCPCB Extended, montaż SMT Economy/Standard. Zapas i ceny JLC po wycenie. | Samsung CL21B104KBCNNNC, LCSC C1711, potwierdzić DC bias | SMT do potwierdzenia w JLCPCB po importowaniu BOM. | https://jlcpcb.com/partdetail/MurataElectronics-GRM21BR71H104KA01L/C77082
Zasilacz 75 × 40 mm | U4 | Niezależny prąd szeregu LED | AL5812MP-13 | Diodes Inc. | AL5812MP-13 | E27:E27_Al5812_MSOP | Niepotwierdzony | DigiKey | 0.76 | 1 | 0.34656 | 2500 | 1 | 0.76 | 0.34656 | Karta dystrybutora. Zapas w dniu zakupu do potwierdzenia. | AL5812FF-7, wymaga innego footprintu | SMT do potwierdzenia w JLCPCB po importowaniu BOM. | https://www.digikey.com/en/products/detail/diodes-incorporated/AL5812MP-13/3678196
Zasilacz 75 × 40 mm | R21 | Prąd typ. 127 mA | 5.90k 1% | Panasonic | ERJ-3EKF5901V | Resistor_SMD:R_0603_1608Metric | Niepotwierdzony | DigiKey / Mouser, wyszukiwanie po MPN |  |  |  |  | 1 |  |  | MPN kandydacki. Dostępność, cena i cykl życia niepotwierdzone. | Element równoważny po sprawdzeniu wartości, obudowy, temperatury i parametrów impulsowych | SMT do potwierdzenia w JLCPCB po importowaniu BOM.
Zasilacz 75 × 40 mm | C15 | Odprzęganie lokalnego źródła prądu | 100n / 50V | Murata | GRM21BR71H104KA01L | Capacitor_SMD:C_0805_2012Metric | JLCPCB i LCSC C77082 | LCSC / DigiKey |  |  |  |  | 1 |  |  | Karta JLCPCB Extended, montaż SMT Economy/Standard. Zapas i ceny JLC po wycenie. | Samsung CL21B104KBCNNNC, LCSC C1711, potwierdzić DC bias | SMT do potwierdzenia w JLCPCB po importowaniu BOM. | https://jlcpcb.com/partdetail/MurataElectronics-GRM21BR71H104KA01L/C77082
Wkład 2700 K | D1 D2 D3 D4 D5 D6 D7 D8 D9 D10 D11 D12 D13 D14 D15 D16 | LED biała 3 V N Class | 2700 K / CRI ≥80 / 2,86 V typ. @150 mA / 11 K/W | Cree LED | JE2835BWT-N-H27EA0000-N0000001 | E27:Cree_JE2835B | Niepotwierdzony | DigiKey | 0.1 | 1 | 0.03959 | 4000 | 16 | 1.6 | 0.63344 | Katalog aktywny, widoczne 18 638 | L128-2780CA3500001 po rekwalifikacji | SMT, polaryzacja katoda na większym padzie 1. Kupić zakwalifikowany bin. Consignment po akceptacji JLCPCB. | https://www.digikey.com/en/products/detail/cree-led/JE2835BWT-N-H27EA0000-N0000001/21727032
Wkład 4000 K | D1 D2 D3 D4 D5 D6 D7 D8 D9 D10 D11 D12 D13 D14 D15 D16 | LED biała 3 V N Class | 4000 K / CRI ≥80 / 2,86 V typ. @150 mA / 11 K/W | Cree LED | JE2835BWT-N-H40EA0000-N0000001 | E27:Cree_JE2835B | Niepotwierdzony | DigiKey | 0.1 | 1 | 0.03959 | 4000 | 16 | 1.6 | 0.63344 | Katalog aktywny, widoczne 14 615 | L128-4080CA3500001 po rekwalifikacji | SMT, polaryzacja katoda na większym padzie 1. Kupić zakwalifikowany bin. Consignment po akceptacji JLCPCB. | https://www.digikey.com/es/products/detail/cree-led/JE2835BWT-N-H40EA0000-N0000001/16182099
Wkład 6500 K | D1 D2 D3 D4 D5 D6 D7 D8 D9 D10 D11 D12 D13 D14 D15 D16 | LED biała 3 V N Class | 6500 K / CRI ≥80 / 2,86 V typ. @150 mA / 11 K/W | Cree LED | JE2835BWT-N-H65EA0000-N0000001 | E27:Cree_JE2835B | Niepotwierdzony | DigiKey | 0.1 | 1 | 0.03959 | 4000 | 16 | 1.6 | 0.63344 | Katalog aktywny, widoczne 55 949 | L128-6580CA35000T1 po rekwalifikacji | SMT, polaryzacja katoda na większym padzie 1. Kupić zakwalifikowany bin. Consignment po akceptacji JLCPCB. | https://www.digikey.com/en/products/detail/cree-led/JE2835BWT-N-H65EA0000-N0000001/16182111
Wkład | PCB1 | Aluminiowa MCPCB | Ø30 mm ze ścięciem, 1,6 mm, F.Cu 35 µm |  |  |  |  | JLCPCB / dostawca IMS |  |  |  |  | 1 |  |  | Do uzgodnienia |  | Montaż poza SMT. HASL do prób. Produkcyjne powierzchnie styku z powłoką odporną na zużycie.
Wkład | J1 J2 J3 | Pola kontaktowe | 2,4 × 1,6 mm bez pasty |  |  |  |  | W ramach PCB1 |  |  |  |  | 3 |  |  | Do uzgodnienia |  | Montaż poza SMT. Wycenić wykończenie w ramach PCB, brak elementów do PnP.
Wkład | M1 | Obrzeże z uchwytami | Izolacyjne, odporne cieplnie |  |  |  |  | RFQ mechanika |  |  |  |  | 1 |  |  | Do uzgodnienia |  | Montaż poza SMT. Zatrzask stały względem wkładu.
Wkład | M2 | Sucha przekładka TIM | 0,20–0,30 mm, ≥3 W/mK |  |  |  |  | RFQ TIM |  |  |  |  | 1 |  |  | Do uzgodnienia |  | Montaż poza SMT. Zamocowana fabrycznie, sprężysty powtarzalny docisk.
Korpus | M3 | Radiator | Al 48–54 mm, żebra ~30 mm |  |  |  |  | RFQ radiator |  |  |  |  | 1 |  |  | Do uzgodnienia |  | Montaż poza SMT. Sprawdzić dostęp palcem i powtarzalny docisk.
Korpus | M4 | Głowica styków | 3 × styk sprężynowy |  |  |  |  | RFQ styki |  |  |  |  | 3 |  |  | Do uzgodnienia |  | Montaż poza SMT. Wymagany pomiar siły, rezystancji i trwałości.
Korpus | M5 | Klosz opalowy | Cel transmisji 0,87, A60 |  |  |  |  | RFQ dyfuzor |  |  |  |  | 1 |  |  | Do uzgodnienia |  | Montaż poza SMT. Wymagana fotometria kompletnego zespołu.
Korpus | M6 | Stała przegroda, bagnet, przesłona | Tworzywo izolacyjne termiczne |  |  |  |  | RFQ mechanika |  |  |  |  | 1 |  |  | Do uzgodnienia |  | Montaż poza SMT. Wymagane badania dostępu, pozycjonowania i odporności na temperaturę.
Korpus | S1 | Mikroprzełącznik NO sygnału | Pozłacany, mały prąd |  |  |  |  | RFQ przełącznik |  |  |  |  | 1 |  |  | Do uzgodnienia |  | Montaż poza SMT. Oddzielna krzywka.
Korpus | S2 | Mikroprzełącznik NO zasilania | ≥30 V DC, zweryfikowany udar |  |  |  |  | RFQ przełącznik |  |  |  |  | 1 |  |  | Do uzgodnienia |  | Montaż poza SMT. Oddzielna krzywka. Otwieranie pod obciążeniem w pojedynczej awarii.
Korpus | TH1 | Termostat NC | Początkowo 85–90 °C do prób |  |  |  |  | RFQ termostat |  |  |  |  | 1 |  |  | Do uzgodnienia |  | Montaż poza SMT. Temperaturę doboru ustalić pomiarem.
Korpus | J4 | Cokół E27 i przewody | Kwalifikowany zespół, zaciskany |  |  |  |  | RFQ trzonek |  |  |  |  | 1 |  |  | Do uzgodnienia |  | Montaż poza SMT. Mechanika IEC 60061, izolacja i odciążenie.
Korpus | W1 | Wiązka J2 | Gniazdo XH 4p, terminale i przewody |  |  |  |  | JST / wykonawca wiązki |  |  |  |  | 1 |  |  | Do uzgodnienia |  | Montaż poza SMT. S1 + TH1 i S2 według schematu.
Korpus | W2 | Wiązka J3 | Gniazdo XH 3p, terminale i przewody |  |  |  |  | JST / wykonawca wiązki |  |  |  |  | 1 |  |  | Do uzgodnienia |  | Montaż poza SMT. A+, KA, KB.
