kamelele/Velluneo-2.0/hardware/E27/outputs/Zasilacz_RevK_Moc/BOM_RevK.csv

Ref | Wartość | MPN | Footprint | LCSC Part # | Źródło
J1 | 230 VAC |  | E27:Mains_L_N
F1 | T 500 mA / 277 VAC | 3403.0271.23 | E27:Schurter_UMT_H |  | https://www.digikey.com/en/products/detail/schurter-inc/3403-0271-23/9094779
RV1 | 275 VAC | TMOV14RP275E | E27:TMOV14 | C1528070 | https://jlcpcb.com/partdetail/Littelfuse-TMOV14RP275E/C1528070
R1 | 22R / 1.1W fusible | AC01000902209JBMCS | E27:AC01_CS_WSZ |  | https://www.digikey.com/en/products/detail/vishay-beyschlag-draloric-bc-components/AC01000902209JBMCS/28721869
C1 | 100n / 630V | C3225X7T2J104KT000N | Capacitor_SMD:C_1210_3225Metric | C342668 | https://www.lcsc.com/product-detail/C342668.html
L1 | 1mH | 768772102 | E27:Wurth_TI_HV_8 | C7194056 | https://jlcpcb.com/partdetail/WurthElektronik-768772102/C7194056
C2 | 10u / 450V | 450BXW10MEFR10X16 | Capacitor_THT:CP_Radial_D10.0mm_P5.00mm | C473172 | JLCPCB/LCSC, dokładny MPN
R2 | 510k HV | CRCW2010510KFKEF | Resistor_SMD:R_2010_5025Metric | C4245382 | https://www.lcsc.com/product-detail/C4245382.html
R3 | 510k HV | CRCW2010510KFKEF | Resistor_SMD:R_2010_5025Metric | C4245382 | https://www.lcsc.com/product-detail/C4245382.html
T1 | EE16 84:23:13 |  | E27:EE16_6pins_RFQ
C3 | 2.2n / 630V | C3216C0G2J222JT000N | Capacitor_SMD:C_1206_3216Metric | C342846 | JLCPCB/LCSC, dokładny MPN
R4 | 82k / 0.5W | SR1206JR-7W82KL | Resistor_SMD:R_1206_3216Metric | C7319643 | JLCPCB/LCSC, dokładny MPN
D5 | US1M | US1M-13-F | Diode_SMD:D_SMA | C99333 | JLCPCB/LCSC, dokładny MPN
D6 | DFLU1200 | DFLU1200-7 | Diode_SMD:D_PowerDI-123 | C154734 | JLCPCB/LCSC, dokładny MPN
C4 | 22u / 35V | C3216X5R1V226M160AC | Capacitor_SMD:C_1206_3216Metric | C69612 | https://www.lcsc.com/product-detail/C69612.html
R5 | 10k | ERJ-6ENF1002V | Resistor_SMD:R_0805_2012Metric | C169253 | https://www.lcsc.com/product-detail/C169253.html
R6 | 2.2M HV | CRCW20102M20FKEF | Resistor_SMD:R_2010_5025Metric | C4263855 | https://www.lcsc.com/product-detail/C4263855.html
R7 | 2.2M HV | CRCW20102M20FKEF | Resistor_SMD:R_2010_5025Metric | C4263855 | https://www.lcsc.com/product-detail/C4263855.html
C5 | 470n / 50V | GRM21BR71H474KA88L | Capacitor_SMD:C_0805_2012Metric | C86043 | https://www.lcsc.com/product-detail/C86043.html
U1 | LYT6073C-TL | LYT6073C-TL | E27:InSOP_24D | C567768 | https://www.lcsc.com/product-detail/C567768.html
CY1 | 2.2n Y1 | 440LD22-R | E27:CY1_10mm | C511032 | https://www.lcsc.com/product-detail/C511032.html
D7 | SK3200B | SK3200B-LTP | Diode_SMD:D_SMB | C138792 | https://www.lcsc.com/product-detail/C138792.html
C6 | 470u / 50V | UCM1H471MNJ1MS | E27:UCM_12p5 | C3828881 | https://www.lcsc.com/product-detail/C3828881.html
R8 | 47R | RC0805FR-0747RL | Resistor_SMD:R_0805_2012Metric | C114541 | JLCPCB/LCSC, dokładny MPN
C7 | 68p / 250V | GQM1875C2E680GB12D | Capacitor_SMD:C_0603_1608Metric | C2179181 | JLCPCB/LCSC, dokładny MPN
R9 | 0.11R | ERJ-6DSFR11V | Resistor_SMD:R_0805_2012Metric | C4000855 | JLCPCB/LCSC, dokładny MPN
D8 | US1B | US1B-13-F | Diode_SMD:D_SMA | C154439 | https://www.lcsc.com/product-detail/C154439.html
R10 | 110k 0.1% | ERA-3AEB114V | Resistor_SMD:R_0603_1608Metric | C473255 | https://jlcpcb.com/partdetail/PANASONIC-ERA3AEB114V/C473255
R11 | 5.62k 0.1% | RP0603BRD075K62L | Resistor_SMD:R_0603_1608Metric | C5889719 | https://www.lcsc.com/product-detail/C5889719.html
C8 | 330p | CC0603KRX7R9BB331 | Capacitor_SMD:C_0603_1608Metric | C107087 | https://www.lcsc.com/product-detail/C107087.html
C9 | 2.2u / 25V | C3216X7R1E225K160AE | Capacitor_SMD:C_1206_3216Metric | C508852 | JLCPCB/LCSC, dokładny MPN
R12 | 2.2k | RC0805FR-072K2L | Resistor_SMD:R_0805_2012Metric | C114561 | https://jlcpcb.com/partdetail/YAGEO-RC0805FR072K2L/C114561
ZD1 | 18V | BZT52C18-7-F | Diode_SMD:D_SOD-123 | C192739 | https://www.lcsc.com/product-detail/C192739.html
Q1 | MMBT5551 | MMBT5551LT1G | Package_TO_SOT_SMD:SOT-23 | C41095 | https://www.lcsc.com/product-detail/C41095.html
C10 | 100n / 50V | GRM21BR71H104KA01L | Capacitor_SMD:C_0805_2012Metric | C77082 | https://jlcpcb.com/partdetail/MurataElectronics-GRM21BR71H104KA01L/C77082
ZD2 | 27V | BZT52C27-7-F | Diode_SMD:D_SOD-123 | C163720 | https://www.lcsc.com/product-detail/C163720.html
R13 | 100R | ERJ-6ENF1000V | Resistor_SMD:R_0805_2012Metric | C193990 | https://jlcpcb.com/partdetail/PANASONIC-ERJ6ENF1000V/C193990
D9 | BAV21W | BAV21W-7-F | Diode_SMD:D_SOD-123 | C155214 | https://www.lcsc.com/product-detail/C155214.html
BR1 | ABS10M-13 | ABS10M-13 | E27:ABS10M_SOPA-4_WX | C7507234 | JLCPCB/LCSC, dokładny MPN
J101 | 26 V / RTN |  | E27:Harness_26V_RTN
R22 | 82k / 0.5W | SR1206JR-7W82KL | Resistor_SMD:R_1206_3216Metric | C7319643 | JLCPCB/LCSC, dokładny MPN
C16 | C_RC (DNP) |  | E27:C_RC_1206_Hand
R23 | R_RC (DNP) |  | E27:R_RC_0805_Hand
