kamelele/Velluneo-2.0/hardware/E27/outputs/Zasilacz_RevH_Sterowanie/BOM_RevH.csv

Ref | Wartość | MPN | Footprint | LCSC Part # | Źródło
U2 | TPS26600PWPR | TPS26600PWPR | E27:PWP0016A | C544399 | https://jlcpcb.com/partdetail/TexasInstruments-TPS26600PWPR/C544399
C11 | 100n / 50V | GRM21BR71H104KA01L | Capacitor_SMD:C_0805_2012Metric | C77082 | https://jlcpcb.com/partdetail/MurataElectronics-GRM21BR71H104KA01L/C77082
R14 | 226k 0.1% | ERA-3AEB2263V | Resistor_SMD:R_0603_1608Metric | C2075582 | https://www.lcsc.com/product-detail/C2075582.html
R15 | 10k 0.1% | ERA-3AEB103V | Resistor_SMD:R_0603_1608Metric | C190610 | https://jlcpcb.com/partdetail/PANASONIC-ERA3AEB103V/C190610
R16 | 30.1k 1% | ERJ-3EKF3012V | Resistor_SMD:R_0603_1608Metric | C403145 | https://www.lcsc.com/product-detail/C403145.html
C12 | 47n | CC0603KRX7R9BB473 | Capacitor_SMD:C_0603_1608Metric | C107093 | https://www.lcsc.com/product-detail/C107093.html
R17 | 10k | ERJ-3EKF1002V | Resistor_SMD:R_0603_1608Metric | C191124 | https://www.lcsc.com/product-detail/C191124.html
R18 | 10k | ERJ-3EKF1002V | Resistor_SMD:R_0603_1608Metric | C191124 | https://www.lcsc.com/product-detail/C191124.html
R19 | 10k | ERJ-6ENF1002V | Resistor_SMD:R_0805_2012Metric | C169253 | https://www.lcsc.com/product-detail/C169253.html
C13 | 100n / 50V | GRM21BR71H104KA01L | Capacitor_SMD:C_0805_2012Metric | C77082 | https://jlcpcb.com/partdetail/MurataElectronics-GRM21BR71H104KA01L/C77082
J2 | S1+TH / S2 |  | E27:Harness_4pos
J3 | A+ / KA / KB |  | E27:Harness_3pos
U3 | AL5812MP-13 | AL5812MP-13 | E27:E27_Al5812_MSOP | C460648 | https://www.lcsc.com/product-detail/C460648.html
R20 | 5.90k 1% | ERJ-3EKF5901V | Resistor_SMD:R_0603_1608Metric | C403290 | https://www.lcsc.com/product-detail/C403290.html
C14 | 100n / 50V | GRM21BR71H104KA01L | Capacitor_SMD:C_0805_2012Metric | C77082 | https://jlcpcb.com/partdetail/MurataElectronics-GRM21BR71H104KA01L/C77082
U4 | AL5812MP-13 | AL5812MP-13 | E27:E27_Al5812_MSOP | C460648 | https://www.lcsc.com/product-detail/C460648.html
R21 | 5.90k 1% | ERJ-3EKF5901V | Resistor_SMD:R_0603_1608Metric | C403290 | https://www.lcsc.com/product-detail/C403290.html
C15 | 100n / 50V | GRM21BR71H104KA01L | Capacitor_SMD:C_0805_2012Metric | C77082 | https://jlcpcb.com/partdetail/MurataElectronics-GRM21BR71H104KA01L/C77082
J102 | 26 V / RTN |  | E27:Harness_26V_RTN
U101 | TPS7A1633 | TPS7A1633DGNR | E27:TPS7A16_DGN | C181239 | https://www.lcsc.com/product-detail/C181239.html
U102 | TLV1702 | TLV1702AIDGKR | Package_SO:MSOP-8_3x3mm_P0.65mm | C2870937 | https://jlcpcb.com/partdetail/TexasInstruments-TLV1702AIDGKR/C2870937
U103 | 74LVC132A | 74LVC132APW,118 | Package_SO:TSSOP-14_4.4x5mm_P0.65mm | C548102 | https://jlcpcb.com/partdetail/Nexperia-74LVC132APW118/C548102
D102 | PMEG6010CEH | PMEG6010CEH-QX | Diode_SMD:D_SOD-123F | C5311567 | https://www.lcsc.com/product-detail/C5311567.html
D103 | PMEG6010CEH | PMEG6010CEH-QX | Diode_SMD:D_SOD-123F | C5311567 | https://www.lcsc.com/product-detail/C5311567.html
R101 | 22k | ERJ-3EKF2202V | Resistor_SMD:R_0603_1608Metric | C278611 | https://www.lcsc.com/product-detail/C278611.html
R102 | 2.2k | ERJ-3EKF2201V | Resistor_SMD:R_0603_1608Metric | C116387 | https://jlcpcb.com/partdetail/PANASONIC-ERJ3EKF2201V/C116387
R103 | 133k 0.1% | ERA-3AEB1333V | Resistor_SMD:R_0603_1608Metric | C2087399 | https://www.lcsc.com/product-detail/C2087399.html
R104 | 22k 0.1% | ERA-3AEB223V | Resistor_SMD:R_0603_1608Metric | C445636 | https://www.lcsc.com/product-detail/C445636.html
R105 | 330k 0.1% | RT0603BRD07330KL | Resistor_SMD:R_0603_1608Metric | C861327 | https://www.lcsc.com/product-detail/C861327.html
R106 | 22k 0.1% | ERA-3AEB223V | Resistor_SMD:R_0603_1608Metric | C445636 | https://www.lcsc.com/product-detail/C445636.html
R107 | 330k 0.1% | RT0603BRD07330KL | Resistor_SMD:R_0603_1608Metric | C861327 | https://www.lcsc.com/product-detail/C861327.html
R108 | 22k 0.1% | ERA-3AEB223V | Resistor_SMD:R_0603_1608Metric | C445636 | https://www.lcsc.com/product-detail/C445636.html
R109 | 22k | ERJ-3EKF2202V | Resistor_SMD:R_0603_1608Metric | C278611 | https://www.lcsc.com/product-detail/C278611.html
R110 | 10k 1% | ERJ-3EKF1002V | Resistor_SMD:R_0603_1608Metric | C191124 | https://www.lcsc.com/product-detail/C191124.html
R111 | 100k 1% | ERJ-3EKF1003V | Resistor_SMD:R_0603_1608Metric | C189597 | https://www.lcsc.com/product-detail/C189597.html
R112 | 100k 1% | ERJ-3EKF1003V | Resistor_SMD:R_0603_1608Metric | C189597 | https://www.lcsc.com/product-detail/C189597.html
C101 | 2.2u / 100V | C3225X7R2A225K230AB | Capacitor_SMD:C_1210_3225Metric | C2167827 | https://www.lcsc.com/product-detail/C2167827.html
C102 | 10u / 25V | GRM21BC71E106KE11L | Capacitor_SMD:C_0805_2012Metric | C109040 | https://www.lcsc.com/product-detail/C109040.html
C103 | 10n | CC0603KRX7R9BB103 | Capacitor_SMD:C_0603_1608Metric | C100042 | https://www.lcsc.com/product-detail/C100042.html
C104 | 220n / 50V X7R 10% | CGA3E3X7R1H224K080AE | Capacitor_SMD:C_0603_1608Metric | C2171795 | https://jlcpcb.com/partdetail/TDK-CGA3E3X7R1H224K080AE/C2171795
C105 | 220n / 50V X7R 10% | CGA3E3X7R1H224K080AE | Capacitor_SMD:C_0603_1608Metric | C2171795 | https://jlcpcb.com/partdetail/TDK-CGA3E3X7R1H224K080AE/C2171795
C106 | 10n | CC0603KRX7R9BB103 | Capacitor_SMD:C_0603_1608Metric | C100042 | https://www.lcsc.com/product-detail/C100042.html
C107 | 100n | C1608X7R1H104K080AE | Capacitor_SMD:C_0603_1608Metric | C2167477 | https://jlcpcb.com/partdetail/TDK-C1608X7R1H104K080AE/C2167477
C108 | 10n | CC0603KRX7R9BB103 | Capacitor_SMD:C_0603_1608Metric | C100042 | https://www.lcsc.com/product-detail/C100042.html
C109 | 100n | C1608X7R1H104K080AE | Capacitor_SMD:C_0603_1608Metric | C2167477 | https://jlcpcb.com/partdetail/TDK-C1608X7R1H104K080AE/C2167477
R113 | 100k 1% | ERJ-3EKF1003V | Resistor_SMD:R_0603_1608Metric | C189597 | https://www.lcsc.com/product-detail/C189597.html
Q101 | MMDT3904 | MMDT3904-7-F | Package_TO_SOT_SMD:SOT-363_SC-70-6 | C83572 | https://www.lcsc.com/product-detail/C83572.html
Q102 | 2N7002BK | 2N7002BK,215 | Package_TO_SOT_SMD:SOT-23 | C282405 | https://www.lcsc.com/product-detail/C282405.html
