kamelele/Velluneo-2.0/hardware/E27/outputs/Zasilacz_RevB2_Ochrona/BOM_RevB2.csv

Ref | Wartość | MPN | Footprint
J1 | Wiazka prob 6p | B6B-XH-A(LF)(SN) | Connector_JST:JST_XH_B6B-XH-A_1x06_P2.50mm_Vertical
U1 | TPS7A1633 | TPS7A1633DGNR | E27:TPS7A16_DGN
U2 | TLV1702 | TLV1702AIDGKR | Package_SO:MSOP-8_3x3mm_P0.65mm
U3 | SN74HCS74 | SN74HCS74PWR | Package_SO:TSSOP-14_4.4x5mm_P0.65mm
U4 | SN74LVC1G132 | SN74LVC1G132DBVR | Package_TO_SOT_SMD:SOT-23-5
U5 | AQY212GS | AQY212GS | E27:AQY212GS_SOP4
D1 | BAT54WS | BAT54WS | Diode_SMD:D_SOD-323
D2 | PMEG6010CEH | PMEG6010CEH,115 | Diode_SMD:D_SOD-123F
D3 | PMEG6010CEH | PMEG6010CEH,115 | Diode_SMD:D_SOD-123F
R1 | 22k |  | Resistor_SMD:R_0603_1608Metric
R2 | 2.2k |  | Resistor_SMD:R_0603_1608Metric
R3 | 133k 0.1% | ERA-3AEB1333V | Resistor_SMD:R_0603_1608Metric
R4 | 22k 0.1% | ERA-3AEB223V | Resistor_SMD:R_0603_1608Metric
R5 | 330k 0.1% | ERA-3AEB3303V | Resistor_SMD:R_0603_1608Metric
R6 | 22k 0.1% | ERA-3AEB223V | Resistor_SMD:R_0603_1608Metric
R7 | 330k 0.1% | ERA-3AEB3303V | Resistor_SMD:R_0603_1608Metric
R8 | 22k 0.1% | ERA-3AEB223V | Resistor_SMD:R_0603_1608Metric
R9 | 22k |  | Resistor_SMD:R_0603_1608Metric
R10 | 100k |  | Resistor_SMD:R_0603_1608Metric
R11 | 249R 1% |  | Resistor_SMD:R_0603_1608Metric
R12 | 100k 1% |  | Resistor_SMD:R_0603_1608Metric
C1 | 2.2u / 100V | C3225X7R2A225K230AB | Capacitor_SMD:C_1210_3225Metric
C2 | 10u / 25V | GRM21BC71E106KE11L | Capacitor_SMD:C_0805_2012Metric
C3 | 10n |  | Capacitor_SMD:C_0603_1608Metric
C4 | 220n / 50V X7R 10% |  | Capacitor_SMD:C_0603_1608Metric
C5 | 220n / 50V X7R 10% |  | Capacitor_SMD:C_0603_1608Metric
C6 | 10n |  | Capacitor_SMD:C_0603_1608Metric
C7 | 100n |  | Capacitor_SMD:C_0603_1608Metric
C8 | 10n |  | Capacitor_SMD:C_0603_1608Metric
C9 | 100n |  | Capacitor_SMD:C_0603_1608Metric
C10 | 100n |  | Capacitor_SMD:C_0603_1608Metric
