kamelele/Velluneo-2.0/(list of files, drawings)

Other design files:
hardware/E27/workflow/8s/schematic-prep-check.json
