kamelele/Velluneo-2.0/hardware/E27/outputs/Zasilacz_8S_D4/Zasilacz_8S_D4.kicad_pcb

## KiCad design hardware/E27/outputs/Zasilacz_8S_D4/Zasilacz_8S_D4.kicad_pcb (2026-11-14)

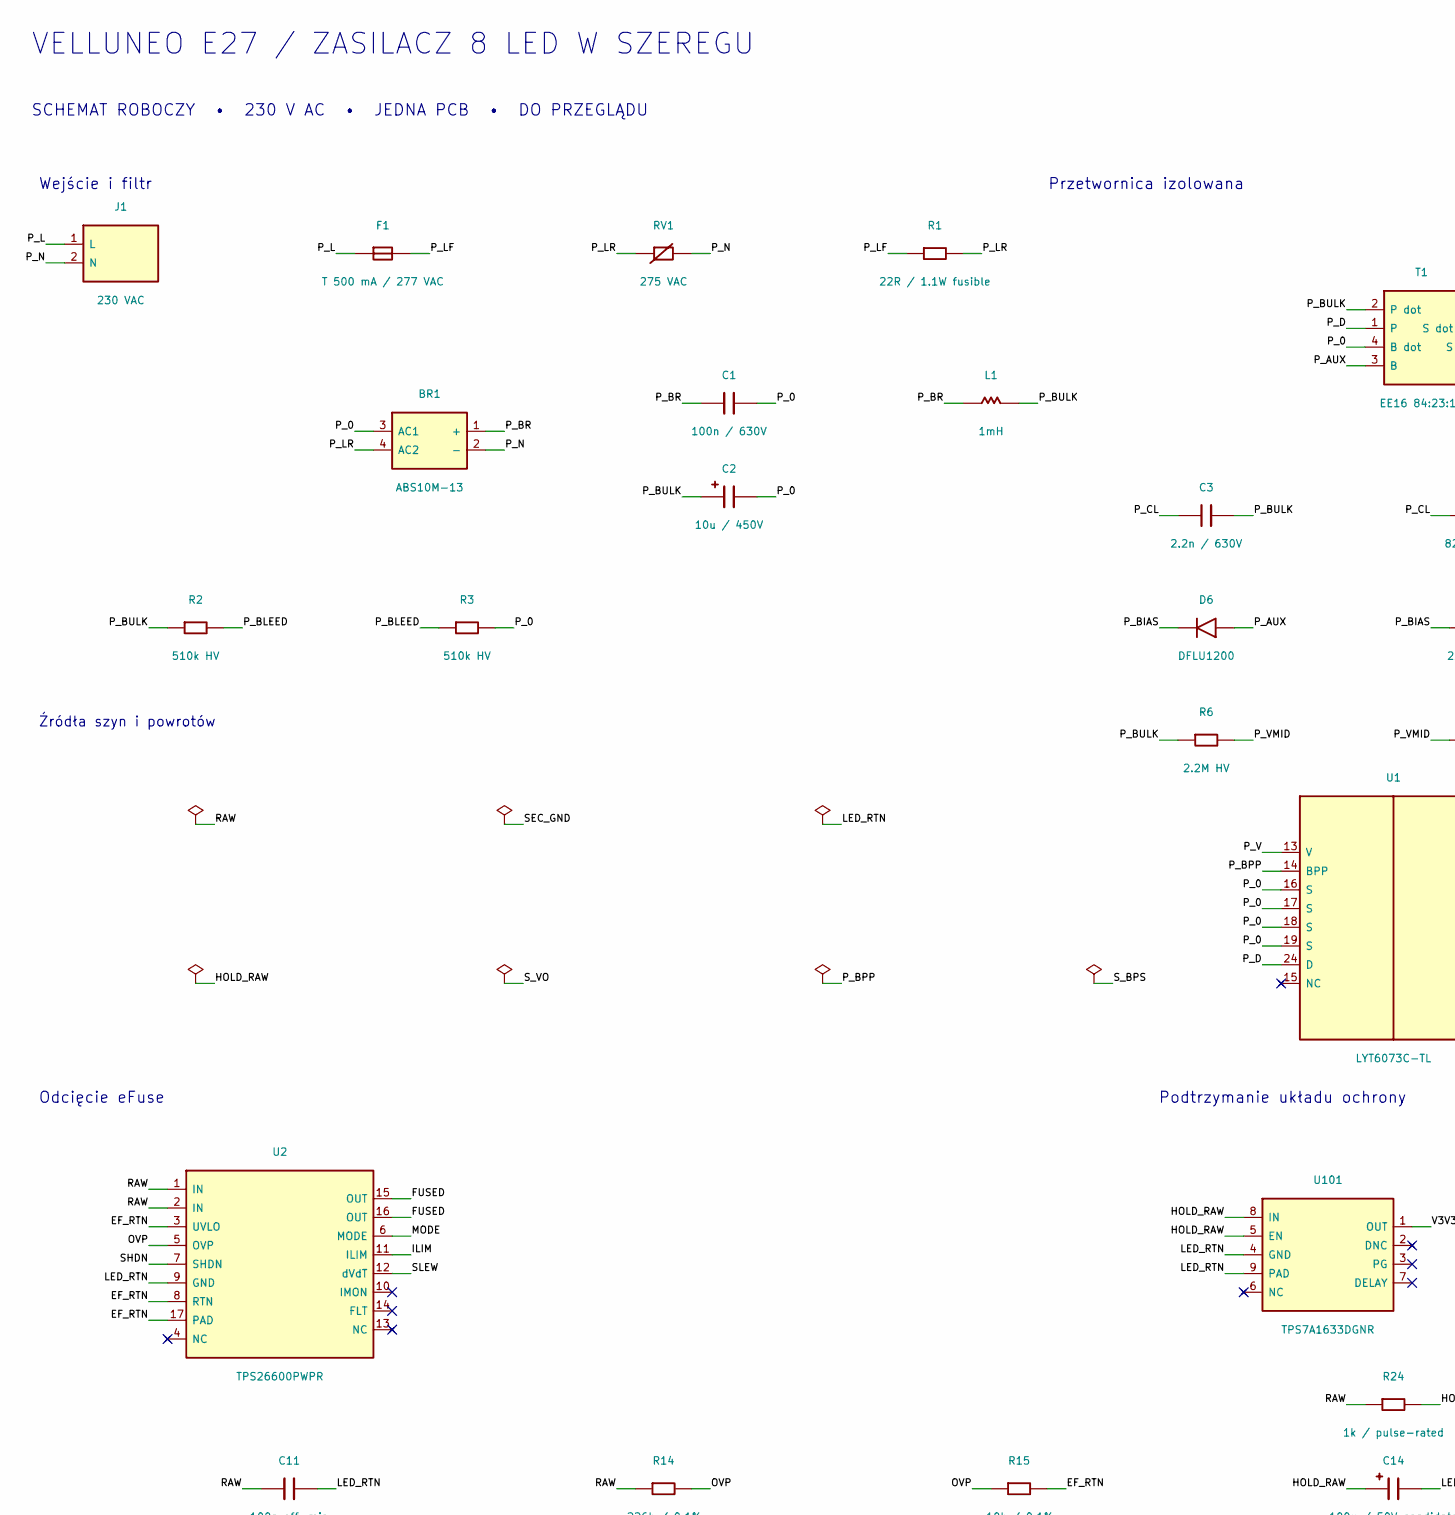
[picture p31: schematic Zasilacz_8S_D4.kicad_sch, Velluneo E27 / 8S / SCHEMATIC DRAFT, part in row 1, column 1]

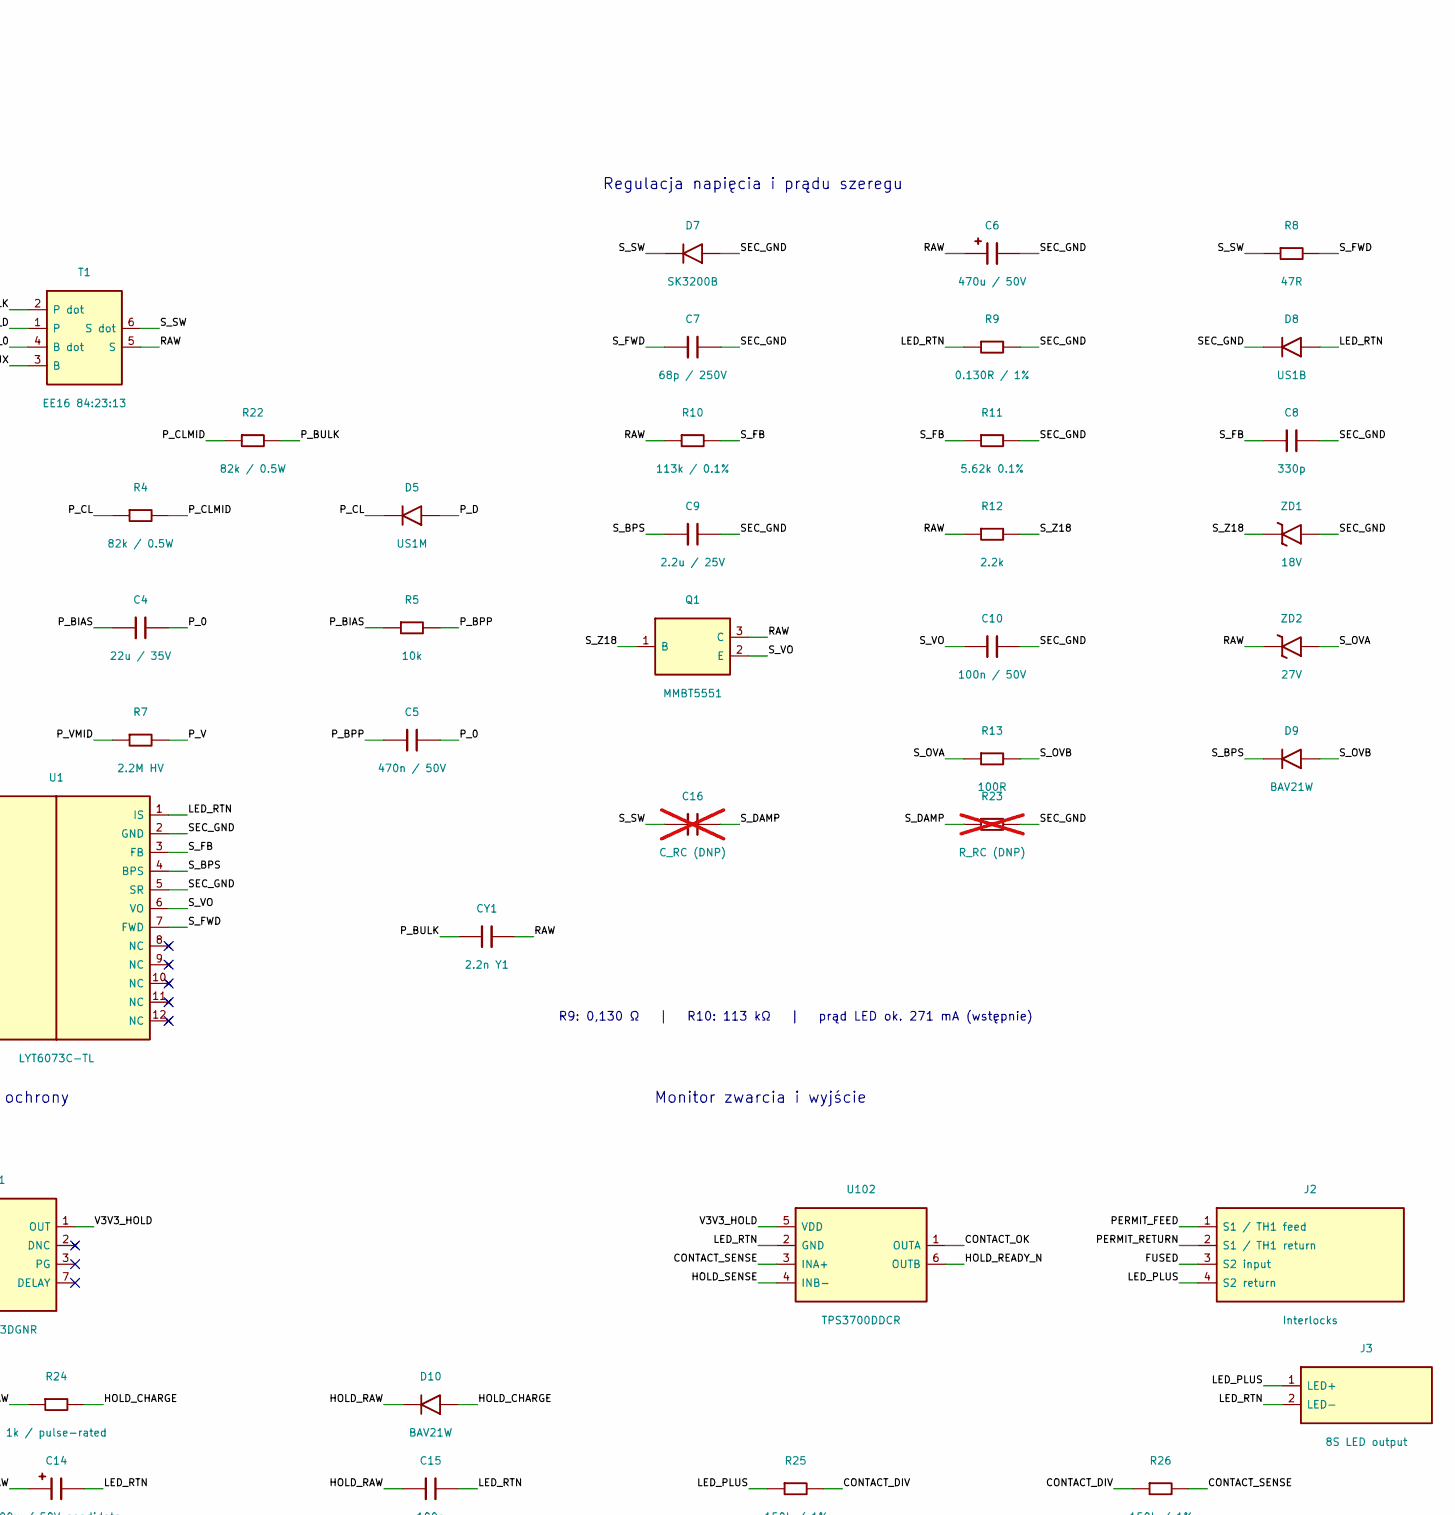
[picture p32: schematic Zasilacz_8S_D4.kicad_sch, Velluneo E27 / 8S / SCHEMATIC DRAFT, part in row 1, column 2]

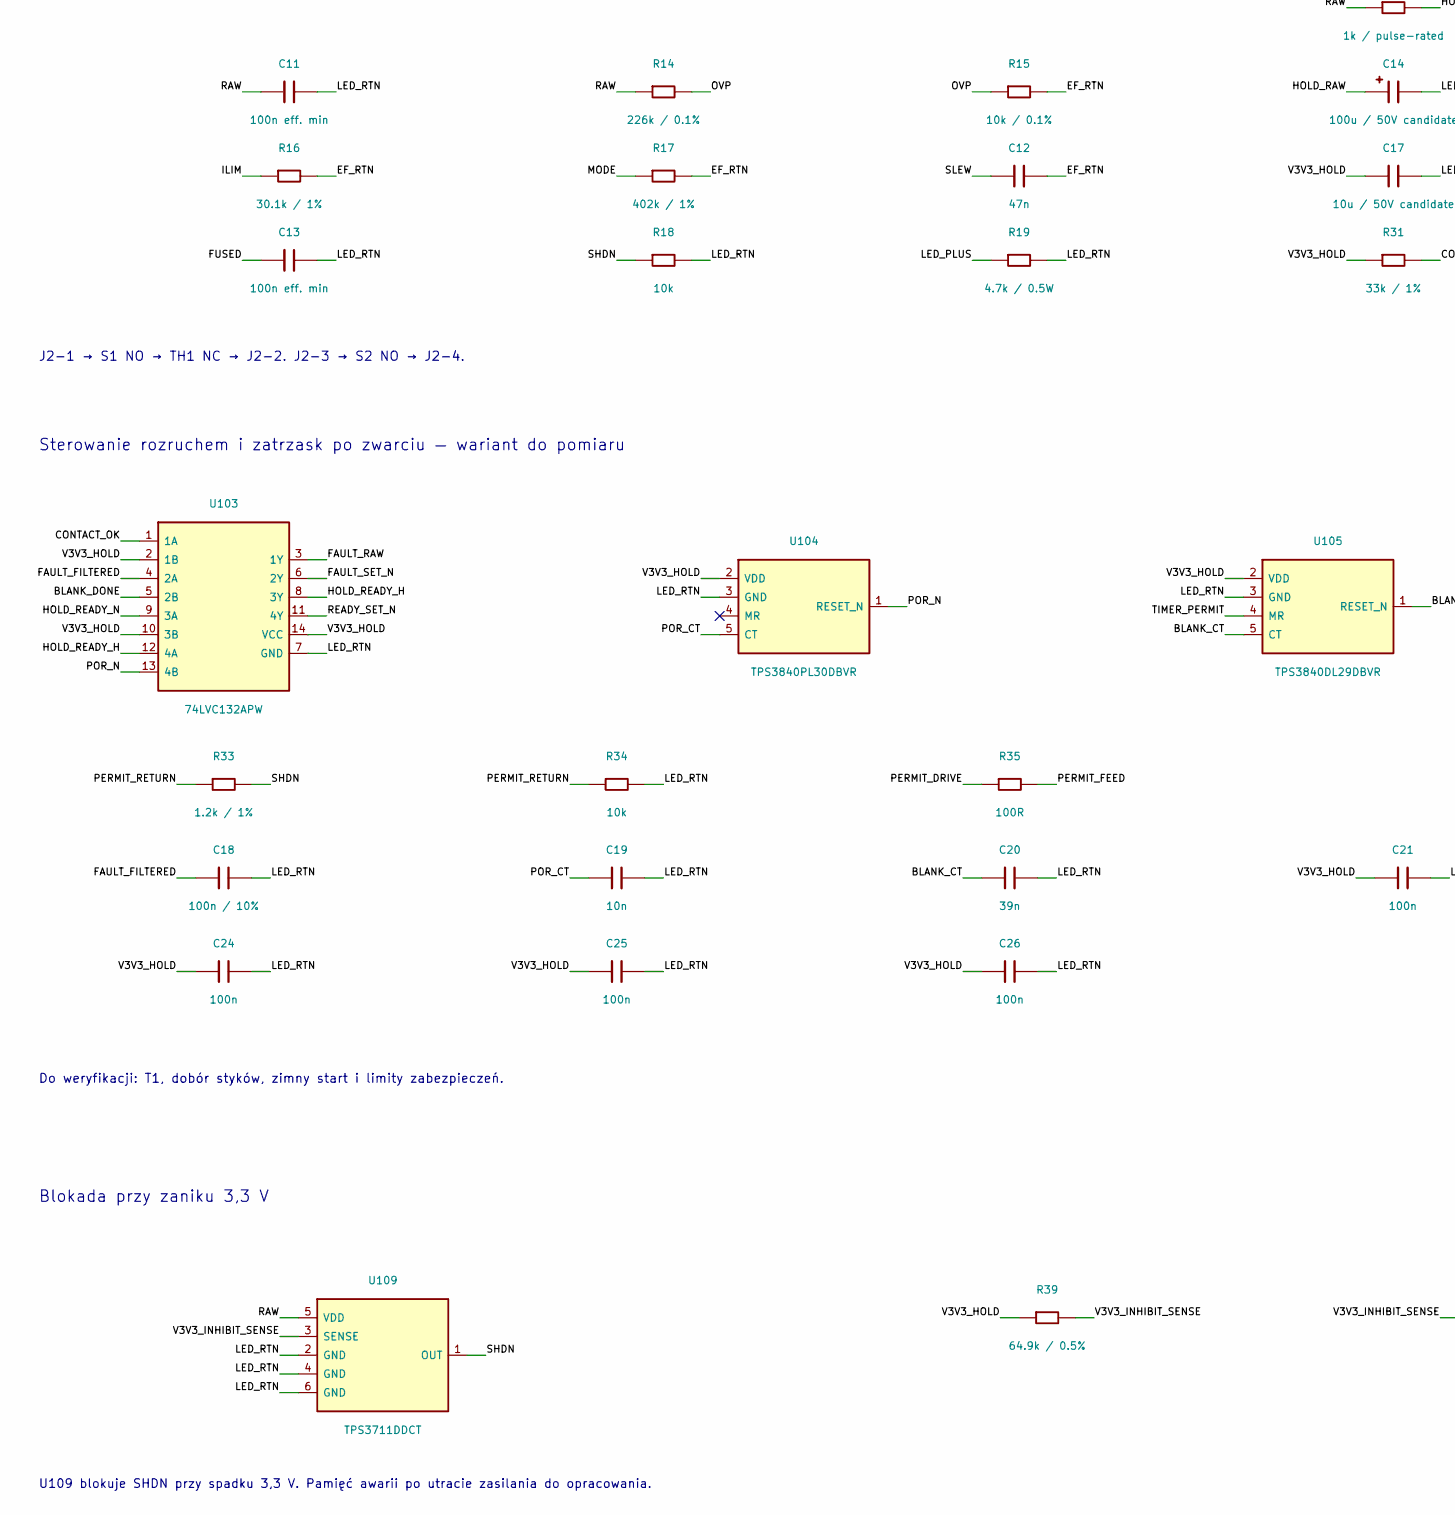
[picture p33: schematic Zasilacz_8S_D4.kicad_sch, Velluneo E27 / 8S / SCHEMATIC DRAFT, part in row 2, column 1]

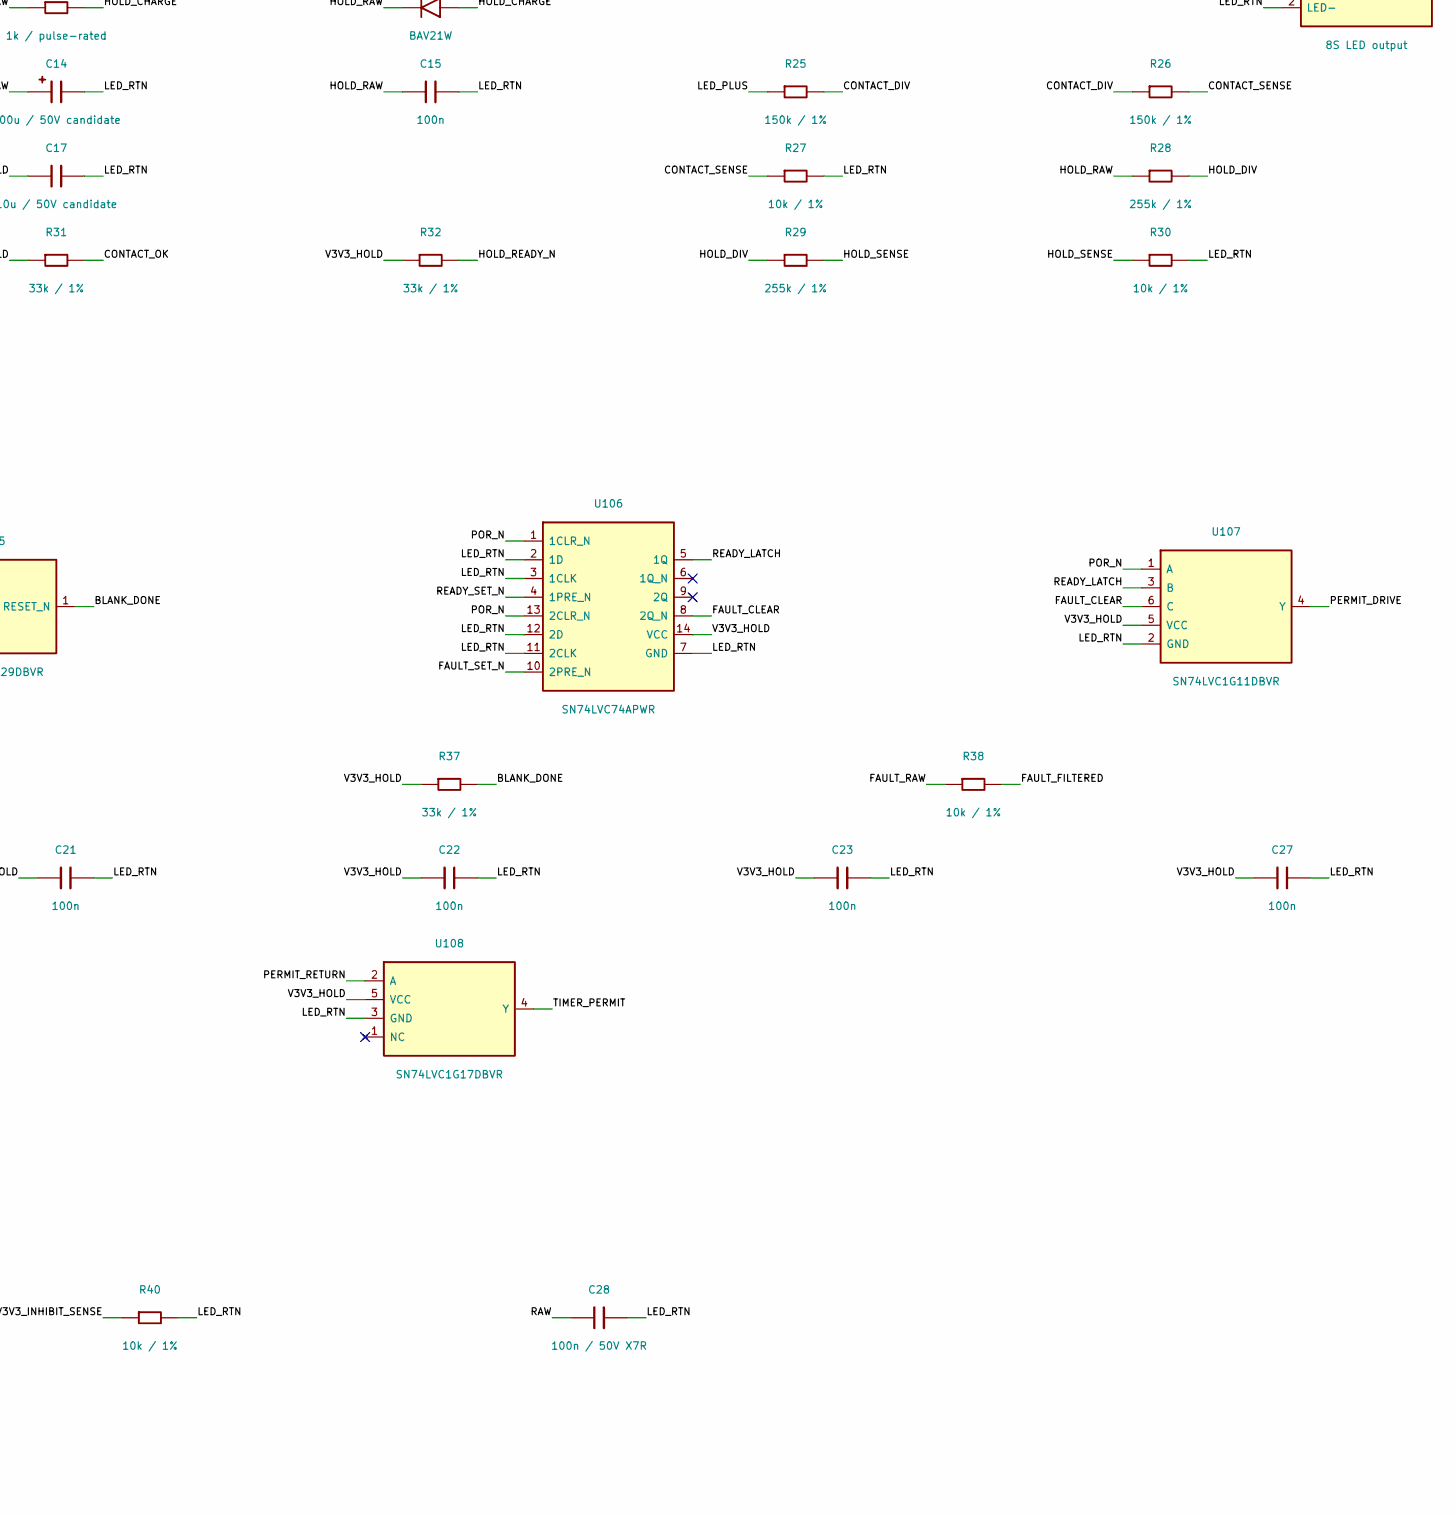
[picture p34: schematic Zasilacz_8S_D4.kicad_sch, Velluneo E27 / 8S / SCHEMATIC DRAFT, part in row 2, column 2]

Parts:
BR1: ABS10M-13; ABS10M_SOPA-4_WX
C1: 100n / 630V; C_1210_3225Metric
C2: 10u / 450V; CP_Radial_D10.0mm_P5.00mm
C3: 2.2n / 630V; C_1206_3216Metric
C4: 22u / 35V; C_1206_3216Metric
C5: 470n / 50V; C_0805_2012Metric
C6: 470u / 50V; UCM_12p5
C7: 68p / 250V; C_0603_1608Metric
C8: 330p; C_0603_1608Metric
C9: 2.2u / 25V; C_1206_3216Metric
C10: 100n / 50V; C_0805_2012Metric
C11, C13: 100n eff. min; C_0805_2012Metric
C12: 47n; C_0603_1608Metric
C14: 100u / 50V candidate; CP_Elec_10x10.5
C15: 100n; C_0805_2012Metric
C16: C_RC (DNP); C_RC_1206_Hand; not fitted
C17: 10u / 50V candidate; C_1210_3225Metric
C18: 100n / 10%; C_0603_1608Metric
C19: 10n; C_0603_1608Metric
C20: 39n; C_0603_1608Metric
C21, C22, C23, C24, C25, C26, C27: 100n; C_0603_1608Metric
C28: 100n / 50V X7R; C_0805_2012Metric
CY1: 2.2n Y1; CY1_10mm
D5: US1M; D_SMA
D6: DFLU1200; D_PowerDI-123
D7: SK3200B; D_SMB
D8: US1B; D_SMA
D9, D10: BAV21W; D_SOD-123
F1: T 500 mA / 277 VAC; Schurter_UMT_H
J1: 230 VAC; Mains_L_N
J2: Interlocks; JST_GH_SM04B-GHS-TB_1x04-1MP_P1.25mm_Horizontal
J3: 8S LED output; JST_GH_SM02B-GHS-TB_1x02-1MP_P1.25mm_Horizontal
L1: 1mH; Wurth_TI_HV_8
Q1: MMBT5551; SOT-23
R1: 22R / 1.1W fusible; AC01_CS_WSZ
R2, R3: 510k HV; R_2010_5025Metric
R4, R22: 82k / 0.5W; R_1206_3216Metric
R5: 10k; R_0805_2012Metric
R6, R7: 2.2M HV; R_2010_5025Metric
R8: 47R; R_0805_2012Metric
R9: 0.130R / 1%; R_1206_3216Metric
R10: 113k / 0.1%; R_0603_1608Metric
R11: 5.62k 0.1%; R_0603_1608Metric
R12: 2.2k; R_0805_2012Metric
R13: 100R; R_0805_2012Metric
R14: 226k / 0.1%; R_0603_1608Metric
R15: 10k / 0.1%; R_0603_1608Metric
R16: 30.1k / 1%; R_0603_1608Metric
R17: 402k / 1%; R_0603_1608Metric
R18, R34: 10k; R_0603_1608Metric
R19: 4.7k / 0.5W; R_1206_3216Metric
R23: R_RC (DNP); R_RC_0805_Hand; not fitted
R24: 1k / pulse-rated; R_1206_3216Metric
R25, R26: 150k / 1%; R_0603_1608Metric
R27, R30, R38, R40: 10k / 1%; R_0603_1608Metric
R28, R29: 255k / 1%; R_0603_1608Metric
R31, R32, R37: 33k / 1%; R_0603_1608Metric
R33: 1.2k / 1%; R_0603_1608Metric
R35: 100R; R_0603_1608Metric
R39: 64.9k / 0.5%; R_0603_1608Metric
RV1: 275 VAC; TMOV14
T1: EE16 84:23:13; EE16_6pins_RFQ
U1: LYT6073C-TL; InSOP_24D
U2: TPS26600PWPR; PWP0016A
U101: TPS7A1633DGNR; TPS7A16_DGN
U102: TPS3700DDCR; SOT-23-6
U103: 74LVC132APW; TSSOP-14_4.4x5mm_P0.65mm
U104: TPS3840PL30DBVR; SOT-23-5
U105: TPS3840DL29DBVR; SOT-23-5
U106: SN74LVC74APWR; TSSOP-14_4.4x5mm_P0.65mm
U107: SN74LVC1G11DBVR; SOT-23-6
U108: SN74LVC1G17DBVR; SOT-23-5
U109: TPS3711DDCT; SOT-23-6
ZD1: 18V; D_SOD-123
ZD2: 27V; D_SOD-123

Connections:
/BLANK_CT: C20.1, U105.5 (CT)
/BLANK_DONE: R37.2, U103.5 (2B), U105.1 (RESET_N)
/CONTACT_DIV: R25.2, R26.1
/CONTACT_OK: R31.2, U102.1 (OUTA), U103.1 (1A)
/CONTACT_SENSE: R26.2, R27.1, U102.3 (INA+)
/EF_RTN: C12.2, R15.2, R16.2, R17.2, U2.3 (UVLO), U2.8 (RTN), U2.17 (PAD)
/FAULT_CLEAR: U106.8 (2Q_N), U107.6 (C)
/FAULT_FILTERED: C18.1, R38.2, U103.4 (2A)
/FAULT_RAW: R38.1, U103.3 (1Y)
/FAULT_SET_N: U103.6 (2Y), U106.10 (2PRE_N)
/FUSED: C13.1, J2.3 (S2 input), U2.15 (OUT), U2.16 (OUT)
/HOLD_CHARGE: D10.2 (A), R24.2
/HOLD_DIV: R28.2, R29.1
/HOLD_RAW: C14.1, C15.1, D10.1 (K), R28.1, U101.5 (EN), U101.8 (IN)
/HOLD_READY_H: U103.8 (3Y), U103.12 (4A)
/HOLD_READY_N: R32.2, U102.6 (OUTB), U103.9 (3A)
/HOLD_SENSE: R29.2, R30.1, U102.4 (INB-)
/ILIM: R16.1, U2.11 (ILIM)
/LED_PLUS: J2.4 (S2 return), J3.1 (LED+), R19.1, R25.1
/LED_RTN: C11.2, C13.2, C14.2, C15.2, C17.2, C18.2, C19.2, C20.2, C21.2, C22.2, C23.2, C24.2, C25.2, C26.2, C27.2, C28.2, D8.2 (A), J3.2 (LED-), R9.1, R18.2, R19.2, R27.2, R30.2, R34.2, R40.2, U1.1 (IS), U2.9 (GND), U101.4 (GND), U101.9 (PAD), U102.2 (GND), U103.7 (GND), U104.3 (GND), U105.3 (GND), U106.2 (1D), U106.3 (1CLK), U106.7 (GND), U106.11 (2CLK), U106.12 (2D), U107.2 (GND), U108.3 (GND), U109.2 (GND), U109.4 (GND), U109.6 (GND)
/MODE: R17.1, U2.6 (MODE)
/OVP: R14.2, R15.1, U2.5 (OVP)
/PERMIT_DRIVE: R35.1, U107.4 (Y)
/PERMIT_FEED: J2.1 (S1 / TH1 feed), R35.2
/PERMIT_RETURN: J2.2 (S1 / TH1 return), R33.1, R34.1, U108.2 (A)
/POR_CT: C19.1, U104.5 (CT)
/POR_N: U103.13 (4B), U104.1 (RESET_N), U106.1 (1CLR_N), U106.13 (2CLR_N), U107.1 (A)
/P_0: BR1.3 (AC1), C1.2, C2.2, C4.2, C5.2, R3.2, T1.4 (B dot), U1.16 (S), U1.17 (S), U1.18 (S), U1.19 (S)
/P_AUX: D6.2 (A), T1.3 (B)
/P_BIAS: C4.1, D6.1 (K), R5.1
/P_BLEED: R2.2, R3.1
/P_BPP: C5.1, R5.2, U1.14 (BPP)
/P_BR: BR1.1 (+), C1.1, L1.1
/P_BULK: C2.1, C3.2, CY1.1, L1.2, R2.1, R6.1, R22.2, T1.2 (P dot)
/P_CL: C3.1, D5.1 (K), R4.1
/P_CLMID: R4.2, R22.1
/P_D: D5.2 (A), T1.1, U1.24 (D)
/P_L: F1.1, J1.1 (L)
/P_LF: F1.2, R1.1
/P_LR: BR1.4 (AC2), R1.2, RV1.1
/P_N: BR1.2 (-), J1.2 (N), RV1.2
/P_V: R7.2, U1.13 (V)
/P_VMID: R6.2, R7.1
/RAW: C6.1, C11.1, C28.1, CY1.2, Q1.3 (C), R10.1, R12.1, R14.1, R24.1, T1.5 (S), U2.1 (IN), U2.2 (IN), U109.5 (VDD), ZD2.1 (K)
/READY_LATCH: U106.5 (1Q), U107.3 (B)
/READY_SET_N: U103.11 (4Y), U106.4 (1PRE_N)
/SEC_GND: C6.2, C7.2, C8.2, C9.2, C10.2, D7.2 (A), D8.1 (K), R9.2, R11.2, R23.2, U1.2 (GND), U1.5 (SR), ZD1.2 (A)
/SHDN: R18.1, R33.2, U2.7 (SHDN), U109.1 (OUT)
/SLEW: C12.1, U2.12 (dVdT)
/S_BPS: C9.1, D9.1 (K), U1.4 (BPS)
/S_DAMP: C16.2, R23.1
/S_FB: C8.1, R10.2, R11.1, U1.3 (FB)
/S_FWD: C7.1, R8.2, U1.7 (FWD)
/S_OVA: R13.1, ZD2.2 (A)
/S_OVB: D9.2 (A), R13.2
/S_SW: C16.1, D7.1 (K), R8.1, T1.6 (S dot)
/S_VO: C10.1, Q1.2 (E), U1.6 (VO)
/S_Z18: Q1.1 (B), R12.2, ZD1.1 (K)
/TIMER_PERMIT: U105.4 (MR), U108.4 (Y)
/V3V3_HOLD: C17.1, C21.1, C22.1, C23.1, C24.1, C25.1, C26.1, C27.1, R31.1, R32.1, R37.1, R39.1, U101.1 (OUT), U102.5 (VDD), U103.2 (1B), U103.10 (3B), U103.14 (VCC), U104.2 (VDD), U105.2 (VDD), U106.14 (VCC), U107.5 (VCC), U108.5 (VCC)
/V3V3_INHIBIT_SENSE: R39.2, R40.1, U109.3 (SENSE)

Notes on the sheet:
VELLUNEO E27 / ZASILACZ 8 LED W SZEREGU
SCHEMAT ROBOCZY • 230 V AC • JEDNA PCB • DO PRZEGLĄDU
Wejście i filtr
Przetwornica izolowana
Regulacja napięcia i prądu szeregu
R9: 0,130 Ω | R10: 113 kΩ | prąd LED ok. 271 mA (wstępnie)
Źródła szyn i powrotów
Odcięcie eFuse
Podtrzymanie układu ochrony
Monitor zwarcia i wyjście
J2-1 → S1 NO → TH1 NC → J2-2. J2-3 → S2 NO → J2-4.
Sterowanie rozruchem i zatrzask po zwarciu — wariant do pomiaru
Do weryfikacji: T1, dobór styków, zimny start i limity zabezpieczeń.
Blokada przy zaniku 3,3 V
U109 blokuje SHDN przy spadku 3,3 V. Pamięć awarii po utracie zasilania do opracowania.

Board: 2 copper layers, 94 parts (57 on the bottom side), 61 nets, no tracks yet.
