kamelele/Velluneo-2.0/hardware/E27/outputs/Zasilacz_RevH_Sterowanie/Zasilacz_RevH_Sterowanie.kicad_pcb

## KiCad design hardware/E27/outputs/Zasilacz_RevH_Sterowanie/Zasilacz_RevH_Sterowanie.kicad_pcb (2026-11-10)

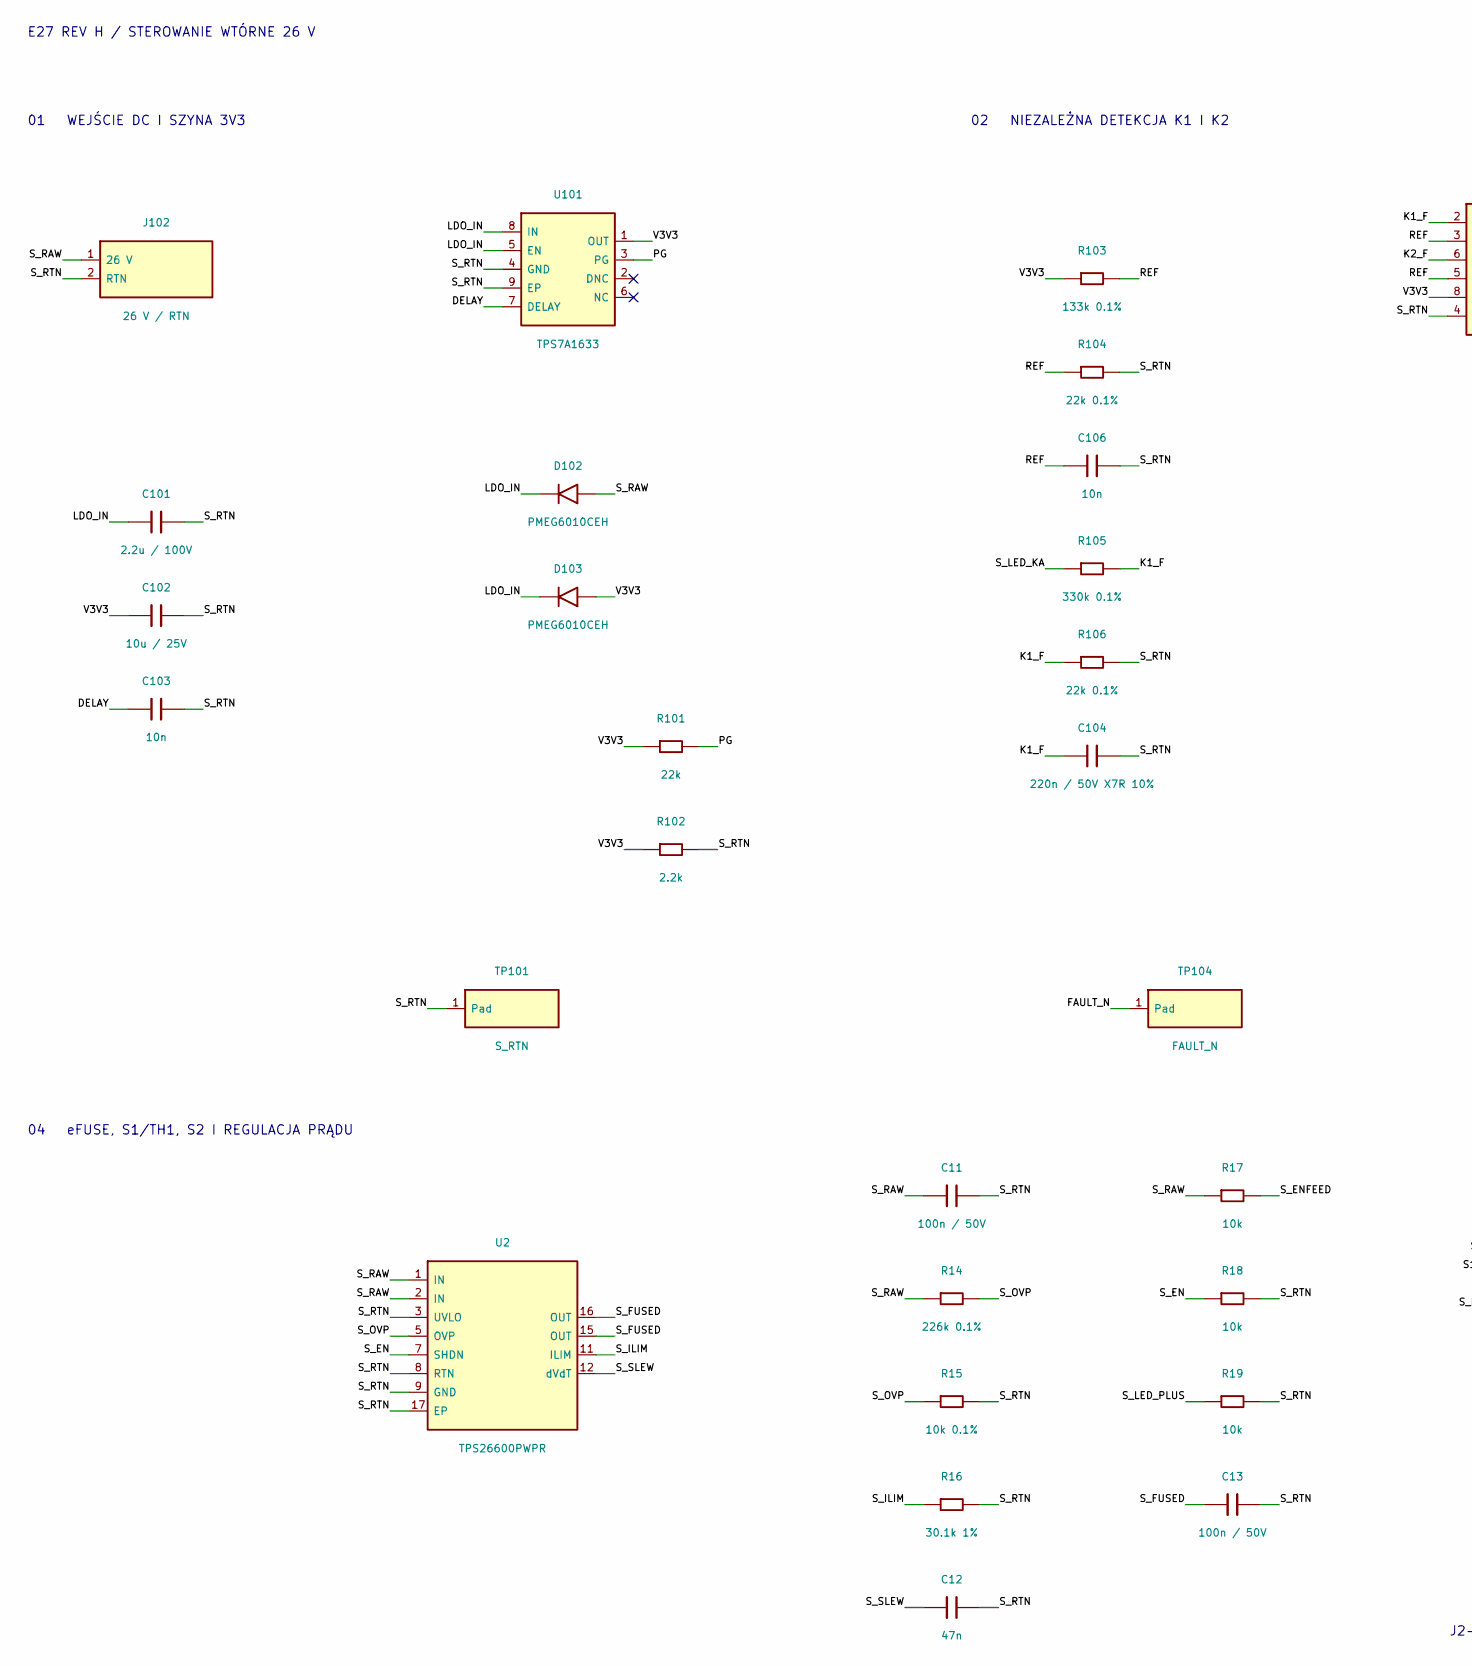
[picture p35: schematic Zasilacz_RevH_Sterowanie.kicad_sch, E27 Rev H / płytka sterowania i zabezpieczeń, part in row 1, column 1]

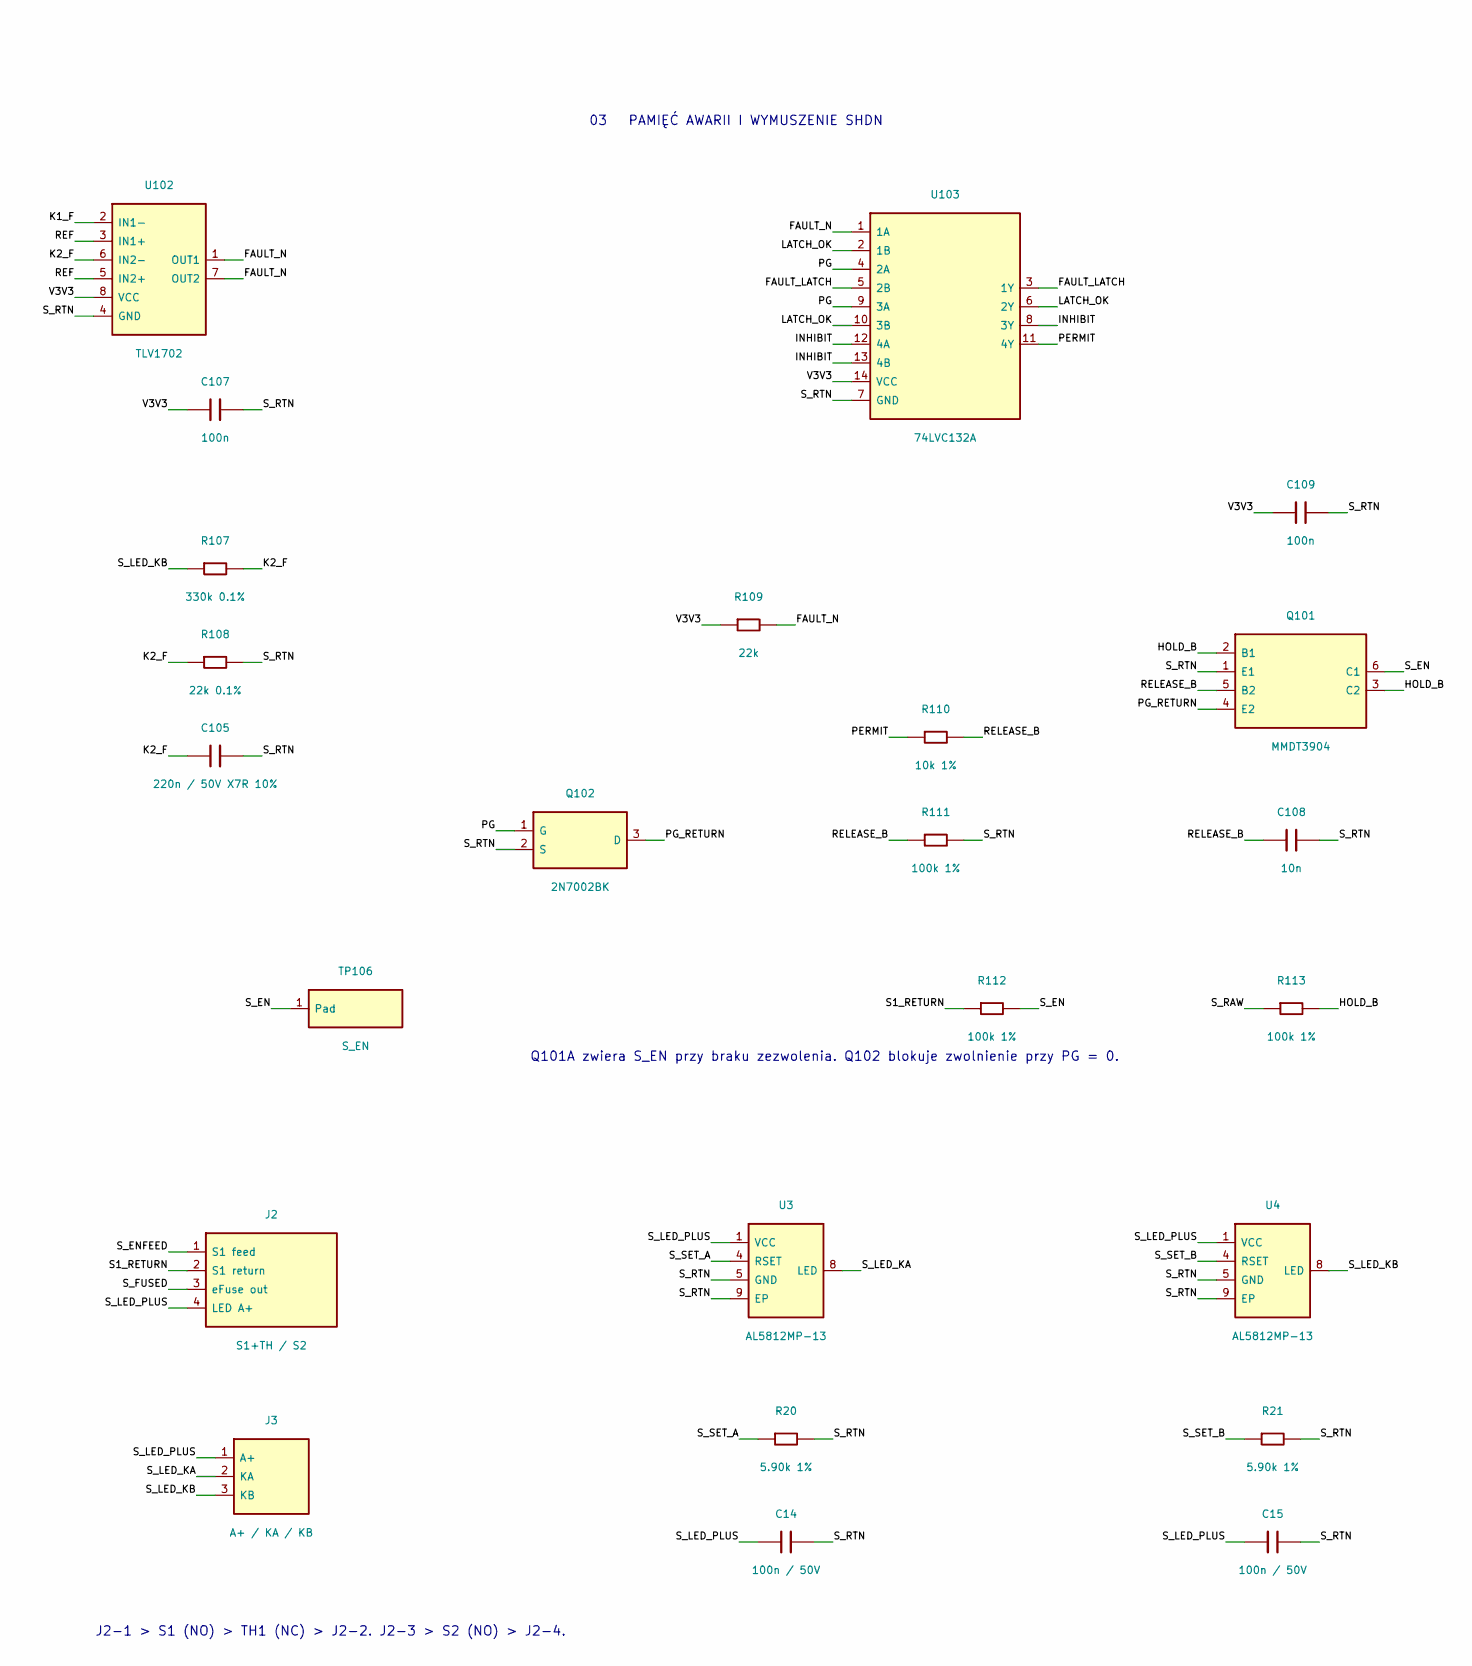
[picture p36: schematic Zasilacz_RevH_Sterowanie.kicad_sch, E27 Rev H / płytka sterowania i zabezpieczeń, part in row 1, column 2]

Parts:
C11, C13, C14, C15: 100n / 50V; C_0805_2012Metric
C12: 47n; C_0603_1608Metric
C101: 2.2u / 100V; C_1210_3225Metric
C102: 10u / 25V; C_0805_2012Metric
C103, C106, C108: 10n; C_0603_1608Metric
C104, C105: 220n / 50V X7R 10%; C_0603_1608Metric
C107, C109: 100n; C_0603_1608Metric
D102, D103: PMEG6010CEH; D_SOD-123F
J2: S1+TH / S2; Harness_4pos
J3: A+ / KA / KB; Harness_3pos
J102: 26 V / RTN; Harness_26V_RTN
Q101: MMDT3904; SOT-363_SC-70-6
Q102: 2N7002BK; SOT-23
R14: 226k 0.1%; R_0603_1608Metric
R15: 10k 0.1%; R_0603_1608Metric
R16: 30.1k 1%; R_0603_1608Metric
R17, R18: 10k; R_0603_1608Metric
R19: 10k; R_0805_2012Metric
R20, R21: 5.90k 1%; R_0603_1608Metric
R101, R109: 22k; R_0603_1608Metric
R102: 2.2k; R_0603_1608Metric
R103: 133k 0.1%; R_0603_1608Metric
R104, R106, R108: 22k 0.1%; R_0603_1608Metric
R105, R107: 330k 0.1%; R_0603_1608Metric
R110: 10k 1%; R_0603_1608Metric
R111, R112, R113: 100k 1%; R_0603_1608Metric
TP101: S_RTN; TestPoint_Pad_D1.5mm
TP104: FAULT_N; TestPoint_Pad_D1.5mm
TP106: S_EN; TestPoint_Pad_D1.5mm
U2: TPS26600PWPR; PWP0016A
U3, U4: AL5812MP-13; E27_Al5812_MSOP
U101: TPS7A1633; TPS7A16_DGN
U102: TLV1702; MSOP-8_3x3mm_P0.65mm
U103: 74LVC132A; TSSOP-14_4.4x5mm_P0.65mm

Connections:
/DELAY: C103.1, U101.7 (DELAY)
/FAULT_LATCH: U103.3 (1Y), U103.5 (2B)
/FAULT_N: R109.2, TP104.1, U102.1 (OUT1), U102.7 (OUT2), U103.1 (1A)
/HOLD_B: Q101.2 (B1), Q101.3 (C2), R113.2
/INHIBIT: U103.8 (3Y), U103.12 (4A), U103.13 (4B)
/K1_F: C104.1, R105.2, R106.1, U102.2 (IN1-)
/K2_F: C105.1, R107.2, R108.1, U102.6 (IN2-)
/LATCH_OK: U103.2 (1B), U103.6 (2Y), U103.10 (3B)
/LDO_IN: C101.1, D102.1 (K), D103.1 (K), U101.5 (EN), U101.8 (IN)
/PERMIT: R110.1, U103.11 (4Y)
/PG: Q102.1 (G), R101.2, U101.3 (PG), U103.4 (2A), U103.9 (3A)
/PG_RETURN: Q101.4 (E2), Q102.3 (D)
/REF: C106.1, R103.2, R104.1, U102.3 (IN1+), U102.5 (IN2+)
/RELEASE_B: C108.1, Q101.5 (B2), R110.2, R111.1
/S1_RETURN: J2.2 (S1 return), R112.1
/S_EN: Q101.6 (C1), R18.1, R112.2, TP106.1, U2.7 (SHDN)
/S_ENFEED: J2.1 (S1 feed), R17.2
/S_FUSED: C13.1, J2.3 (eFuse out), U2.15 (OUT), U2.16 (OUT)
/S_ILIM: R16.1, U2.11 (ILIM)
/S_LED_KA: J3.2 (KA), R105.1, U3.8 (LED)
/S_LED_KB: J3.3 (KB), R107.1, U4.8 (LED)
/S_LED_PLUS: C14.1, C15.1, J2.4 (LED A+), J3.1 (A+), R19.1, U3.1 (VCC), U4.1 (VCC)
/S_OVP: R14.2, R15.1, U2.5 (OVP)
/S_RAW: C11.1, D102.2 (A), J102.1 (26 V), R14.1, R17.1, R113.1, U2.1 (IN), U2.2 (IN)
/S_RTN: C11.2, C12.2, C13.2, C14.2, C15.2, C101.2, C102.2, C103.2, C104.2, C105.2, C106.2, C107.2, C108.2, C109.2, J102.2 (RTN), Q101.1 (E1), Q102.2 (S), R15.2, R16.2, R18.2, R19.2, R20.2, R21.2, R102.2, R104.2, R106.2, R108.2, R111.2, TP101.1, U2.3 (UVLO), U2.8 (RTN), U2.9 (GND), U2.17 (EP), U3.5 (GND), U3.9 (EP), U4.5 (GND), U4.9 (EP), U101.4 (GND), U101.9 (EP), U102.4 (GND), U103.7 (GND)
/S_SET_A: R20.1, U3.4 (RSET)
/S_SET_B: R21.1, U4.4 (RSET)
/S_SLEW: C12.1, U2.12 (dVdT)
/V3V3: C102.1, C107.1, C109.1, D103.2 (A), R101.1, R102.1, R103.1, R109.1, U101.1 (OUT), U102.8 (VCC), U103.14 (VCC)

Notes on the sheet:
E27 REV H / STEROWANIE WTÓRNE 26 V
01 WEJŚCIE DC I SZYNA 3V3
02 NIEZALEŻNA DETEKCJA K1 I K2
03 PAMIĘĆ AWARII I WYMUSZENIE SHDN
04 eFUSE, S1/TH1, S2 I REGULACJA PRĄDU
J2-1 > S1 (NO) > TH1 (NC) > J2-2. J2-3 > S2 (NO) > J2-4.
Q101A zwiera S_EN przy braku zezwolenia. Q102 blokuje zwolnienie przy PG = 0.

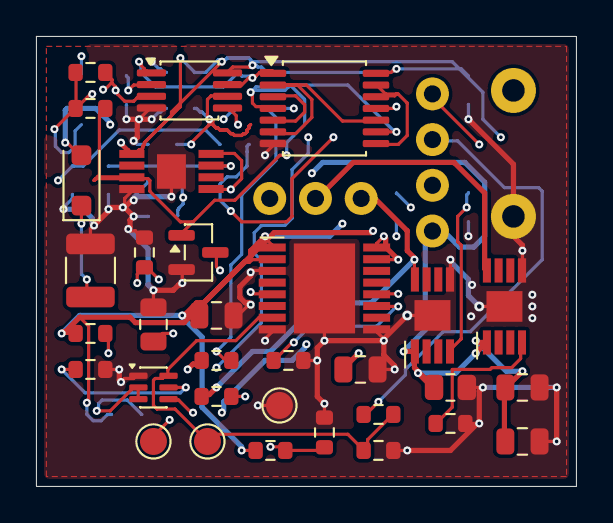
[picture p37: board Zasilacz_RevH_Sterowanie.kicad_pcb from above]

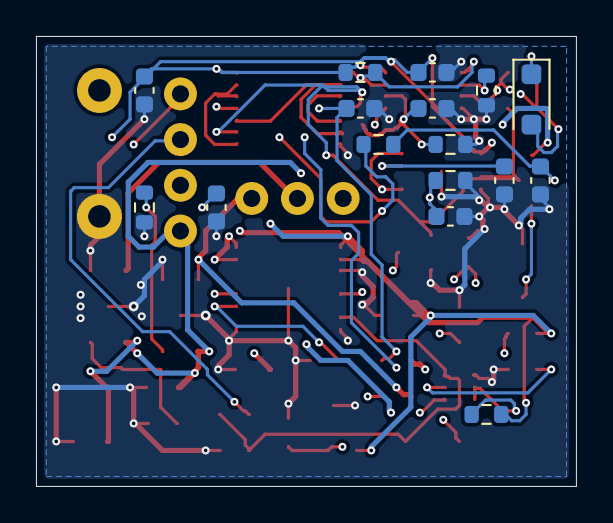
[picture p38: board Zasilacz_RevH_Sterowanie.kicad_pcb from below]

Board: 4 copper layers, 30.0 x 25.0 mm, 51 parts (16 on the bottom side), 29 nets.
