kamelele/Velluneo-2.0/hardware/E27/outputs/Zasilacz_RevB2_Ochrona/Zasilacz_RevB2_Ochrona.kicad_pcb

## KiCad design hardware/E27/outputs/Zasilacz_RevB2_Ochrona/Zasilacz_RevB2_Ochrona.kicad_pcb (2026-11-09)

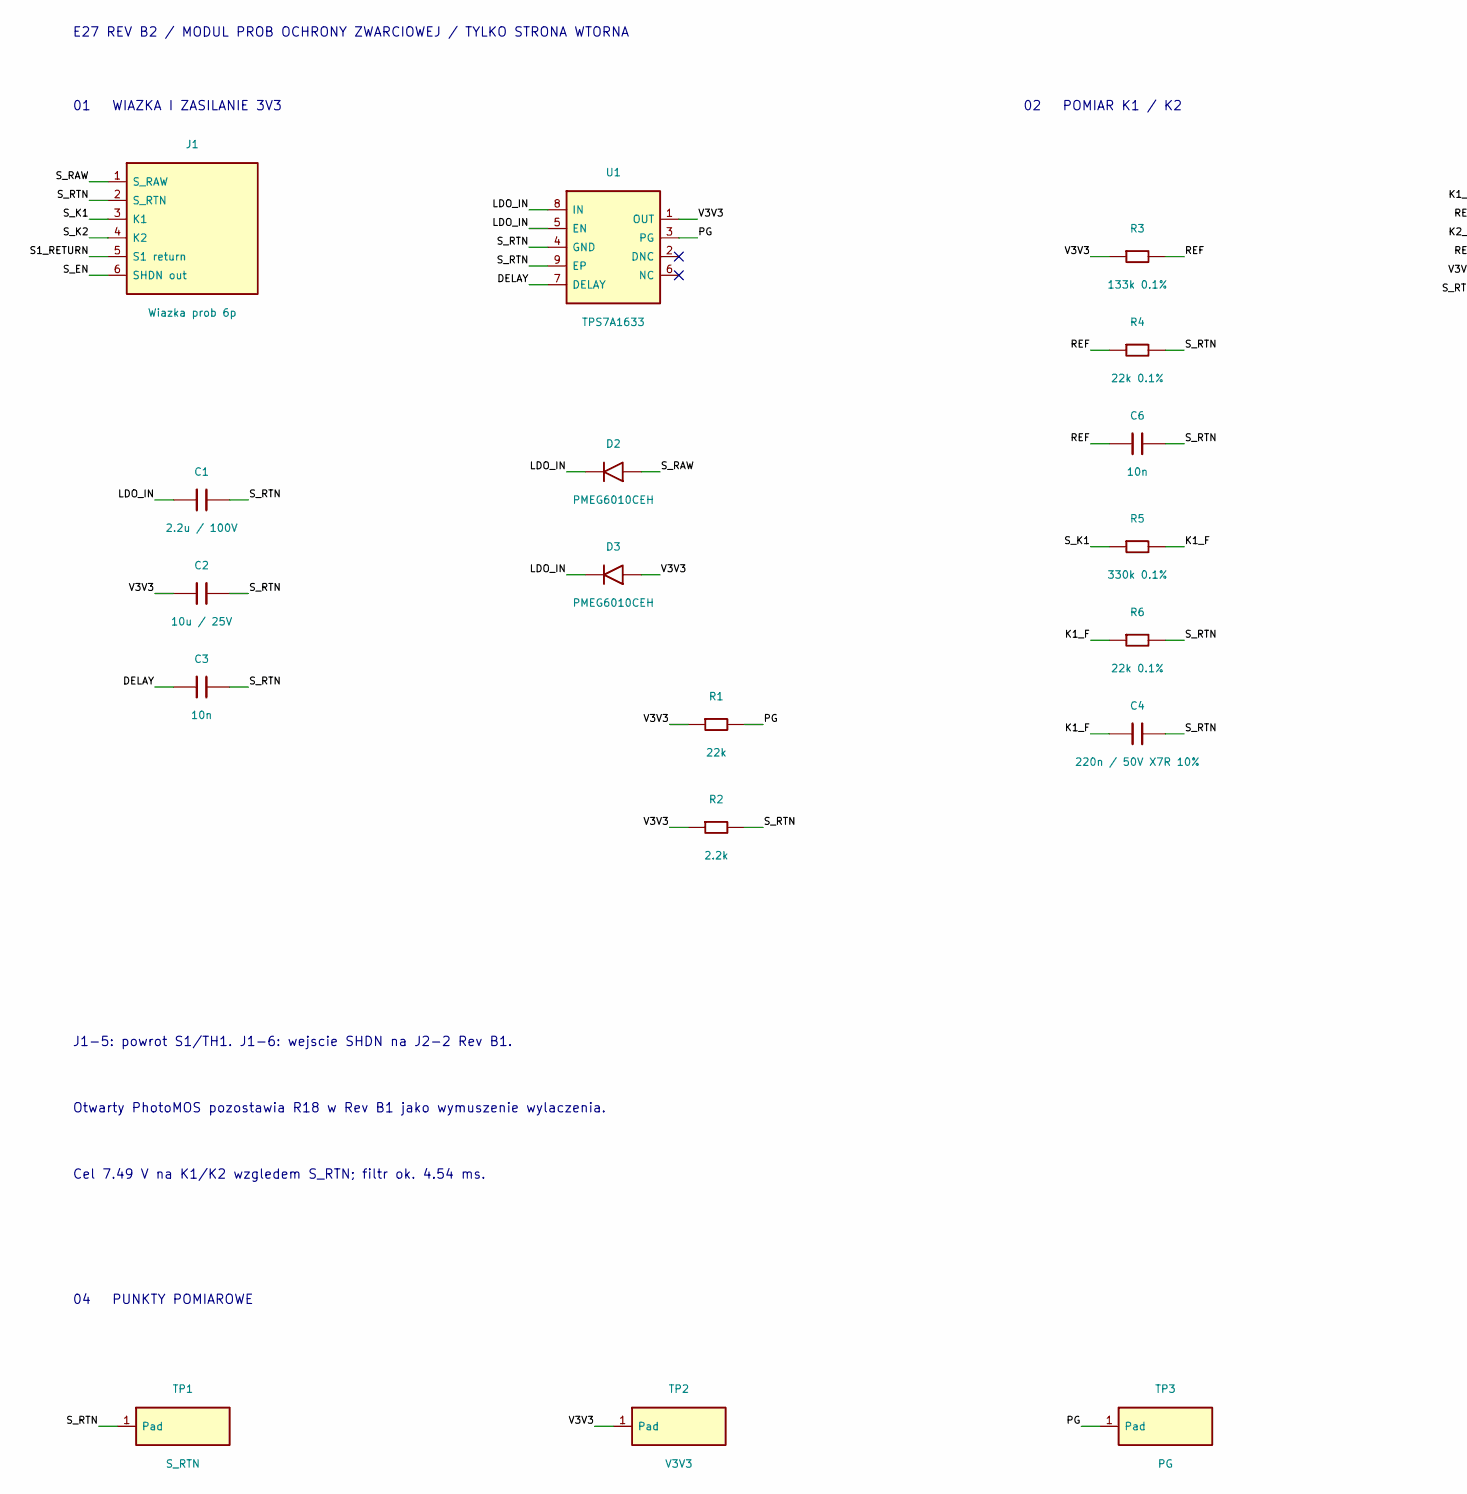
[picture p39: schematic Zasilacz_RevB2_Ochrona.kicad_sch, Modul prob ochrony zwarciowej E27 Rev B2, part in row 1, column 1]

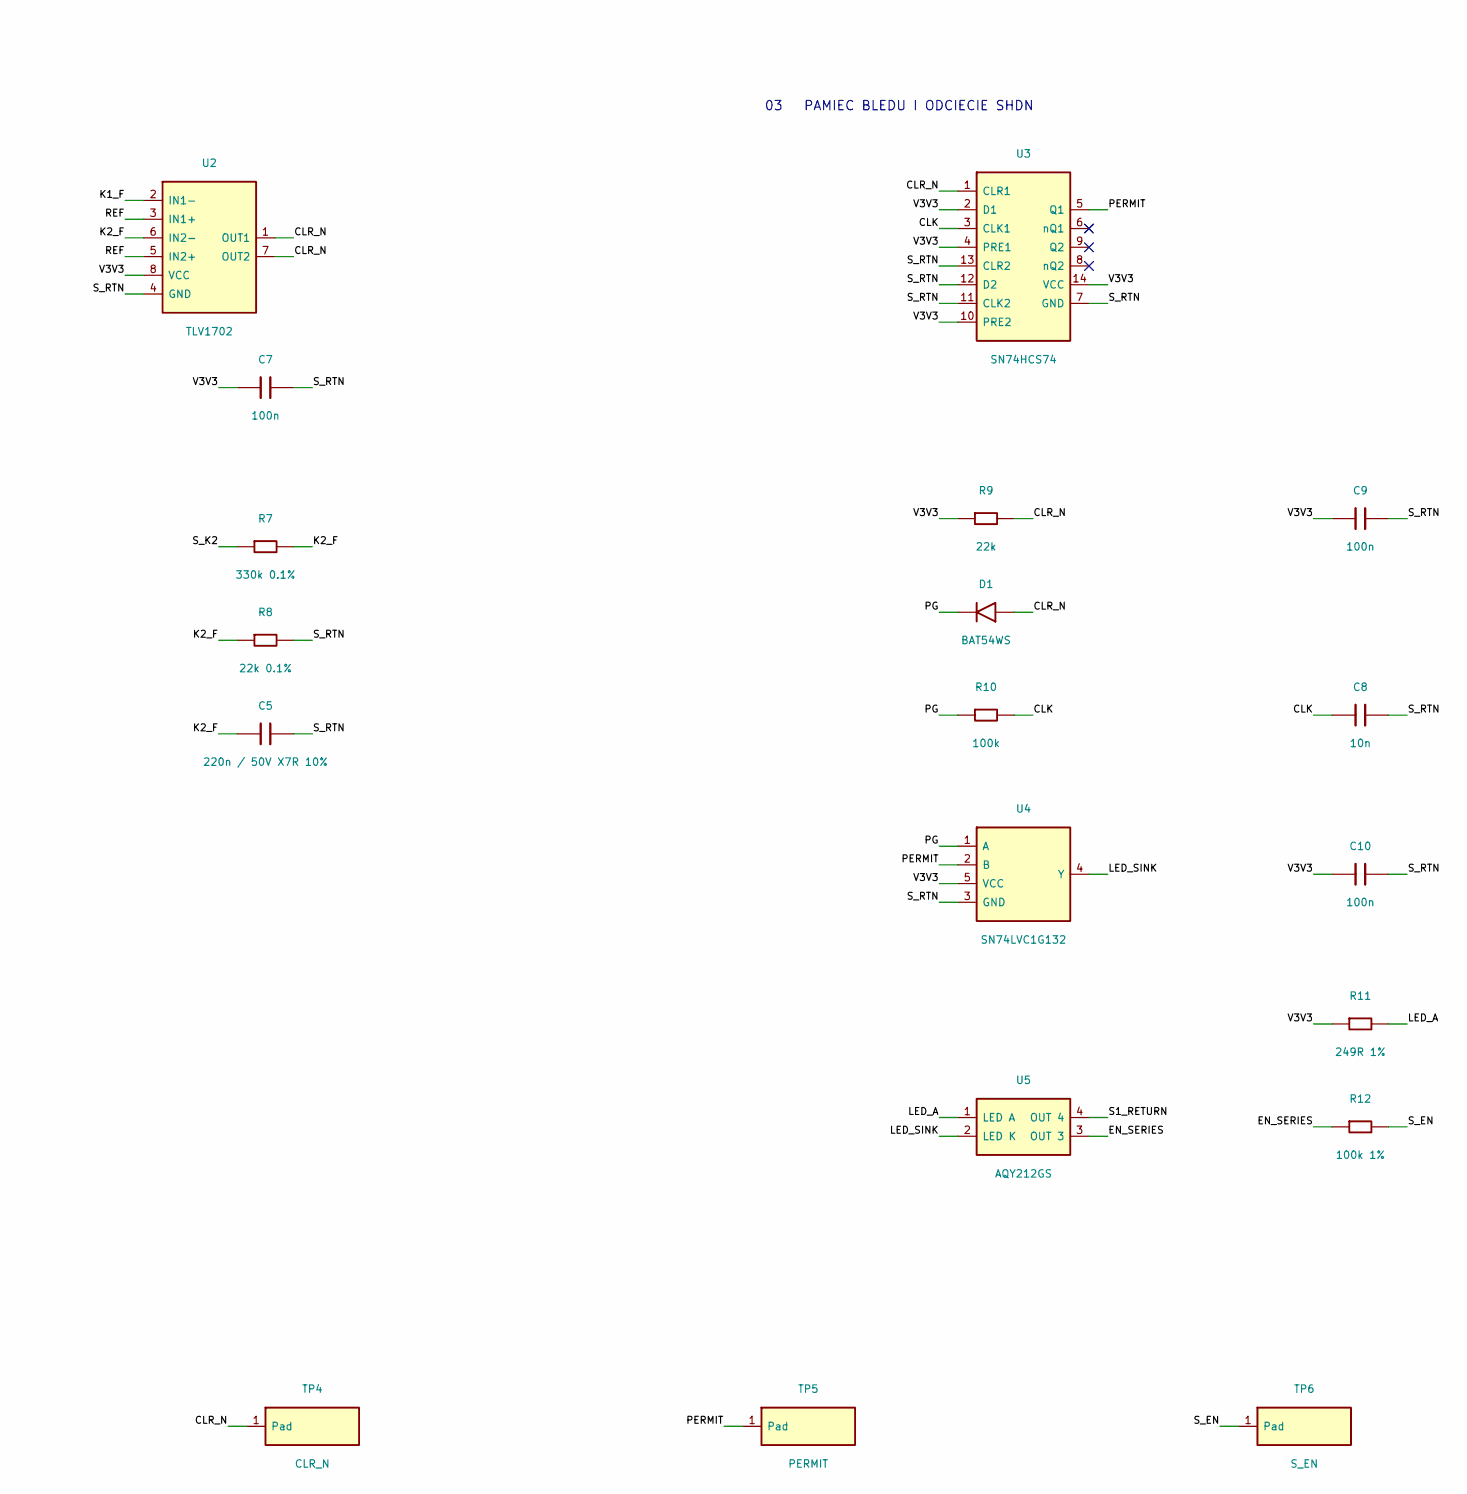
[picture p40: schematic Zasilacz_RevB2_Ochrona.kicad_sch, Modul prob ochrony zwarciowej E27 Rev B2, part in row 1, column 2]

Parts:
C1: 2.2u / 100V; C_1210_3225Metric
C2: 10u / 25V; C_0805_2012Metric
C3, C6, C8: 10n; C_0603_1608Metric
C4, C5: 220n / 50V X7R 10%; C_0603_1608Metric
C7, C9, C10: 100n; C_0603_1608Metric
D1: BAT54WS; D_SOD-323
D2, D3: PMEG6010CEH; D_SOD-123F
J1: Wiazka prob 6p; JST_XH_B6B-XH-A_1x06_P2.50mm_Vertical
R1, R9: 22k; R_0603_1608Metric
R2: 2.2k; R_0603_1608Metric
R3: 133k 0.1%; R_0603_1608Metric
R4, R6, R8: 22k 0.1%; R_0603_1608Metric
R5, R7: 330k 0.1%; R_0603_1608Metric
R10: 100k; R_0603_1608Metric
R11: 249R 1%; R_0603_1608Metric
R12: 100k 1%; R_0603_1608Metric
TP1: S_RTN; TestPoint_Pad_D1.5mm
TP2: V3V3; TestPoint_Pad_D1.5mm
TP3: PG; TestPoint_Pad_D1.5mm
TP4: CLR_N; TestPoint_Pad_D1.5mm
TP5: PERMIT; TestPoint_Pad_D1.5mm
TP6: S_EN; TestPoint_Pad_D1.5mm
U1: TPS7A1633; TPS7A16_DGN
U2: TLV1702; MSOP-8_3x3mm_P0.65mm
U3: SN74HCS74; TSSOP-14_4.4x5mm_P0.65mm
U4: SN74LVC1G132; SOT-23-5
U5: AQY212GS; AQY212GS_SOP4

Connections:
/CLK: C8.1, R10.2, U3.3 (CLK1)
/CLR_N: D1.2 (A), R9.2, TP4.1, U2.1 (OUT1), U2.7 (OUT2), U3.1 (CLR1)
/DELAY: C3.1, U1.7 (DELAY)
/EN_SERIES: R12.1, U5.3 (OUT 3)
/K1_F: C4.1, R5.2, R6.1, U2.2 (IN1-)
/K2_F: C5.1, R7.2, R8.1, U2.6 (IN2-)
/LDO_IN: C1.1, D2.1 (K), D3.1 (K), U1.5 (EN), U1.8 (IN)
/LED_A: R11.2, U5.1 (LED A)
/LED_SINK: U4.4 (Y), U5.2 (LED K)
/PERMIT: TP5.1, U3.5 (Q1), U4.2 (B)
/PG: D1.1 (K), R1.2, R10.1, TP3.1, U1.3 (PG), U4.1 (A)
/REF: C6.1, R3.2, R4.1, U2.3 (IN1+), U2.5 (IN2+)
/S1_RETURN: J1.5 (S1 return), U5.4 (OUT 4)
/S_EN: J1.6 (SHDN out), R12.2, TP6.1
/S_K1: J1.3 (K1), R5.1
/S_K2: J1.4 (K2), R7.1
/S_RAW: D2.2 (A), J1.1 (S_RAW)
/S_RTN: C1.2, C2.2, C3.2, C4.2, C5.2, C6.2, C7.2, C8.2, C9.2, C10.2, J1.2 (S_RTN), R2.2, R4.2, R6.2, R8.2, TP1.1, U1.4 (GND), U1.9 (EP), U2.4 (GND), U3.7 (GND), U3.11 (CLK2), U3.12 (D2), U3.13 (CLR2), U4.3 (GND)
/V3V3: C2.1, C7.1, C9.1, C10.1, D3.2 (A), R1.1, R2.1, R3.1, R9.1, R11.1, TP2.1, U1.1 (OUT), U2.8 (VCC), U3.2 (D1), U3.4 (PRE1), U3.10 (PRE2), U3.14 (VCC), U4.5 (VCC)

Notes on the sheet:
E27 REV B2 / MODUL PROB OCHRONY ZWARCIOWEJ / TYLKO STRONA WTORNA
01 WIAZKA I ZASILANIE 3V3
02 POMIAR K1 / K2
03 PAMIEC BLEDU I ODCIECIE SHDN
04 PUNKTY POMIAROWE
J1-5: powrot S1/TH1. J1-6: wejscie SHDN na J2-2 Rev B1.
Otwarty PhotoMOS pozostawia R18 w Rev B1 jako wymuszenie wylaczenia.
Cel 7.49 V na K1/K2 wzgledem S_RTN; filtr ok. 4.54 ms.

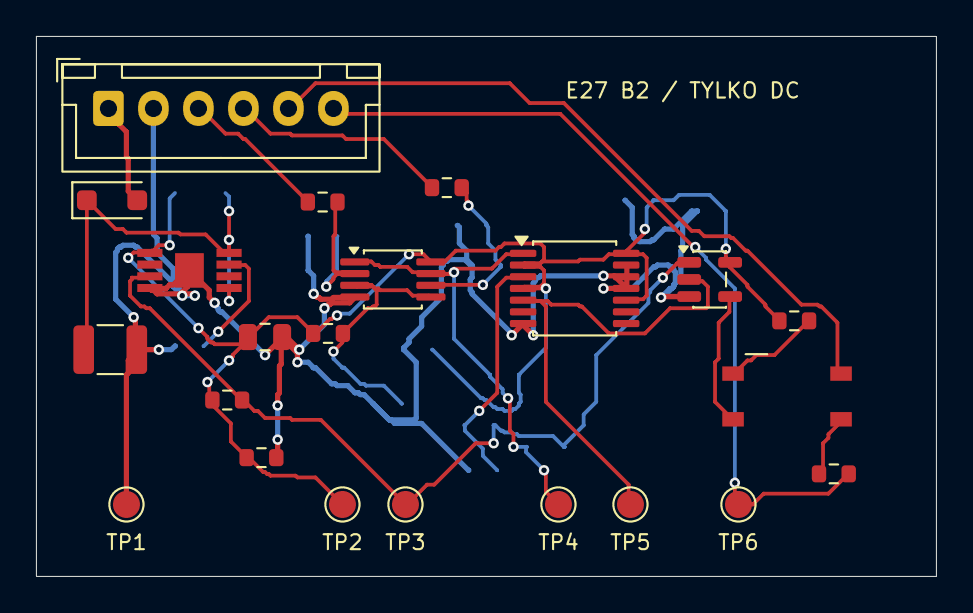
[picture p41: board Zasilacz_RevB2_Ochrona.kicad_pcb from above]

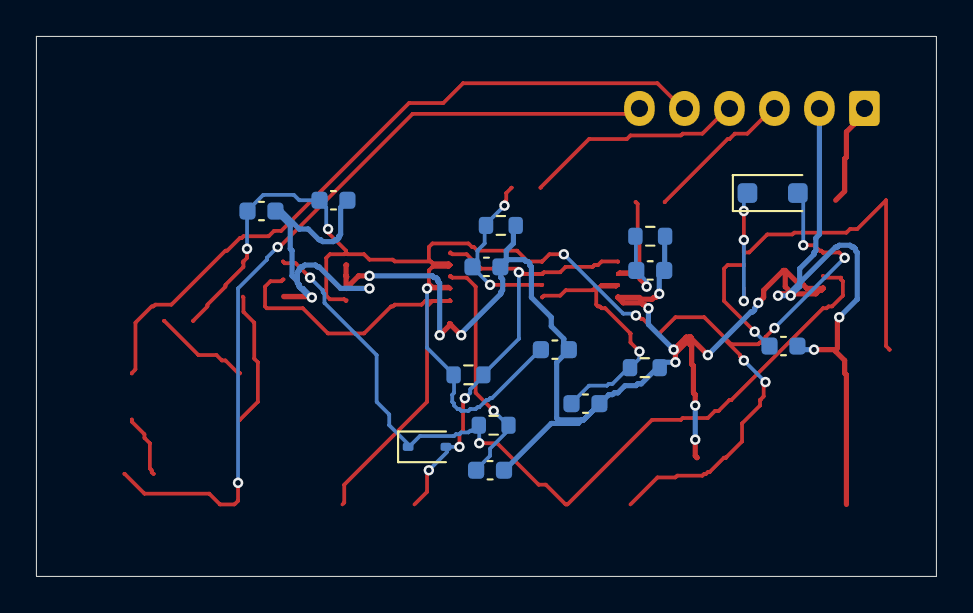
[picture p42: board Zasilacz_RevB2_Ochrona.kicad_pcb from below]

Board: 2 copper layers, 50.0 x 30.0 mm, 37 parts (15 on the bottom side), 19 nets.
