kamelele/Velluneo-2.0/hardware/E27/outputs/Wklad_LED/Wklad_LED.kicad_pcb

## KiCad design hardware/E27/outputs/Wklad_LED/Wklad_LED.kicad_pcb (2026-11-09)

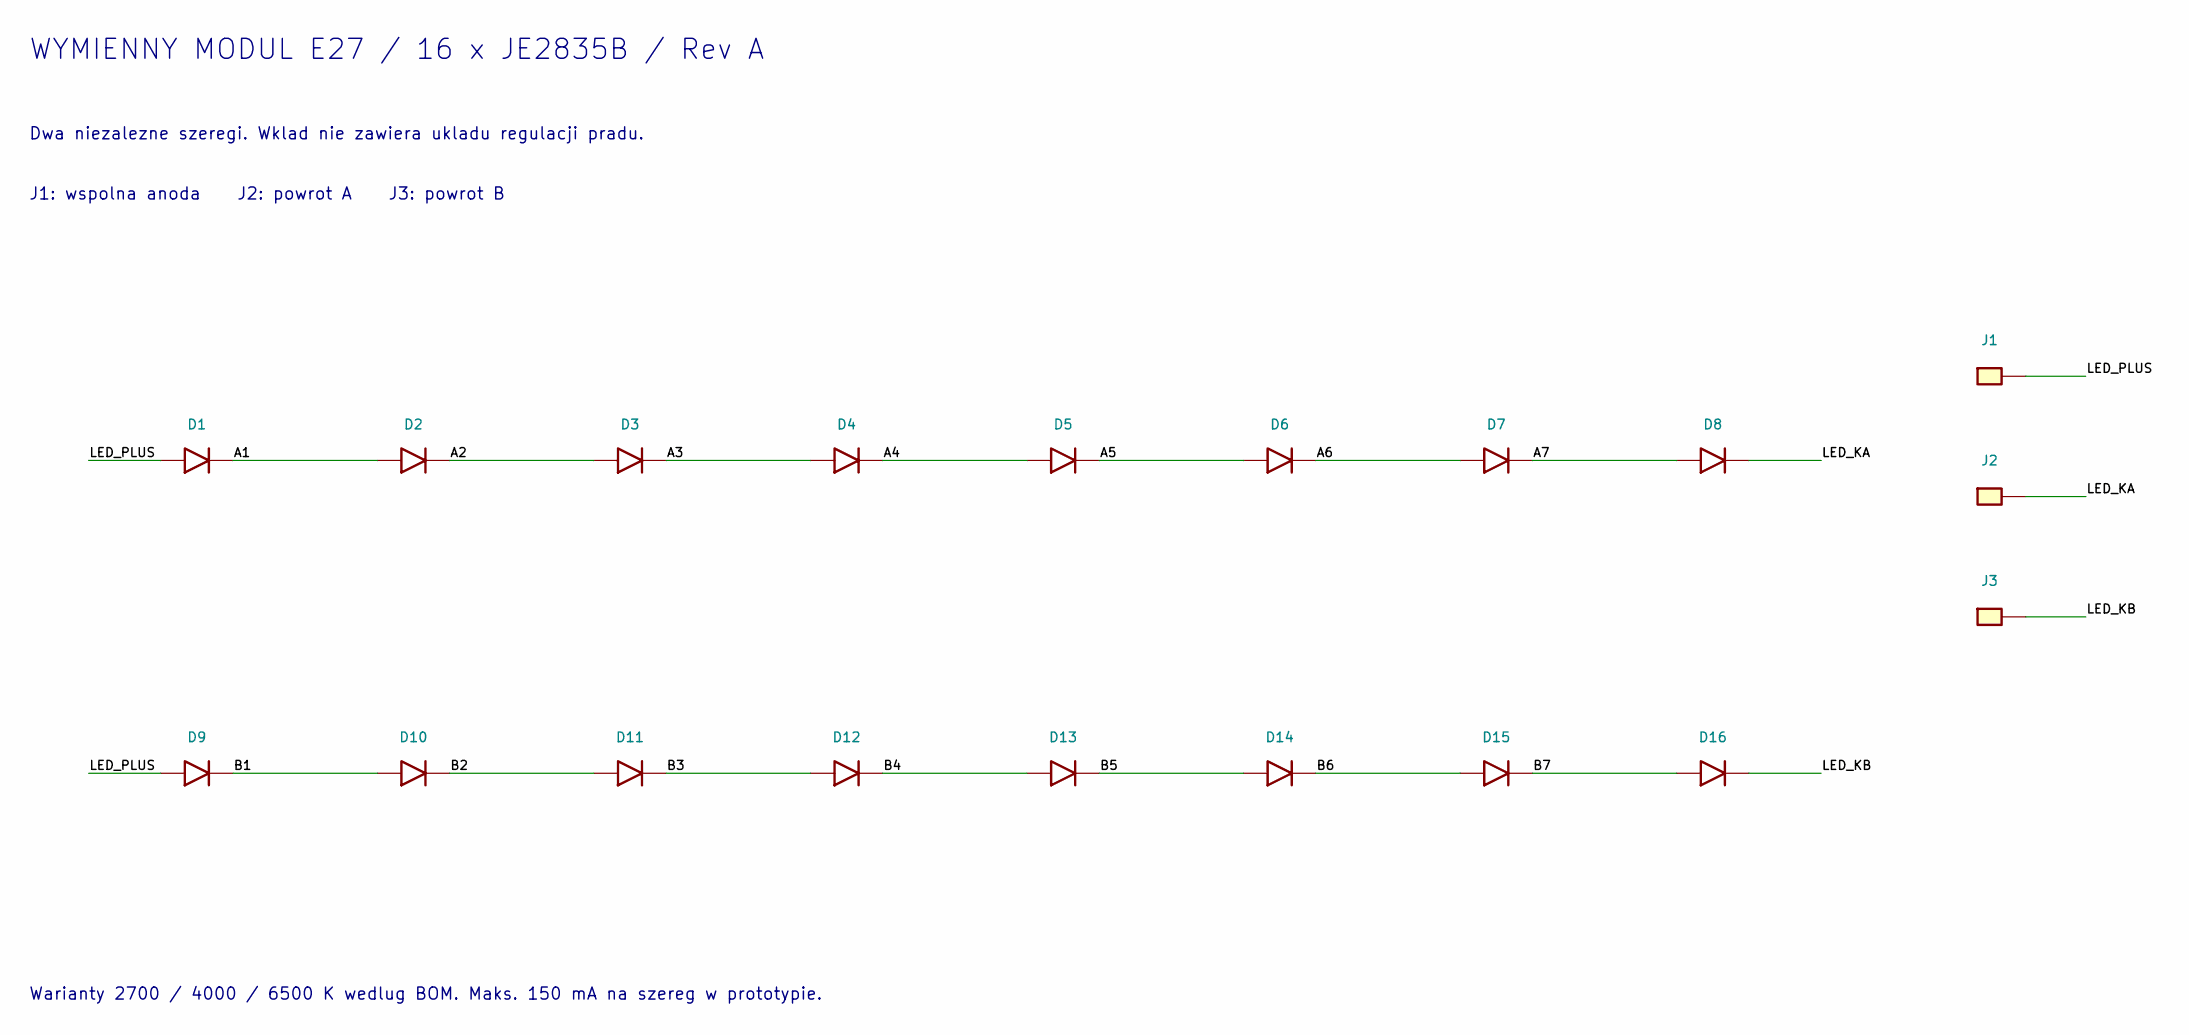
[picture p43: schematic Wklad_LED.kicad_sch, Wymienny modul LED - Rev A]

Parts:
D1, D2, D3, D4, D5, D6, D7, D8, D9, D10, D11, D12, D13, D14, D15, D16: JE2835B; Cree_JE2835B
J1: LED_PLUS; SpringPad
J2: LED_KA; SpringPad
J3: LED_KB; SpringPad

Connections:
/A1: D1.1 (K), D2.2 (A)
/A2: D2.1 (K), D3.2 (A)
/A3: D3.1 (K), D4.2 (A)
/A4: D4.1 (K), D5.2 (A)
/A5: D5.1 (K), D6.2 (A)
/A6: D6.1 (K), D7.2 (A)
/A7: D7.1 (K), D8.2 (A)
/B1: D9.1 (K), D10.2 (A)
/B2: D10.1 (K), D11.2 (A)
/B3: D11.1 (K), D12.2 (A)
/B4: D12.1 (K), D13.2 (A)
/B5: D13.1 (K), D14.2 (A)
/B6: D14.1 (K), D15.2 (A)
/B7: D15.1 (K), D16.2 (A)
/LED_KA: D8.1 (K), J2.1
/LED_KB: D16.1 (K), J3.1
/LED_PLUS: D1.2 (A), D9.2 (A), J1.1

Notes on the sheet:
WYMIENNY MODUL E27 / 16 x JE2835B / Rev A
Dwa niezalezne szeregi. Wklad nie zawiera ukladu regulacji pradu.
J1: wspolna anoda J2: powrot A J3: powrot B
Warianty 2700 / 4000 / 6500 K wedlug BOM. Maks. 150 mA na szereg w prototypie.

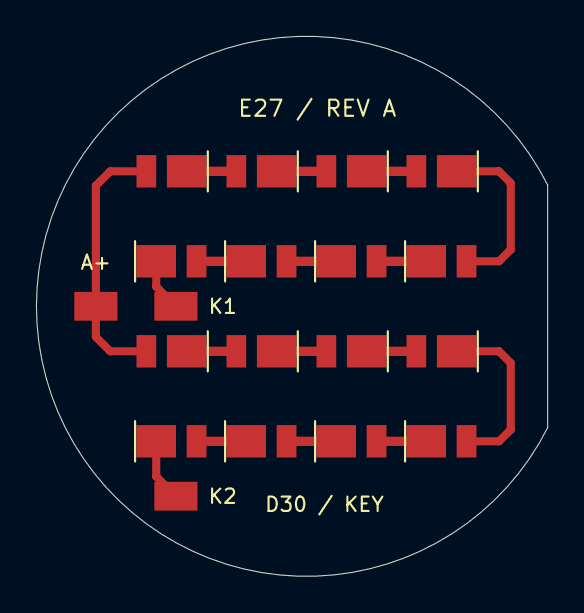
[picture p44: board Wklad_LED.kicad_pcb from above]

Board: 2 copper layers, 28.4 x 30.0 mm, 19 parts (0 on the bottom side), 17 nets.
