kamelele/Velluneo-2.0/(commit log)

2026-11-09 Add E27 KiCad projects and laboratory revisions A and B
    [BOM_E27_RevA.csv, BOM_Zasilacz_RevB.csv, Koszt_produkcji_RevA.csv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]
2026-11-09 Study low-profile E27 packaging and EFD20 transformer
    [BOM_Zasilacz_RevB.csv, E27_RevC_Gabaryty.kicad_pcb]
2026-11-09 Add E27 Rev B1 thermal copper and verification
    [CPL_Zasilacz_KiCad.csv, Zasilacz_RevB1-B_Cu.gbl, Zasilacz_RevB1-B_Mask.gbs, Zasilacz_RevB1-B_Paste.gbp, Zasilacz_RevB1-B_Silkscreen.gbo, Zasilacz_RevB1-Edge_Cuts.gm1, Zasilacz_RevB1-F_Cu.gtl, Zasilacz_RevB1-F_Mask.gts]
2026-11-09 Add Rev B2 channel-short test adapter and SHDN correction
    [BOM_RevB2.csv, Model_RevB2_przypadki.csv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]
2026-11-09 Integrate E27 supply and protection for JLCPCB quoting
    [BOM_JLCPCB.csv, BOM_pelny_RevD.csv, Pozycje_poza_importem.csv, Zasilacz_RevD_JLCPCB.kicad_pcb, Zasilacz_RevD_JLCPCB.kicad_sch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]
2026-11-09 Study compact E27 board layouts and add realistic 3D previews
    [E_Jedna.kicad_pcb, E_Moc.kicad_pcb, E_Sterowanie.kicad_pcb]
2026-11-09 Show both Rev E boards side by side
2026-11-09 Add Rev E assembled and bare board previews based on the JLCPCB reference
2026-11-10 Complete routed Rev F split E27 power supply
    [BOM_JLCPCB.csv, BOM_RevF.csv, Model_RevF.csv, Poza_importem.csv, Zasilacz_RevF_Moc.kicad_pcb, Zasilacz_RevF_Moc.kicad_sch, Zasilacz_RevF_Sterowanie.kicad_pcb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]
2026-11-10 Improve E27 flyback clamp and qualify Rev G for quoting
    [BOM_JLCPCB.csv, BOM_RevG.csv, Model_RCD.csv, Poza_importem.csv, Zasilacz_RevG_Moc.kicad_pcb, Zasilacz_RevG_Moc.kicad_sch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]
2026-11-10 Add thermal vias to Rev G E27 control board
    [BOM_JLCPCB.csv, BOM_RevG.csv, Poza_importem.csv, Zasilacz_RevG_Sterowanie.kicad_pcb, Zasilacz_RevG_Sterowanie.kicad_sch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]
2026-11-10 Add E27 secondary damping provision and expand JLC quote BOM
    [BOM_JLCPCB.csv, BOM_RevH.csv, Poza_importem.csv, Zasilacz_RevH_Moc.kicad_pcb, Zasilacz_RevH_Moc.kicad_sch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]
2026-11-10 Model E27 inrush and compare mains harmonic correction
    [Model_valley_fill.csv, Model_valley_fill_tolerancje.csv, Model_wejscia.csv]
2026-11-10 Quantify bypass capacitance tradeoff for E27 valley-fill
    [Model_valley_fill_HF.csv]
2026-11-10 Fit E27 Rev J valley-fill placement in the Rev H outline
    [Zasilacz_RevJ_Studium.kicad_pcb, Zasilacz_RevJ_Studium.kicad_sch]
2026-11-10 Audit E27 mains spacing with valid KiCad rules
    [Zasilacz_RevJ_Studium.kicad_pcb, Zasilacz_RevJ_Studium.kicad_sch]
2026-11-10 Straighten E27 control board routing and export Rev H prototype files
    [BOM_JLCPCB.csv, BOM_RevH.csv, Poza_importem.csv, Zasilacz_RevH_Sterowanie.kicad_pcb, Zasilacz_RevH_Sterowanie.kicad_sch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]
2026-11-10 Release checked Rev K power-board prototype layout
    [BOM_JLCPCB.csv, BOM_RevK.csv, Poza_importem.csv, Zasilacz_RevK_Moc.kicad_pcb, Zasilacz_RevK_Moc.kicad_sch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]
2026-11-10 Record verified JLCPCB prototype handoff for both E27 boards
2026-11-10 Record fully routed four-layer E27 valley-fill study
    [Zasilacz_RevL_Studium.kicad_pcb, Zasilacz_RevL_Studium.kicad_sch]
2026-11-11 Adopt pinned PCB toolkit workflow for Velluneo E27
2026-11-12 Record 8S specification acceptance and prepare schematic interface
    [schematic-prep-check.json]
2026-11-12 Show single-board 8S driver circuit and protection changes
2026-11-12 Review 8S driver pin intent and close polarity finding
2026-11-12 Record actual 16 LED CAD baseline and prepare 8S capture input
2026-11-12 Add native KiCad draft for one-string 8S driver
    [Zasilacz_8S_Draft.kicad_sch]
2026-11-12 Add startup and short-circuit control to 8S KiCad draft
    [Zasilacz_8S_Draft.kicad_sch]
2026-11-14 Harden 8S timer input and retain fresh D3 schematic evidence
    [Zasilacz_8S_Draft.kicad_sch]
2026-11-14 Preview single-board 8S-D3 placement and check fault retention
    [Rozmieszczenie_8S_D3.kicad_pcb]
2026-11-14 Preview compact 70 mm single-board 8S-D3 placement
    [Rozmieszczenie_8S_D3_Kompakt.kicad_pcb]
2026-11-14 Add 8S-D4 undervoltage inhibit and compact placement draft
    [Zasilacz_8S_D4.kicad_pcb, Zasilacz_8S_D4.kicad_sch]
2026-11-14 Study compact two-contact LED output and probe limits
    [8S-D5-Studium.kicad_pcb]
2026-11-14 Screen two-level LED detection and independent probe timing
